fablabbcn/smartcitizen-kit-2x/hardware/README.md

Smart Citizen Kit 2.X Hardware
==============================

This folder contains the Eagle design files for the Smart Citizen Kit 2.X, as well as the silkscreen and manufacturing files:

## SCK 2.1 (discontinued for sensor availability)

- Production files:
    + [SCK 2.1 Data Board production files](SCK2.1/SCK_DATA_BOARD_2.1/SCK_DATA_BOARD_2.1_PRODUCTION.zip)
    + [SCK 2.1 Urban Board production files](SCK2.1/SCK_URBAN_BOARD_2.1/SCK_URBAN_BOARD_2.1_PRODUCTION.zip)
- Design files:
    + [SCK 2.1 Data Board design files](SCK2.1/SCK_DATA_BOARD_2.1)
    + [SCK 2.1 Urban Board design files](SCK2.1/SCK_URBAN_BOARD_2.1)
- [Silkscreen](SCK2.1/SCK_2.1_SILKSCREEN.pdf)
- [Test plan](SCK2.1/test/SCK_2.1_TESTPLAN.pdf), also [at the docs](https://docs.smartcitizen.me/assets/notes/SCK_2.1_TESTPLAN.pdf)
- [Bootloader](SCK2.1/bootloader)

## SCK 2.2 (only for some projects)

- Production files:
    + [SCK 2.2 Data Board production files](SCK2.2/SCK_DATA_BOARD_2.2/SCK_DATA_BOARD_2.2_PRODUCTION.zip)
    + [SCK 2.2 Urban Board production files](SCK2.2/SCK_URBAN_BOARD_2.2/SCK_URBAN_BOARD_2.2_PRODUCTION.zip)
- Design files:
    + [SCK 2.2 Data Board design files](SCK2.2/SCK_DATA_BOARD_2.2)
    + [SCK 2.2 Urban Board design files](SCK2.2/SCK_URBAN_BOARD_2.2)
- [Silkscreen](SCK2.2/SCK2.2_SILKSCREEN.pdf)
- [Test plan](SCK2.2/test/SCK2.2_TESTPLAN.pdf)
- [Bootloader](SCK2.2/bootloader)

## SCK 2.3 (current)

- Production files:
    + [SCK 2.3 Data Board production files](SCK2.3/SCK_DATA_BOARD_2.3/SCK_DATA_BOARD_2.3_PRODUCTION.zip)
    + [SCK 2.3 Urban Board production files](SCK2.3/SCK_URBAN_BOARD_2.3/SCK_URBAN_BOARD_2.3_PRODUCTION.zip)
- Design files:
    + [SCK 2.3 Data Board design files](SCK2.3/SCK_DATA_BOARD_2.3)
    + [SCK 2.3 Urban Board design files](SCK2.3/SCK_URBAN_BOARD_2.3)
- [Test plan](SCK2.3/test/SCK2.3_TESTPLAN.pdf)
- [Bootloader](SCK2.3/bootloader)

Note: for Data Board schematics, see [SCK_DATA_2.1 folder](SCK2.1/SCK_DATA_BOARD_2.1)

## License

All the software is released under [GNU GPL v3.0](../LICENSE) and the hardware design files under [CERN OHL v1.2](LICENSE)
