fablabbcn/smartcitizen-kit-2x/hardware/SCK2.3/SCK_DATA_BOARD_2.3/SCK_DATA_BOARD_2.3_for_Manufacture/03-SCK_DATA_BOARD_2.3_PCB_specification.xlsx

Sheet: Template
PCB Name 名称
Board Size 尺寸 | Length*width (Unit:mm) | 58.19 | * | 56.41
Material 板材 |  | Special Requirement:
Layers 层数 |  | Special Requirement:
Thickness 厚度 |  | Special Requirement:
Copper Weight 铜厚 |  | Special Requirement:
Soldermask Color 阻焊颜色 |  | Special Requirement:
Silkscreen Color 丝印颜色 |  | Blue
Surface Finishing 焊盘喷镀 |  | Special Requirement:
Via soldermask 阻焊覆盖 |  | Special Requirement:
Mini trace/spacing 最小线宽 |  | Special Requirement:
Mini hole size 最小孔径 |  | Special Requirement:
Special requirements 特殊工艺
 | Other Special requirements：

Sheet: Parameter
PCB Material | Layers | Thickness | Copper Weight | Soldermask Color | Silkscreen Color | Surface Finishing | Via soldermask | Mini trace/spacing | Mini hole size
FR-4 | 1 Layer | 0.6mm | 0.5 oz | Green | White | HASL Lead Free(RoHS) | Soldermask Cover | 4 mil or 0.10 mm | 6 mil or 0.15 mm
Flexible Printed Circuit | 2 Layer | 0.8mm | 1 oz | Red | Black | ENIG | Soldermask Opening | 5 mil or0.13 mm | 8 mil or 0.2 mm
Rogers 4003 | 4 Layer | 1.0mm | 2 oz | Blue | Yellow | OSP |  | 6 mil or 0.15 mm | 10 mil or 0.25 mm
Rogers 4350 | 6 Layer | 1.2mm | 3 oz | Black | Red | Immersion Tin |  | 8 mil or 0.20 mm | 12 mil or 0.30 mm
Taconic Series | 8 Layer | 1.3mm | Other | White | Other | Immersion Sliver
Aluminum-based material | 10 Layer | 1.6mm |  | Green Matte |  | Hard Gold
RF-35 | 12 Layer | 2.0mm |  | Blue Matte |  | Other
Arlon | 14 Layer | 2.5mm |  | Black Matte
Other | 16 Layer | 3.0mm |  | Other
 | Other | Other
