fablabbcn/smartcitizen-kit-2x/hardware/SCK2.3/SCK_URBAN_BOARD_2.3/SCK_URBAN_BOARD_2.3_for_Manufacture/01-SCK_URBAN_BOARD_2.3_BOM.xlsx

Quantity | Designator | Value/Tolerance | Footprint | Manufacturer | Manufacturer Part Number | Description | Seeed OPL
1 | R1 | 100K | R0402 | Yageo | RC0402FR-07100KL | SMD-RES-100K-1%-1/16W(0402)
1 | R2 | 3M3 | R0402 | Yageo | RC0402FR-073M3L | Thick Film Resistors - SMD 3.3 MOhms 62.5mW 0402 1%
9 | C1, C2, C3, C4, C5, C6, C7, C8,C11 | 100n | C0402 | Yageo | CC0402KRX7R8BB104 | CERAMIC-100NF-25V-10%-X7R(0402)
1 | C9, C10 | 10u | C0603 | Yageo | CC0603KRX5R6BB106 | CERAMIC-10UF-10V-10%-X5R(0603)
6 | L1, L2, L3, L4, L5, L6 | MPZ1005S121C | L0402 | TDK Corporation | MPZ1005S121CT000 | FERRITE BEAD 120 OHM 0402 1LN
1 | S1 | MPL3115A2S | LGA8 | NXP Semiconductors | MPL3115A2ST1 | Board Mount Pressure Sensors Horizon I2C ST |  | https://eu.mouser.com/ProductDetail/NXP-Semiconductors/MPL3115A2ST1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
1 | S2 | Spectral UVA/B/C Sensor | OLGA16 | AMS | AS7331-AQFM | Spectral UVA/B/C Sensor |  | https://www.mouser.com/catalog/specsheets/amsOsram_AS7331_DS001047_1-00.pdf
1 | S3 | MIC MEMS DIGITAL I2S OMNI -26DB | ICS-43432 | TDK InvenSense | ICS-43432 | MIC MEMS DIGITAL I2S OMNI -26DB
1 | S4 | SENSOR HUMID/TEMP 5V I2C 2% SMD | DFN8_STH3X-DIS | Sensirion AG | SHT31-DIS-F | SENSOR HUMID/TEMP 5V I2C 2% SMD
1 | S5 | IC AMBIENT LIGHT SENSOR 6-WSOF | WSOF6 | Rohm Semiconductor | BH1730FVC-TR | IC AMBIENT LIGHT SENSOR 6-WSOF
1 | PM_SENSOR | SM06B-GHS-TB | SM06B-GHS-TB | JST Sales America Inc. | SM06B-GHS-TB | CONN HEADER SMD R/A 6POS 1.25MM |  | https://www.digikey.es/es/products/detail/jst-sales-america-inc/SM06B-GHS-TB-LF-SN/807836?productid=
1 | CONN_DATA | CONN HEADER SMD 16POS 2.54MM | PINHD_2X8_SMD_MALE_UNHOLED | Molex, LLC | 15910160 | CONN HEADER SMD 16POS 2.54MM
