fablabbcn/smartcitizen-kit-2x/hardware/SCK2.3/SCK_DATA_BOARD_2.3/SCK_DATA_BOARD_2.3_for_Manufacture/01-SCK_DATA_BOARD_2.3_BOM.xlsx

Quantity | Designator | Value/Tolerance | Footprint | Manufacturer | Manufacturer Part Number | Description | Seeed OPL
17 | R2, R3, R5, R12, R13, R14, R16, R17, R22, R23, R24, R25, R26, R27, R28, R29, R30 | 10K 1/16W | R0402 | Yageo | RC0402FR-0710KL | SMD-RES-10K-1%-1/16W(0402) | 301010047
5 | R4, R18, R19, R20, R21 | 1K | R0402 | Yageo | RC0402JR-071KL | SMD-RES-1K-5%-1/16W(0402) | 301010006
4 | R6, R7, R8, R9 | 100K 1/16W | R0402 | Yageo | RC0402JR-07100KL | SMD-RES-100K-5%-1/16W(0402) | 301010033
1 | R10 | 47K | R0402 | Yageo | RC0402JR-0747KL | SMD-RES-47K-5%-1/16W(0402) | 301010005
1 | R11 | 68K | R0402 | Yageo | RC0402JR-0768KL | SMD-RES-68K-50V-5%(0402) | 301010496
1 | R15 | 330R | R0402 | Yageo | RC0402FR-07330RL | SMD-RES-330R-1%-1/16W(0402) | 301010466
9 | C1, C2, C4, C10, C22, C23, C24, C25, C29 | 100nf | C0402 | Yageo | CC0402KRX7R8BB104 | CERAMIC-100NF-25V-10%-X7R(0402) | 302010024
1 | C3 | 10nf | C0402 | Yageo | CC0402KRX7R9BB103 | CERAMIC-10NF-50V-10%-X7R(0402) | 302010006
2 | C5, C8 | 10uf | C1206 | Yageo | CC1206KKX5R8BB106 | CERAMIC-10UF-25V-10%-X5R(1206) | 302010181
1 | C7 | 47uf | C0805 | Yageo | CC0805MKX5R5BB476 | CERAMIC-47UF-6.3V-20%-X5R(0805) | 302010166
1 | C9 | 47uf | C1210 | Murata Electronics North America | GRM32ER71A476ME15L | CERAMIC-47UF-10V-20%-X7R(1210) | 302010252
4 | C6, C11, C26, C28 | 1uf | C0805 | Yageo | CC0805KKX7R8BB105 | CERAMIC-1UF-25V-10%-X7R(0805) | 302010179
4 | C12, C13, C17, C18 | 4.7uf | C0603 | Yageo | CC0603KRX5R6BB475 | CERAMIC-4.7UF-10V-10%-X5R(0603) | 302010111
1 | C14 | 47nf | C0402 | Yageo | CC0402KRX7R8BB473 | CERAMIC-47NF-25V-10%-X7R(0402) | 302010002
3 | C15, C16, C27 | 10uf | C0603 | Yageo | CC0603KRX5R6BB106 | CERAMIC-10UF-10V-10%-X5R(0603) | 302010103
2 | C19, C20 | 22pf | C0402 | Yageo | CC0402JRNPO9BN220 | CERAMIC-22PF-50V-5%-NPO(0402) | 302010018
1 | C21 | 2.2nf | C0402 | Yageo | CC0402KRX7R9BB222 | CERAMIC-2.2NF-50V-10%-X7R(0402) | 302010022
1 | L1 | SMD Ferrite Bead 470R-2A | L0805 | WELL | WLB2012-471T20 | SMD Ferrite Bead 470R-2A | 303030008
4 | L3, L4, L5, L6 | MPZ1005S121C | L0402 | TDK Corporation | MPZ1005S121CT000 | FERRITE BEAD 120 OHM 0402 1LN
1 | L2 | 1uH 2.5A | L1210 | Murata Electronics North America | LQH32PN1R0NNCL | FIXED IND 1UH 2.5A 43.2 MOHM SMD
1 | L7 | 6.8uH 1A | L1212 | Bourns Inc. | SRN3015TA-6R8M | FIXED IND 6.8UH 1A 160 MOHM SMD
1 | D1 | 30V-0.5A | SOD-323-2 | Leshan Radio | LRB551V-30T1G | SMD-DIODE-SCHOTTKY-30V-0.5A(SOD-323) | 304020004
1 | Y1 | Crystal 32,768Khz | FC_135 | Abracon LLC | ABS07-32.768KHZ-T | CRYSTAL 32.7680KHZ 12.5PF SMD | 306010055
1 | IC1 | PMIC | SOT-23-5 | ETA Solutions | ETA1036-50S2F-T | PMIC-ETA1036-50S2F-T(SOT23-5) | 310030153
1 | IC2 | IC CHARGER | 24-PIN_VQFN_THPAD | Texas Instruments | BQ24259RGER | IC CHARGER NVDC-1 USB I2C 24VQFN
1 | IC3 | IC REG 3.3V 2A | DFN6_3X3MM | STMicroelectronics | LD39200PU33R | IC REG LINEAR 3.3V 2A 6DFN
1 | IC4 | WIFI MODULE | ESP-12F |  | ESP-12F | ESP8266 WiFi/802.11 Module
1 | IC5 | IC MCU | QFN48-7X7 | Microchip Technology | ATSAMD21G18A-MUT | IC MCU 32BIT 256KB FLASH 48QFN | 310010095
1 | IC6 | IC FLASH | SOIC8 | Cypress Semiconductor Corp | S25FL064LABMFI010 | IC FLASH 64M SPI 108MHZ 8SOIC
1 | LED1 | RGB LED PLCC4 | PLCC-4 | Broadcom Limited | ASMB-MTB1-0B3A2 | Standard LEDs - SMD PLCC4,T/Mt,BS/WF Silicone RGB
1 | LED2 | LED YELLOW 0402 SMD | DIODE_0402_R | Vishay Semiconductor Opto Division | VLMY1500-GS08 | LED YELLOW 0402 SMD | 304090016
1 | LED3 | LED BLUE 0402 SMD | DIODE_0402_R | Vishay Semiconductor Opto Division | VLMB1500-GS08 | LED BLUE 0402 SMD | 304090075
1 | F1 | PTC RESET FUSE 13.2V 750MA 1812 | L1812 | Bourns Inc. | MF-MSMF075-2 | PTC RESET FUSE 13.2V 750MA 1812
1 | F2 | PTC RESET FUSE 12V 1.5A 1812 | L1812 | Bourns Inc. | MF-MSMF150/12-2 | PTC RESET FUSE 12V 1.5A 1812
2 | Q1, Q3 | MOSFET 2P-CH 20V 4.5A SC70-6L | SC70-6L | Vishay Siliconix | SIA923AEDJ-T1-GE3 | MOSFET 2P-CH 20V 4.5A SC70-6L
1 | Q2 | MOSFET Nch 30V Vdss SOT-323 SC-70; 300mA Id | SOT323-3 | ROHM Semiconductor | RJU003N03FRAT106 | MOSFET Nch 30V Vdss SOT-323 SC-70; 300mA Id
1 | P1 | SMD Button Side Plast;SPST;180gf | TS-1188E | ShenZhen Best Electronics | TS-1188E | SMD Button Side Plast;SPST;180gf | 311020023
1 | P2 | Tactile Switches 5.2x5.2x1.5mm 260gf | SW4-SMD-5.2X5.2X1.5MM | ALPS | SKQGADE010 | Tactile Switches 5.2x5.2x1.5mm 260gf | 311020017
1 | SD1 | SD_CARD_SOCKETTF-01 | TF-01 | ShenZhen Best Electronics | TF-01 | SD_CARD_SOCKETTF-01 | 320090008
1 | TVS1 | SMD Diode TVS;4-Ch USB ESD Solution with-SON-6（1.45x1） | DRY6 | Texas Instruments | TPD4S012DRYR | SMD Diode TVS;4-Ch USB ESD Solution with-SON-6（1.45x1） | 304050020
1 | BAT | CONN HEADER SMD R/A 2POS 2MM | S2B-PH | JST | S2B-PH-SM4-TB(LF)(SN) | CONN HEADER SMD R/A 2POS 2MM | 320110026
1 | CONN_DATA | CONN HDR 16POS 0.1 TIN SMD | PINHD_2X8_SMD_FEMALE_UNHOLED | Sullins Connector Solutions | NPTC082KFMS-RC | CONN HDR 16POS 0.1 TIN SMD
1 | USB | CONN RCPT USB2.0 MICRO B SMD R/A | USB_MICRO_B_AT | Amphenol ICC (FCI) | 10118193-0001LF | CONN RCPT USB2.0 MICRO B SMD R/A | 320010005
1 | X1 | SMD Grove Female Header-Beige;4P-2.0 | HW4-SMD-2.0 | TAIFENG | 1125S-SMT-4P | SMD Grove Female Header-Beige;4P-2.0 | 320110030
1 | SWD | CONN HEADER SMD 10POS 1.27MM | 2X05_SMD_1.27MM | Amphenol ICC (FCI) | 20021121-00010C4LF | CONN HEADER SMD 10POS 1.27MM | 320020119
