fablabbcn/smartcitizen-kit-2x/esp/build_data/build_index.html

# Loading... please wait!

Smart Citizen Kit Setup

Start Next

## WELCOME TO SMART CITIZEN KIT CONFIGURATION

#### FIRMWARE UPDATE IS NEEDED!

#### Upload your ESP firmware here:

Size: {{file.size}}

If you need more information please visit docs.smartcitizen.me

#### Is this your first time here?

Before you start, make sure you visit start.smartcitizen.me.

In Online mode, you need to obtain a Device Key (token) to send data to the platform.

Online
(Wi-Fi) Offline
(SD-Card)

#### Device key

Token: {{usertoken}}

{{ this.usertokenError }}

Next

#### WiFi connection

SSID (Network name)

Password

Connect

#### Trying to connect..

Your kit is now trying to connect to the online platform, and this website has no connection to the kit anymore.

Check the light on your Kit:

- Your Kit light should be blue. If it's blinking fast, there is a problem with the WiFi credentials. Press the button until the light turns red and repeat the process.

#### Your kit status

Mode | {{ kitstatus.net }}
Wifi | {{ kitstatus.wifi }}
Battery | {{ kitstatus.battPercent }}
Published | {{ kitstatus.last_publish }}

If you want to run a full setup again, press the button on your Kit for 15 seconds and reconnect, and refresh this page.

Edit Wifi

#### SD Card

Your Kit can store the data on a microSD card. Later on, you can read it the CSV files with your computer.

This is useful when no Wi-Fi is available at your location.

You will need to insert a valid microSD card and click the button below.

Once you do it, you will be disconnected and the Kit will start recording data.

START LOGGING

Force allow firmware update

#### Kit info:

- {{index}}: {{value}}

Copy info to clipboard

Log:

- {{x}}

Enable Debug buttons

Vue.js version: {{vueVersion}}

#### Empty page

SAM: {{ kitstatus.SAMversion }} - ESP: {{ kitstatus.ESPversion }}

{{ currentPage }} - {{ page[currentPage].footer }}

Development mode

Intervals

##### Global - Intervals

How often should the kit go online to publish the data?

Publish interval hours: {{publishinterval}}

How often should the kit poll the sensors?

Reading interval seconds: {{readinginterval}}

Estimated battery duration: {{ Number(publishinterval * (readinginterval / 100)).toFixed(1) }} Hours

SD Card

##### SD CARD

The kit should never post my data with Wifi

Log *only* to SD Card

When your kit runs out of battery, it loses the time. This will allow the kit to go online and fetch the time.

If you don't, all your measurements will be dated from the year 1971

Use Wifi to sync time

Don't forget to give the kit your wifi password!

Browser time: | {{ browsertime }}
Device time: | {{ devicetime }}
Diff: | {{ browsertime - devicetime }}

When you click this button the device will go offline and start working.

(You will loose connection to the device)

Start logging on SD Card

Show sensors

##### Sensors

The new SCK allows you to configure each sensor independently.

Light

Microphone

CO2

Thermometer
