fablabbcn/smartcitizen-kit-2x/hardware/SCK2.2/SCK_URBAN_BOARD_2.2/SCK_URBAN_BOARD_2.2_for_Manufacture/05-SCK_URBAN_BOARD_2.2_Assembly Drawing TOP.png

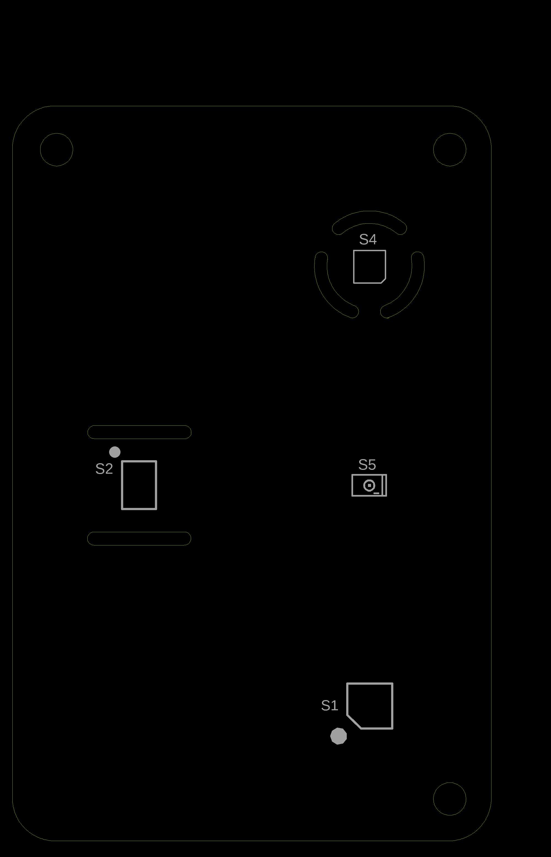
hardware/SCK2.2/SCK_URBAN_BOARD_2.2/SCK_URBAN_BOARD_2.2_for_Manufacture/05-SCK_URBAN_BOARD_2.2_Assembly Drawing TOP.png
