fablabbcn/smartcitizen-kit-2x/hardware/SCK2.3/SCK_DATA_BOARD_2.3/SCK_DATA_BOARD_2.3_for_Manufacture/05-SCK_DATA_BOARD_2.3_Assembly Drawing.png

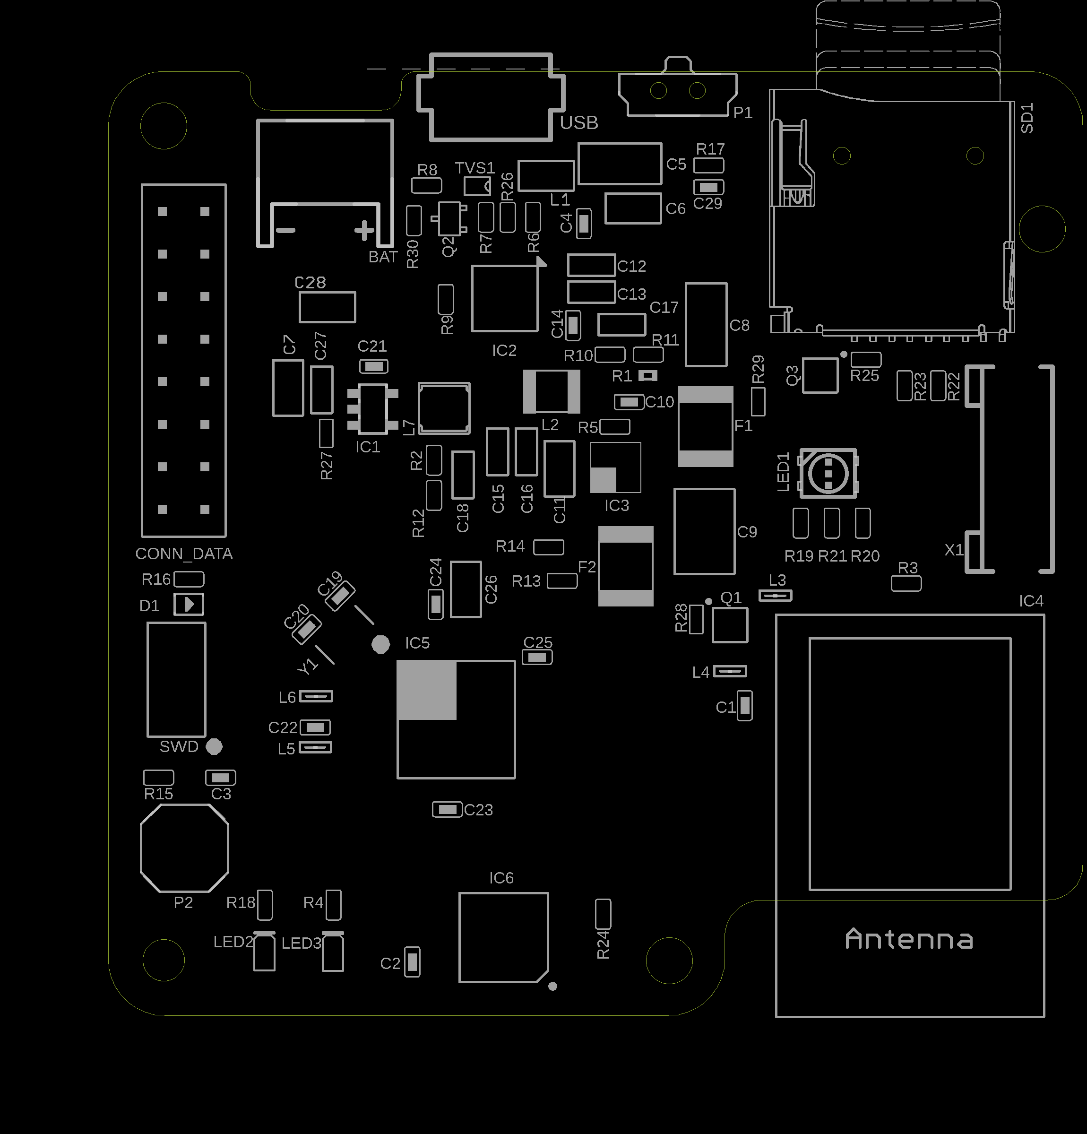
hardware/SCK2.3/SCK_DATA_BOARD_2.3/SCK_DATA_BOARD_2.3_for_Manufacture/05-SCK_DATA_BOARD_2.3_Assembly Drawing.png
