fablabbcn/smartcitizen-kit-2x/hardware/SCK2.3/SCK_URBAN_BOARD_2.3/SCK_URBAN_BOARD_2.3_for_Manufacture/05-SCK_URBAN_BOARD_2.3_Assembly Drawing TOP.png

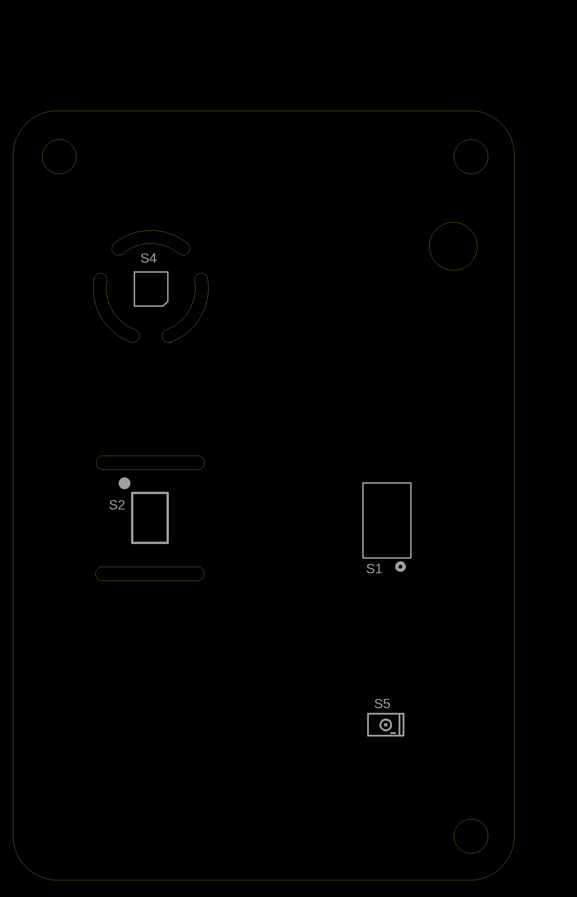
hardware/SCK2.3/SCK_URBAN_BOARD_2.3/SCK_URBAN_BOARD_2.3_for_Manufacture/05-SCK_URBAN_BOARD_2.3_Assembly Drawing TOP.png
