fablabbcn/smartcitizen-kit-2x/(threads)

Thread 7 (2019-12-12):

CCS811 Reference Baseline Management

nicpom, 2019-12-12:
At present, SCK read the latest CCS811 baseline when device is powered OFF, and rewrite it after power ON. The same action is performed during hardware reset.

A better management could be implemented, where a "reference" baseline is maintained in non volatile memory, and, if available, written in case of power cycle or reset. This would allow the user to calibrate the sensor placing it in a clean environment, and saving that baseline, thus protecting it by accidental deletion due to uncontrolled power down. It would be also useful to restore the sensor to a known condition in case of doubt on current baseline.

The procedure of saving the reference baseline should be implemented with a combination of hardware buttons. The use of PC and shell could be too long and invasive and affect the baseline.

bryn51, 2021-09-30:
I suggest that it is better to implement the procedure to saving of a baseline by way of the CLI, rather than button combination.  The reason I say this is that when the kit is deployed inside a smart citizen station, the data board is mounted deep within the enclosure; requiring a disassembly to get at all of the buttons.  Only one button is available externally.  It is of course possible to attach a set of buttons, but that brings about other challenges (namely finding a grove socket to attach them to).
Whereas implementing a new CLI command is relatively simpler (edit of command.cpp etc)

Thread 8 (2019-12-13):

SCK 2.1 Power Management

nicpom, 2019-12-13:
In bq24259 datasheet, it is recommended to put a 10 microF capacitor close to BAT pin (pin13). This capacitor is not present in schematic, version of 17/09/2019. Even if not optimal, the C28 capacitor could be increased to that value.

Capacitor C5 at USB close to USB connector could be increased to 1000 microF to obtain a more stable operation in presence of long external power cables.

Thread 11 (2020-02-13):

Discussion for using LWM2M

bitvijays, 2020-02-13:
Dear SCK Team,

Hope you are doing well. Thank you for your awesome work on the SCK Kit. We love it and trying to utilize it for a research experiment. We have already ordered multiple (~150) kits.

I just wanted to have a discussion on implementation of LWM2M protocol for the management of SCK kit. Currently, SCK sends information directly to the SCK platform using MQTT.

Currently, I am playing with [WakaamaNode](https://openhab-nodes.github.io/wakaamaNode/) trying to connect with a LWM2M server.

This is just issue to track if this would be of any interest to anyone who can help or guide a bit.

Yours Sincerely,
Vijay

bitvijays, 2021-06-24:
Hey @oscgonfer Hope you are doing well. Thank you for your support.

We were wondering if there are any thoughts on combining SCK with LwM2M?

oscgonfer, 2021-06-28:
Hi

As for now, it's not in our roadmap. We are not really experts on LwM2M and seems a bit far for us. If you have more ideas or are interested in collaborations, maybe we can discuss through info@smartcitizen.me

oscgonfer, 2024-11-25:
Closing as stale.

Closed 2024-11-25.

Thread 14 (2020-06-23):

SCK 2.1 Battery Charging

bryn51, 2020-06-23:
sorry, I placed this in the wrong place.  Unable to delete

Closed 2020-06-23.

Thread 24 (2021-06-24):

Reading SCK data via USB?

bitvijays, 2021-06-24:
Dear SCK Team,

Hope you are doing well. Thank for your support.

We were wondering if it is possible to read the SCK Data using USB? Mainly for those scenarios where Wi-Fi is not available ? and the SCK kit is attached to a Raspberry Pi using a USB. Maybe a script could be executed to read the data using USB?

Kind Regards,
Vijay

oscgonfer, 2021-06-28:
Hi @bitvijays

Thanks for writing. Yes, it is, you can [Use the Shell](https://docs.smartcitizen.me/Guides/getting%20started/Using%20the%20Shell/) and use `monitor` commands (more info [here](https://docs.smartcitizen.me/Guides/getting%20started/Using%20the%20Shell/#readmonitor-some-sensors)). You can also have a look at [this repository](https://github.com/fablabbcn/smartcitizen-tools) for some tools on how to interact with the kit. In particular, you can use the [serialdevice class](https://github.com/fablabbcn/smartcitizen-tools/tree/master/serialtools) to talk to the kit via USB.

Let us know if it works!

bitvijays, 2021-07-01:
Thank you @oscgonfer 👍 I will experiment with these.

fluxion-t, 2022-12-30:
I am also interested in this. I am able to connect to the kit via serial and extract data through it. However:

1) if I use the 'monitor' command, the rate of sensor reading is really high. Is there a way to reduce it? Or at least, is this high reading rate adding stress to the sensors? Also, in this mode we cannot write to the SD card.

2) if using config -mode sdcard (etc) the kit refuses to make readings unless the clock is synced, and for that it seems to need a WiFi connection that we may not have.

I would like to be able to opt out of clock syncing (since we can read time from the computer) and still being able to take measurements, so that I can set up a slow rate of readings and still write to a SD card (in addition to obtain the data from serial)

Closed 2021-07-01.

Thread 25 (2021-07-18):

Shell readint and pubint commands do not work

4-3is4-me, 2021-07-18:
(2021-07-13T08:58:47Z) Published OK, erasing from memory
shell -on
Shell mode: on
SCK > version
Hardware Version: 2.1
SAM Hardware ID: A91B59E50573738352E3120FF15180F
SAM version: 0.9.7-1b30422
SAM build date: 2020-06-23T16:08:01Z
ESP MAC address:
ESP version: 0.9.2-a91f850
ESP build date: 2019-08-20T13:17:16Z
SCK >
SCK > config -readint 300
Saved configuration on eeprom!!
– New config –
Mode: network
Publish interval: 180
Reading interval: 60
Wifi credentials: xxxxxxxxxxxxxxxxxxxx
Token: xxxxxxxxxxxxxxx
Mac address: xxxxxxxxxxxxxxx
SCK > Synced config with ESP!!
config -pubint 1800
For now we can only store safely 3 set of readings on RAM memory, sorry.
Saved configuration on eeprom!!
– New config –
Mode: network
Publish interval: 180
Reading interval: 60
Wifi credentials: xxxxxxxxxxxx
Token: xxxxxxxxxxxxxx
Mac address: xxxxxxxxxxxxxxxx
SCK > Synced config with ESP!!

oscgonfer, 2021-07-28:
Hi,

I recommend you make a firmware update for this. This has been solved in recent commits.

4-3is4-me, 2021-07-29:
Thanks, but I have hit issues with the build, any tips greatly appreciated! Full details https://pastebin.com/0fWwggVw

:

pi@sticky:~/gitrepos/smartcitizen-kit-21 $ python3 make.py build sam -v
Traceback (most recent call last):
  File "make.py", line 53, in <module>
    kit = sck.sck()
  File "./tools/sck.py", line 57, in __init__
  File "/usr/lib/python3.7/subprocess.py", line 395, in check_output
    **kwargs).stdout
  File "/usr/lib/python3.7/subprocess.py", line 472, in run
    with Popen(*popenargs, **kwargs) as process:
  File "/usr/lib/python3.7/subprocess.py", line 775, in __init__
    restore_signals, start_new_session)
  File "/usr/lib/python3.7/subprocess.py", line 1522, in _execute_child
    raise child_exception_type(errno_num, err_msg, err_filename)
FileNotFoundError: [Errno 2] No such file or directory: 'pio': 'pio'

And:

pi@sticky:~/gitrepos/smartcitizen-kit-21/sam $ pio run
Processing sck2 (platform: atmelsam@5.0.1; board: sck2; framework: arduino)
-------------------------------------------------------------------------------
Verbose mode can be enabled via `-v, --verbose` option
CONFIGURATION: https://docs.platformio.org/page/boards/atmelsam/sck2.html
PLATFORM: Atmel SAM (5.0.1) > Smartcitizen Kit v2.0
HARDWARE: SAMD21G18A 48MHz, 32KB RAM, 256KB Flash
DEBUG: Current (atmel-ice) External (atmel-ice, blackmagic, jlink)
PACKAGES:
 - framework-arduino-samd 1.8.9
 - framework-cmsis 1.40500.0 (4.5.0)
 - framework-cmsis-atmel 1.2.2
 - toolchain-gccarmnoneeabi 1.70201.0 (7.2.1)
Converting SmartCitizenKit.ino
sh: 1: arm-none-eabi-g++: not found
*** Error 127
AssertionError: :
  File "/home/pi/.platformio/penv/lib/python3.7/site-pac...............

vicobarberan, 2021-09-28:
You can download the latest [release](https://github.com/fablabbcn/smartcitizen-kit-21/releases/tag/0.9.8) binaries and update (guide [here](https://docs.smartcitizen.me/Guides/firmware/Update%20the%20firmware/)) without building the firmware by yourself.

Closed 2021-09-28.

Thread 27 (2021-07-31):

MQTTData Extra data

bitvijays, 2021-07-31:
Dear SCK Team,

Hope you are doing well. After upgrading to the latest firmware, it seems that the MQTT data contains extra data.

#### Version
```
SCK > version
Hardware Version: 2.1
SAM Hardware ID: 6D8DAA9850515157382E3120FF0E3111
SAM version: 0.9.7-d42ed80
SAM build date: 2021-07-31T13:40:50Z
ESP MAC address: CE:50:E3:18:FD:A1
ESP version: 0.9.2-8b3c4e0
ESP build date: 2021-07-31T15:08:26Z
```

#### MQTT Data

Sample 1:
```
{"data":[{"recorded_at":"2021-07-31T16:41:48Z","sensors":[{"id":10,"value":-1},{"id":14,"value":177},{"id":55,"value":24.00},{"id":56,"value":57.36},{"id":53,"value":48.02},{"id":58,"value":100.75},{"id":113,"value":1.00},{"id":112,"value":408.00}p","value":8140},{"id":"ns","value":"ntp.smar]}]}
```

Sample 2:
```
{"data":[{"recorded_at":"2021-07-31T18:21:35Z","sensors":[{"id":10,"value":-1},{"id":14,"value":13},{"id":55,"value":24.56},{"id":56,"value":57.28},{"id":53,"value":48.32},{"id":58,"value":100.80},{"id":113,"value":3.00},{"id":112,"value":425.00}","value":"0.9.7-d42ed80"},{"id":"sam_]}]}
```

Extra data in above MQTT

```
p","value":8140},{"id":"ns","value":"ntp.smar
```

This might be because of the memory issues?

Let me know your thoughts.

oscgonfer, 2021-10-01:
@vicobarberan ?

bitvijays, 2021-10-01:
@oscgonfer This might have been fixed with latest ESP and SAM firmware upgrade. I will test it out. Closing this as of now.

Closed 2021-10-01.

Thread 29 (2021-09-24):

make.py : error when executing tools\sck.py

bryn51, 2021-09-24:
Following an installation of 'requests' module in python;
when executing the file 'make.py' in a windows 10 environment using 'powershell' I observed an error when running the command: '> python make.py build sam -v'

The error pointed to tools\sck.py which delivered an error "file not found" (at the end, after 4 intermediate errors); and the script failed to run.
Here is a screenshot of the error.:
![Uploading pwrshellsnapshot-2.png…]()

bryn51, 2021-09-24:
![Uploading pwrshellsnapshot-2.png…]()

Closed 2021-10-01.

Thread 30 (2021-11-07):

Insufficient documentation on battery connector

motinis, 2021-11-07:
The only thing I can see in the documentation is JST-2. This isn't informative enough to know which connector will work. For example, will JST-PHR-02 work?

oscgonfer, 2021-11-18:
Hi,

Having checked the datasheet in: https://docs.smartcitizen.me/_FAQ/#what-batteries-are-shipped-with-the-kits, the JST-PHR-02 is the right connector.

Beware of polarity. When looking at the connector from the top side of the Data Board (white side) you should have positive to the left. Will update this on the same link as above in the documentation.

oscgonfer, 2021-11-18:
Updated in docs in: https://github.com/fablabbcn/smartcitizen-docs/commit/fbc6911107fc8692e8bd81acc9885ff9b106b458

Closed 2021-11-18.

Thread 44 (2023-07-27):

ams AS7331 sensor integration

oscgonfer, 2023-07-27:
This issue is to keep track the implementation of the ams AS7331 sensor. This is a UVA/B/C sensor, recently commercially available that will be included in the SCK Urban Board 2.2.

* Site: https://ams.com/as7331

**Current Status**

Work has been done in the `dev` branch to integrate it but it has not been concluded. The sensor itself is not easy to implement, so a careful review of the datasheet is needed.

oscgonfer, 2023-08-01:
Notes

This sensor needs to be implemented from scracth. We can _talk_ to the sensor, and we detect it. But there is no implementation done yet.

Closed 2023-12-20.

Thread 46 (2023-07-27):

SEN5X Sensor Integration

oscgonfer, 2023-07-27:
This issue is to map the integration of the Sensirion SEN5X PM sensor.

- Site: https://sensirion.com/products/catalog/SEN50/, https://sensirion.com/products/catalog/SEN54 and https://sensirion.com/products/catalog/SEN55

**Current Status**

- Sensor integration has been working on preliminar tests, but current implementation of the `dev` branch is returning `null` for all metrics.
- We also need to understand how to handle the cleaning sequence of the sensor (it basically spins up the fan at max. speed). This needs to be carefully aligned during the boot process to avoid coinciding with the ESP boot or other power consumers. I believe this is already done, but would be good to check again.

oscgonfer, 2023-08-01:
**Autocleaning**
Needs to be checked if it happens when it should (every 7 days) no matter the status. The first time the kit sees the SEN5X, after 7 days it will clean it, but then if we reflash, it should do it always at the desired interval
- [ ] Check that autocleaning works at desired interval

**VOCs/NOx Index**
This is an important final step for the implementation. It is not resolved at the moment. Currently there is a _hack_, in the fact that when we leave the measurement mode, and go to idle, we are breaking the "flow" of the index algorithm and we need to review the state machine and check the implementation for it to work.
- [ ] Test the functionality of saving and restoring of state check

**null**
Debug mode and check.

oscgonfer, 2024-11-25:
Missing work on NOx/VOC Index. Currently is returning highly incorrect data (mostly constant) and with significant device overheat.

Thread 48 (2023-07-27):

SD Card implementation

oscgonfer, 2023-07-27:
So the SD card library was upgraded in `dev` branch with [refurbishment and new features](https://github.com/fablabbcn/smartcitizen-kit-21/commit/efa397447adaeed935185969f0ade79537cf6d5d). These issue is to map the overall status of this improvement, the sd-card library implementation and overall sd-card handling status.

Specially in sd-card (offline) mode it can lead to a warning or a more critical data loss if/when flash memory runs out.

This is also linked to the new CSV handling also included in that commit, which now has a "hash" check for the CSV header. This is done so that (dis)appearing sensors don't mess up with the current files. Also, there are some TODOs to consider in https://github.com/fablabbcn/smartcitizen-kit-21/blob/dev/sam/src/SckBase.cpp#L1252-L1253

In general, an overall review of the implementation with possible cases is necessary taking into account:
1. the new library
2. csv header, naming...
3. flash system and the particularity of old data posted after sd-card insertion
4. filesystem utils (for instance to pipe the files to terminal output)

oscgonfer, 2023-08-01:
In principle this is more testing than anything else.

Thread 49 (2023-07-27):

Health reports and stability of connection in saturated Wi-Fi environments

oscgonfer, 2023-07-27:
This issue is to map the potential solutions to **prevention** and **diagnosis** of issues in saturated WiFi environments. These environments are still under assessment, but WiFi networks with many devices connected at the same time, where connections are slow even for a laptop, have been presenting issues for the kit connection stability.
## Diagnosis
This is mostly done by publishing more information to the platform. Directly linked to https://github.com/fablabbcn/smartcitizen-api/issues/238 in terms of health metrics.

### Status

- [x] Implemented WiFi strength signal and SD card presence as sensors
- [X] Send health report on reboot in `hardware_info` mqtt. See above issue for more details on back-end side

Current implementation in `hardware_info` is done, but we need to check if we want to send something else:
https://github.com/fablabbcn/smartcitizen-kit-21/blob/dev/sam/src/SckBase.cpp#L805-L858

## Prevention

This would be the main topic of discussion of this issue, although there is no preliminary good solution from firmware side. On the hardware side there will be better options with other chipsets. Currently, thanks to the integration of the [Flash](https://docs.smartcitizen.me/Components/Flash%20Storage/), there is maybe no need to do anything, but ideas welcome.

oscgonfer, 2024-11-25:
Closed for lack of activity. Reopen if needed.

Closed 2024-11-25.

Thread 51 (2023-07-27):

Watchdog implementation

oscgonfer, 2023-07-27:
A watchdog implementation was started in https://github.com/fablabbcn/smartcitizen-kit-21/tree/wdt. This presented an issue regarding time consistency, apparently affecting the RTC. Since then it has been stale due to the large workload, but it would be good to retake it as it can help in maintaining stability at a lower SAMD core level.

oscgonfer, 2024-04-14:
https://arduino-esp8266.readthedocs.io/en/latest/libraries.html#ticker

oscgonfer, 2024-04-14:
https://github.com/gpb01/wdt_samd21

Thread 52 (2023-07-27):

New Sensor Structure

oscgonfer, 2023-07-27:
A different way of handling the sensor implementations was started to make things easier and try to homogenize the whole structure. Ideally benefits of this new approach (in branch... ?) are:

1. Sensor objects are created in runtime, not consuming flash memory in principle
2. Indifferent if the sensor is on the Urban Board I2C bus or on the Aux Port I2C bus
3. Cleaner and more homogeneous implementation

As a first step, this new implementation would keep the same sensor ids as usual, and test the new data model, https://github.com/fablabbcn/smartcitizen-api/issues/241 with the current implementation or this new structure.

Further down the line, the idea is to send sensor ids with a "hash" composed of different variables to be documented, such as the current sensor id, and the bus in which the sensor is located. This would allow a `mux` to have duplicated sensors and each of them be uniquely identifiable.

Thread 53 (2023-07-27):

Hardware Index

oscgonfer, 2023-07-27:
# Power

- [ ] https://github.com/fablabbcn/smartcitizen-kit-21/issues/8

Closed 2024-11-25.

Thread 54 (2023-07-27):

ADS1115 Library doesn't support 4A address

oscgonfer, 2023-07-27:
The [Texas ADS1115 16 bit ADC](https://www.ti.com/product/ADS1115) is currently used in the [SC ASB](https://github.com/fablabbcn/smartcitizen-analog-sensor-board/tree/master/8-channel). The ADC has 4 different addresses, depending on how we connect the `ADDR` pin:

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

After testing with different boards (see below) setting the 4A address by connecting ADDR to SDA, the data transmission is not effective and we only get nulls. This could be linked to the SDA/SCL timing listed above, but we are currently not sure about it. The hardware tested included our ASB, a [Seeed](https://www.seeedstudio.com/Grove-ADS1115-16-bit-ADC-p-4599.html) version and the [Adafruit](https://www.adafruit.com/product/1085) version) and we did so with [our forked implementation](https://github.com/fablabbcn/smartcitizen-kit-21/blob/master/sam/platformio.ini#L82), which comes from [Adafruits](https://github.com/fablabbcn/Adafruit_ADS1X15) but is quite a few commits behind.

Currently, it is uncertain that the issue comes from the SDA/SCL or not, and we should assess if we want to merge adafruit's main into our fork.

Thread 57 (2024-02-12):

Control commands are wrong

oscgonfer, 2024-02-12:
In `dev` branch, `control <sensor> com r` returns `Battery`:

```
SCK > control cond com k,10
Atlas Conductivity: com k,10

SCK > control cond com k,?
Atlas Conductivity: com k,?
?K,10
SCK > control cond com r
Battery: com r
SCK > control conductivity com r
Battery: com r
SCK > control cond com r
Battery: com r
SCK > control cond com k,10
Atlas Conductivity: com k,10

SCK > control cond com r
Battery: com r
SCK > control ph com r
Battery: com r
```

oscgonfer, 2024-11-20:
Duplicate of https://github.com/fablabbcn/smartcitizen-kit-2x/issues/60

Closed 2024-11-20.

Thread 59 (2024-05-07):

JSON parsing error on info messages

oscgonfer, 2024-05-07:
Seems that there is some JSON parsing errors on some info messages.  For instance, it shows at the API level as:

```
Invalid Unicode [04 22 2c 22 68] at 31
```

The message seems _OK_ at the firmware level, also when subscribing directly to the mqtt topic (but it could be the terminal emulator interpretation of those characters). In any case,
```
message: {"time":"2024-05-07T14:54:20Z � ","hw_ver":"2.1","id":"3E661D225055344E312E3120FF0F2B08","sam_ver":"0.9.8-7b45baa","sam_bd":"2023-04-17T13:54:59Z","mac":"EE:FA:BC:DC:61:F7","esp_ver":"0.9.8-7b45baa","esp_bd":"2023-04-17T13:55:15Z"},
topic: device/sck/ltybyn/info
}
```

This seems to be an issue with _older_ firmware version (before the SCKSerial refurbish). But just keeping a note here for future reference: `7b45baa`

Thread 60 (2024-05-16):

Calibraton of water sensors

adaisuri, 2024-05-16:
Atlas water sensors may have some issues when calibrating.

In the [docs](https://docs.smartcitizen.me/Guides/calibration/Water%20sensors/) the example command for reading atlas sensors i not working

**Example commands**

```
control [atlas sensor] com r
control [atlas sensor] com cal
control [atlas sensor] com cal,[value]
control [atlas sensor] com cal,clear
control [atlas sensor] com cal,?
```

The proper way to communicate with the sensors is having a comma and no spaces.

**Example commands**

```
control [atlas sensor] com,r
control [atlas sensor] com,cal
control [atlas sensor] com,cal,[value]
control [atlas sensor] com,cal,clear
control [atlas sensor] com,cal,?
```

Thread 63 (2024-06-04):

Autocalibration is `off` by default for SCD30 CO2 sensors

oscgonfer, 2024-06-04:
For a newly flashed device:

```
SCK > read co2
SCD30 CO2: 696 ppm
SCK > control co2
SCD30 CO2:
Wrong command!!
Options:
interval [2-1000 (seconds)]
autocal [on/off]
calfactor [400-2000 (ppm)]
caltemp [newTemp/off]
pressure
SCK > control co2 autocal
SCD30 CO2: autocal
Auto Self Calibration: off
```

By default, it should be:

```
SCD30 CO2: autocal
Auto Self Calibration: on
```

Thread 76 (2024-11-20):

Implement check of firmware version and flash format procedure

oscgonfer, 2024-11-20:
Newer versions of the firmware are weirdly interpreting previous flash storage data with the wrong IDs. This is creating new components in the platform. Currently, the rootcause is not understood and not logic, but upon testing on various devices it's a consistent issue.

As a precaution, we should implement a firmware check based on a flag on EEPROM for the current flash information firmware. This would mean that the kit would check its new configuration against it and it would potentially flash the memory in case of inconsistency.

oscgonfer, 2024-11-20:
UPDATE: the rootcause is now clear.

The way the flash memory management stores the sensor IDs is via a `static cast` of the SensorType enum here:

https://github.com/fablabbcn/smartcitizen-kit-2x/blob/cf73c8ea1831e253b2822cbd5466a4cd98ab7c85/lib/Sensors/Sensors.h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

This was never considered to change, but it did in two commits for SCK2.1:

https://github.com/fablabbcn/smartcitizen-kit-2x/commit/01b42f20c4409d5ce4f8f07bf7456ba0e637fa2c
https://github.com/fablabbcn/smartcitizen-kit-2x/commit/4f4713a422030d18f32d08336473c032a01c0fe5

With these changes, the ENUM casting also changes, and previous mappings done in the flash memory no longer match to those originally stored. Reverting this commit would provoke all devices currently deployed with newer firmware versions to suffer from the same problem once there is a firmware upgrade. Therefore, the only "clean" option is to perform a flash format in case there is no agreement in terms of firmware versions.

oscgonfer, 2024-11-20:
Check https://github.com/fablabbcn/smartcitizen-kit-2x/issues/50 if working on flash issues.

Thread 77 (2024-11-20):

Battery is being drained whe SCK is OFF on SCK2.2

oscgonfer, 2024-11-20:
Title is self-explanatory.

Potential rootcauses to analyze:
- PM sensor is not off
- Step-up is not off

oscgonfer, 2024-11-21:
I confirm that after 16h of testing, battery went down <1%

Closed 2024-11-25.

Thread 83 (2025-01-16):

When changing publication interval, PM sensor is not read the first time

oscgonfer, 2025-01-16:
```
SCK > config -pubint 3000
ESP finished booting
-- New config --

Mode: network
Publish interval (s): 3000
Reading interval (s): 60
Wifi credentials: XXX - YYY
Token: AAAAAA
Sanity reset (every 24 hours) is: on
SCK > Connecting to Wifi...

SCK >
SCK > Connected to wifi!!- RSSI: -62
Hello sent!
Hello OK!!
Info sent!
Info publish OK!!

-----------
2025-01-16T14:04:34Z
-----------

SCK >
SCK > reset
Bye!!
```

After the reset:

```
Asked new time sync to ESP...
RTC updated: 2025-01-16T14:04:48Z
Info sent!
Info publish OK!!

-----------
2025-01-16T14:04:49Z
Temperature: 21.80 C
Humidity: 37.21 %
Ext SHT35 Temperature: 22.56 C
Ext SHT35 Humidity: 36.80 %
Battery: 100 %
SD card: 1 Present
ESP finished booting
RSSI interval must be the same as publish interval!!
correcting it to 3000
WiFi RSSI: -61 dBm
Light: 265 lux
Noise dBA: 43.09 dBA
MPL Barometric pressure: 102.60 kPa
AS7331 UVA: 1.60 uW/cm2
AS7331 UVB: 0.10 uW/cm2
AS7331 UVC: 0.14 uW/cm2
Connecting to Wifi...
Connected to wifi!!- RSSI: -64
Hello sent!
Hello OK!!
Info sent!
Info publish OK!!

-----------
2025-01-16T14:04:55Z
Light: 253 lux
Noise dBA: 47.91 dBA
MPL Barometric pressure: 102.61 kPa
AS7331 UVA: 1.52 uW/cm2
AS7331 UVB: 0.10 uW/cm2
AS7331 UVC: 0.14 uW/cm2
-----------
```

Further down the line:

```
-----------
2025-01-16T14:07:55Z
Temperature: 22.58 C
Humidity: 35.99 %
Ext SHT35 Temperature: 22.56 C
Ext SHT35 Humidity: 36.87 %
Battery: 99 %
SD card: 1 Present
Light: 214 lux
Noise dBA: 47.66 dBA
MPL Barometric pressure: 102.64 kPa
AS7331 UVA: 1.75 uW/cm2
AS7331 UVB: 0.10 uW/cm2
AS7331 UVC: 0.14 uW/cm2
-----------
(2025-01-16T14:07:55Z) Readings saved to flash memory.
(2025-01-16T14:07:55Z) 12 readings saved to sdcard.
Connecting to Wifi...
ESP finished booting
Connecting to Wifi...
Connected to wifi!!- RSSI: -61
(2025-01-16T14:07:55Z) Sent readings to platform.
Network publish OK!! (12 readings)

-----------
2025-01-16T14:08:55Z
Temperature: 22.73 C
Humidity: 35.68 %
Ext SHT35 Temperature: 22.59 C
Ext SHT35 Humidity: 36.70 %
Battery: 99 %
SD card: 1 Present
Light: 186 lux
Noise dBA: 46.22 dBA
MPL Barometric pressure: 102.62 kPa
SEN5X PM 1.0: 5.80 ug/m3
SEN5X PM 2.5: 6.10 ug/m3
SEN5X PM 4.0: 6.10 ug/m3
SEN5X PM 10.0: 6.10 ug/m3
SEN5X PN 0.5: 3890.00 #/0.1l
SEN5X PN 1.0: 4520.00 #/0.1l
SEN5X PN 2.5: 4540.00 #/0.1l
SEN5X PN 4.0: 4540.00 #/0.1l
SEN5X PN 10.0: 4540.00 #/0.1l
SEN5X Typical Particle Size: 46.00 um
AS7331 UVA: 1.60 uW/cm2
AS7331 UVB: 0.10 uW/cm2
AS7331 UVC: 0.10 uW/cm2
-----------
(2025-01-16T14:08:55Z) Readings saved to flash memory.
(2025-01-16T14:08:55Z) 22 readings saved to sdcard.
Connecting to Wifi...
ESP finished booting
Connecting to Wifi...
Connected to wifi!!- RSSI: -60
(2025-01-16T14:08:55Z) Sent readings to platform.
Network publish OK!! (22 readings)
```

Thread 84 (2025-01-28):

Could the ESP8266 be left with an open AP even after a reboot?

oscgonfer, 2025-01-28:
It seems that even if the ESP is reset after establishing a connection to a local network, the ESP8266 leaves the AP open. This has been verified with a network scan, showing open AI_THINKER modules.

Related https://arduino.stackexchange.com/questions/54372/how-to-turn-off-or-stop-access-point-network-in-esp8266

pylonsoft, 2025-10-03:
How do you know that these networks are related to the SmartCitizen devices? I'm surprised by the name of these APs as AI Thinker is a hardware manufacturer but none used in current SmartCitizen hardware.  Are the strings after the _AI-THINKER_ part substrings of your SmartCitizen devices MAC addresses? Is it possible that other hardware (from AI Thinker) is opening those APs? Which SmartCitizen device generation(s) do you use?

oscgonfer, 2025-10-06:
Hi @pylonsoft,

The ESP8266 is manufactured by AI Thinker: https://en.ai-thinker.com/pro_view-59.html

The MAC address last 4 digits are shown after the `AI-THINKER`. @tonyrosset 's SCKs are 2.2s, which have the same Data Board (and ESP WiFi antennas) as the 2.3.

I think the issue is somewhere outside of our control. These SSIDs don't seem to appear anywhere though, I assume it'd be somewhere on the arduino core for the esp8266, but after some time looking I couldn't find anything...

Thread 86 (2025-07-21):

ADS1115

oscgonfer, 2025-07-21:
Values close to GND overflow. See: https://github.com/adafruit/Adafruit_ADS1X15/issues/97

oscgonfer, 2025-09-22:
This will not be solved at the adafruit library level:

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

https://github.com/adafruit/Adafruit_ADS1X15/issues/97#issuecomment-3286316504

Still to investigate if we can do something ourselves.

Thread 87 (2025-08-07):

SEN55 Buffer and working mode

oscgonfer, 2025-08-07:
There is a problem in how the VOCState buffer is allocated, as it accounts for the CRC size, but it doesn't consider the right indexes for retrieving. This is being worked on https://github.com/fablabbcn/smartcitizen-kit-2x/pull/88

In addition, there needs to be a way for the sensor to still work on idle - measurement -idle mode and still retrieve VOC index data. As per the [datasheet](https://sensirion.com/media/documents/6791EFA0/62A1F68F/Sensirion_Datasheet_Environmental_Node_SEN5x.pdf):

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

Currently, we overheat the device if enabling these metrics

oscgonfer, 2025-08-07:
Being tested at:

https://api.smartcitizen.me/ui/experiments/29

oscgonfer, 2025-08-08:
https://github.com/Sensirion/arduino-i2c-sen5x/issues/16

Closed 2025-09-22.
