fablabbcn/smartcitizen-kit-2x/hardware/SCK2.2/SCK2.2_SILKSCREEN.pdf

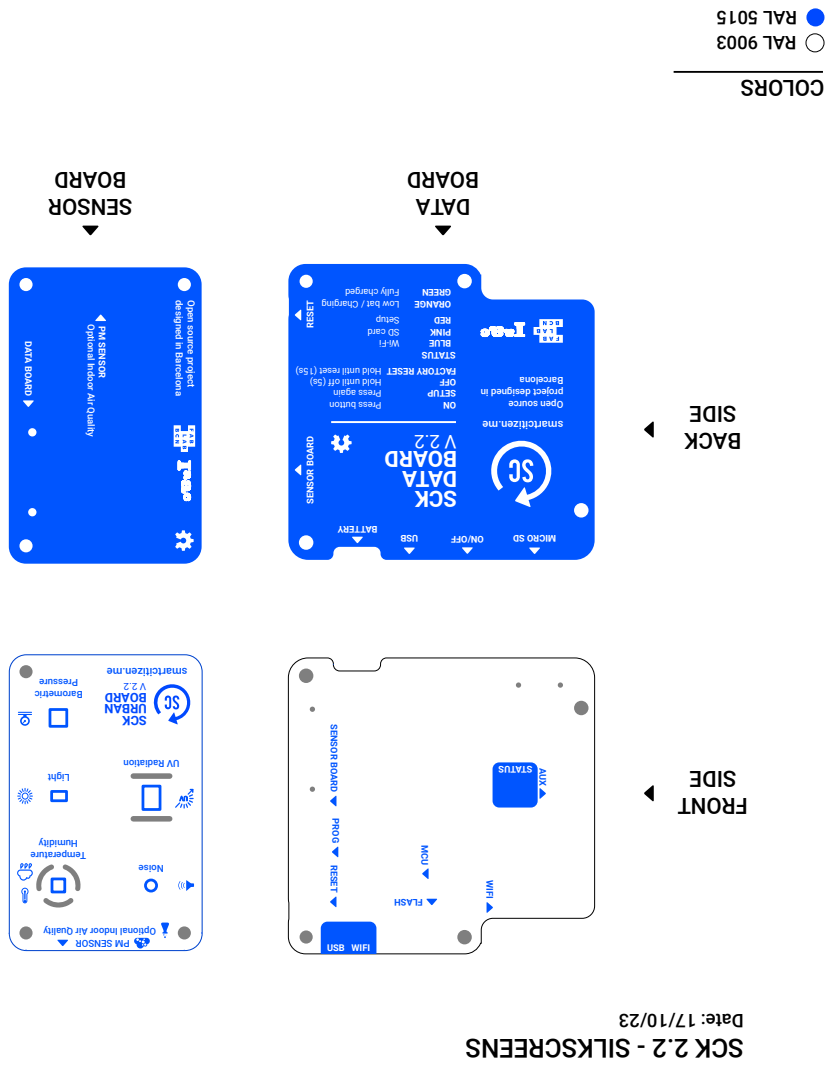
[picture p20: page 1]
FLASH; SCK 2.2 - SILKSCREENS; Date: 17/10/23; DATA; BOARD; FRONT; SIDE; BACK; SENSOR; COLORS; RAL 9003; RAL 5015; BATTERY; smartcitizen.me; Open source; Barcelona; USB WIFI; AUX; WIFI; MCU; DATA BOARD; SETUP; OFF; FACTORY RESET; STATUS; RESET; PM SENSOR; Press button; Press again; BLUE; PINK; RED; ORANGE; GREEN; SD card; Setup; Fully charged; Temperature; Humidity; Light; Barometric; Pressure; Noise; UV Radiation; SCK; URBAN

designed in Barcelona

Open source project

SENSOR BOARD RESET

Low bat / Charging

Optional Indoor Air Quality

Hold until reset (15s)

Hold until off (5s)

project designed in

USB ON/OFF MICRO SD

PROG SENSOR BOARD
