fablabbcn/smartcitizen-kit-2x/hardware/SCK2.1/SCK_2.1_SILKSCREEN.pdf

# SCK 2.1 - SILKSCREENS

# Date: 17/01/19

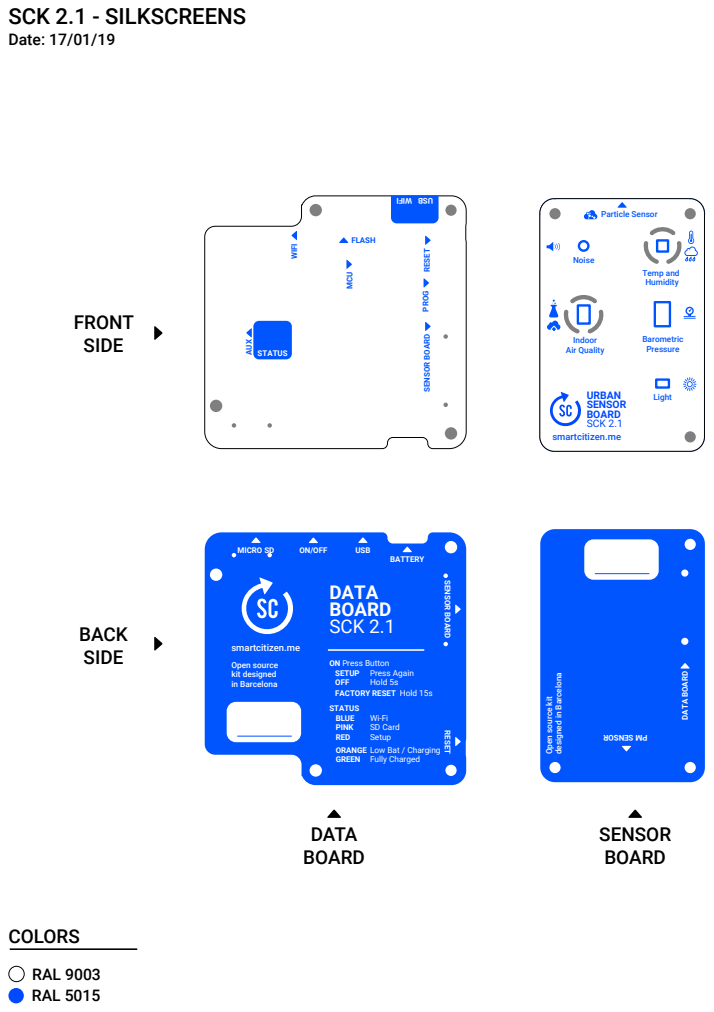
[picture p21: page 1]
FLASH; DATA BOARD; FRONT SIDE; BACK SIDE; SENSOR BOARD; COLORS; RAL 9003 RAL 5015; MICRO SD; ON/OFF; USB; BATTERY; smartcitizen.me; Open source kit designed in Barcelona; DATA BOARD SCK 2.1; AUX; WIFI; MCU; OFF; Hold 5s; BLUE; PINK; SD Card; RED; Setup; STATUS; RESET; Particle Sensor; Temp and Humidity; Light; Indoor Air Quality; Noise; Barometric Pressure; URBAN SENSOR BOARD SCK 2.1

PROG SENSOR BOARD

SENSOR BOARD RESET

ON Press Button
SETUP Press Again
FACTORY RESET Hold 15s
STATUS
ORANGE Low Bat / Charging
GREEN Fully Charged

designed in Barcelona

Open source kit
