fablabbcn/smartcitizen-kit-2x/hardware/SCK2.1/SCK_DATA_BOARD_2.1/SCK_DATA_BOARD_2.1.pdf

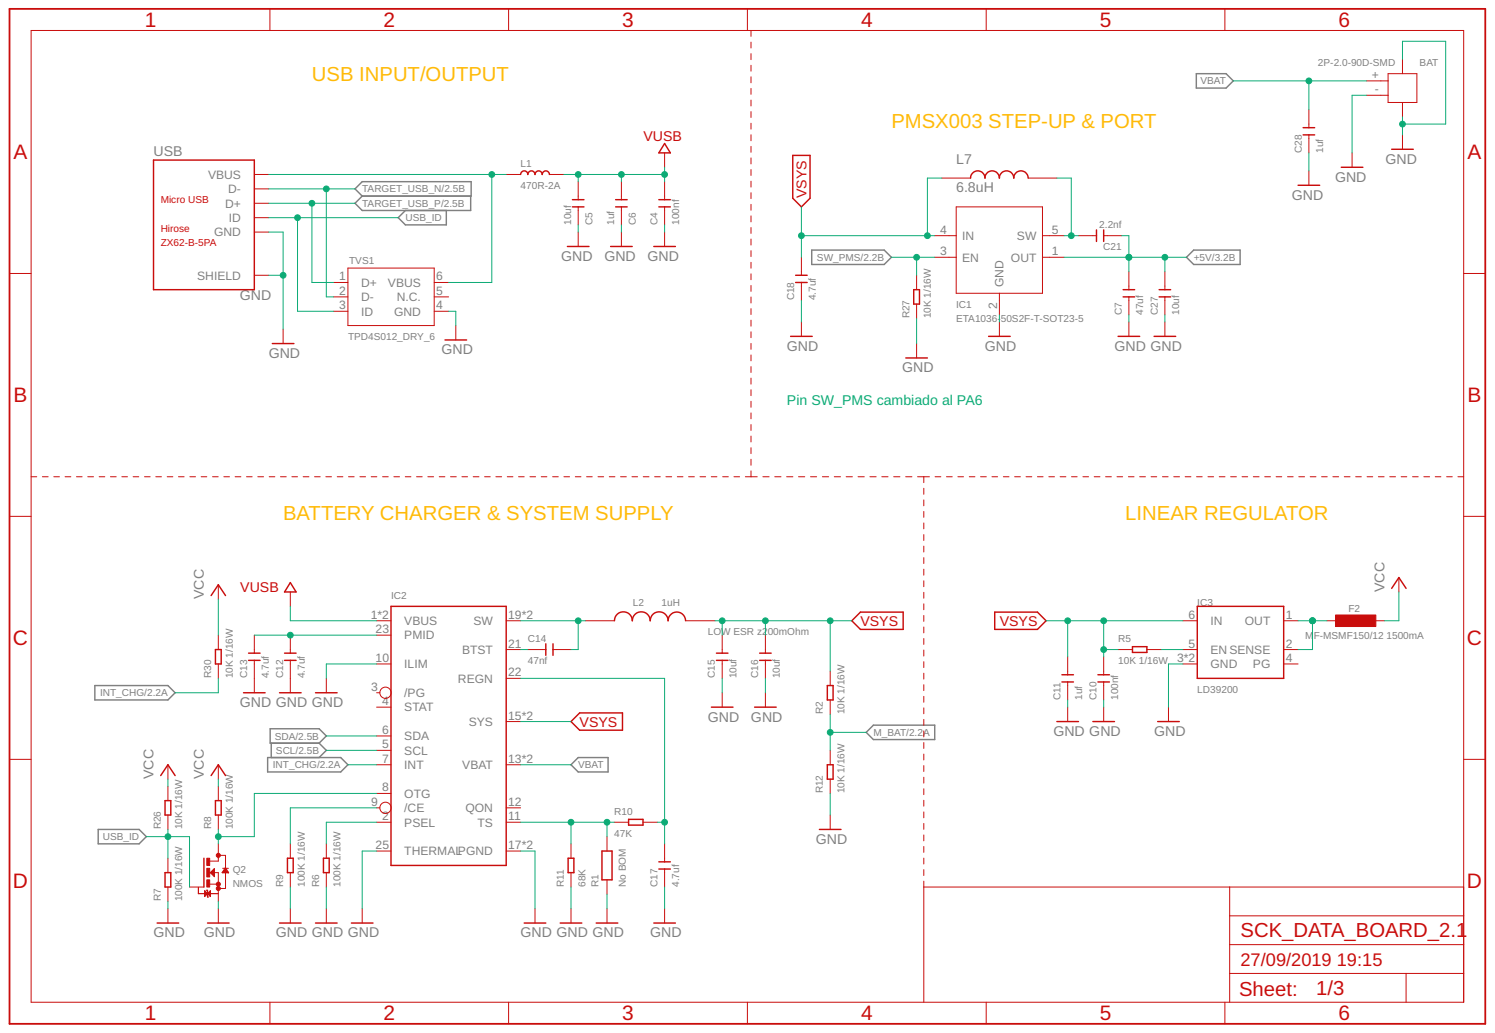
[picture p22: page 1]

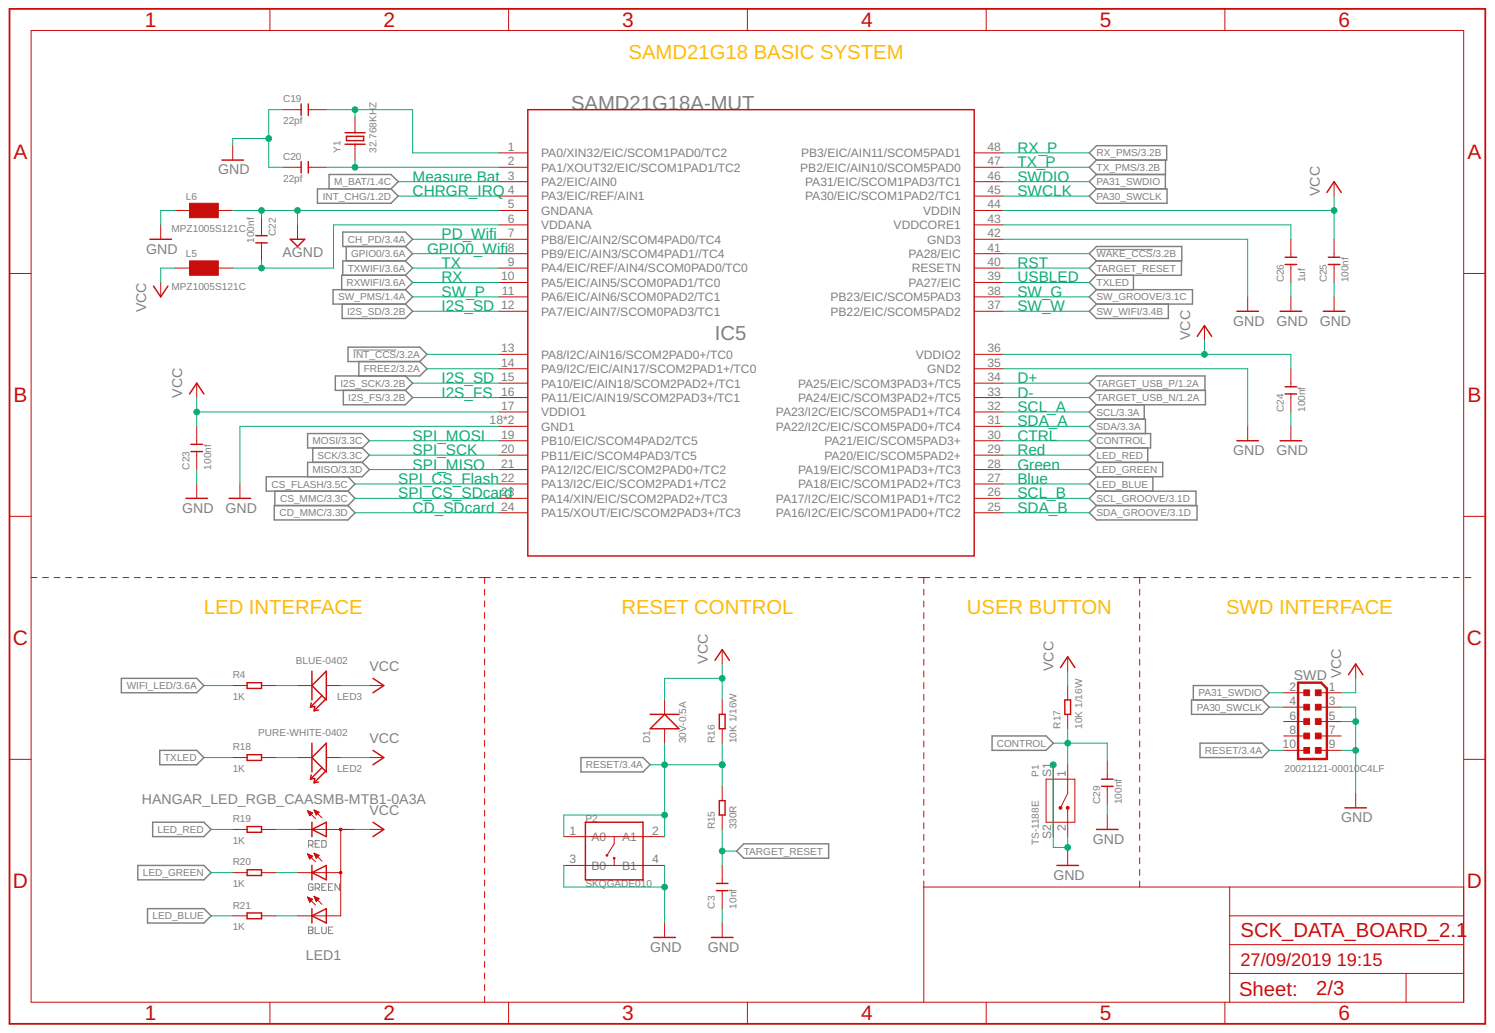
[picture p23: page 2]

39 PA28/EIC 38 RESETN 37 PB23/EIC/SCOM5PAD3

GND GND GND

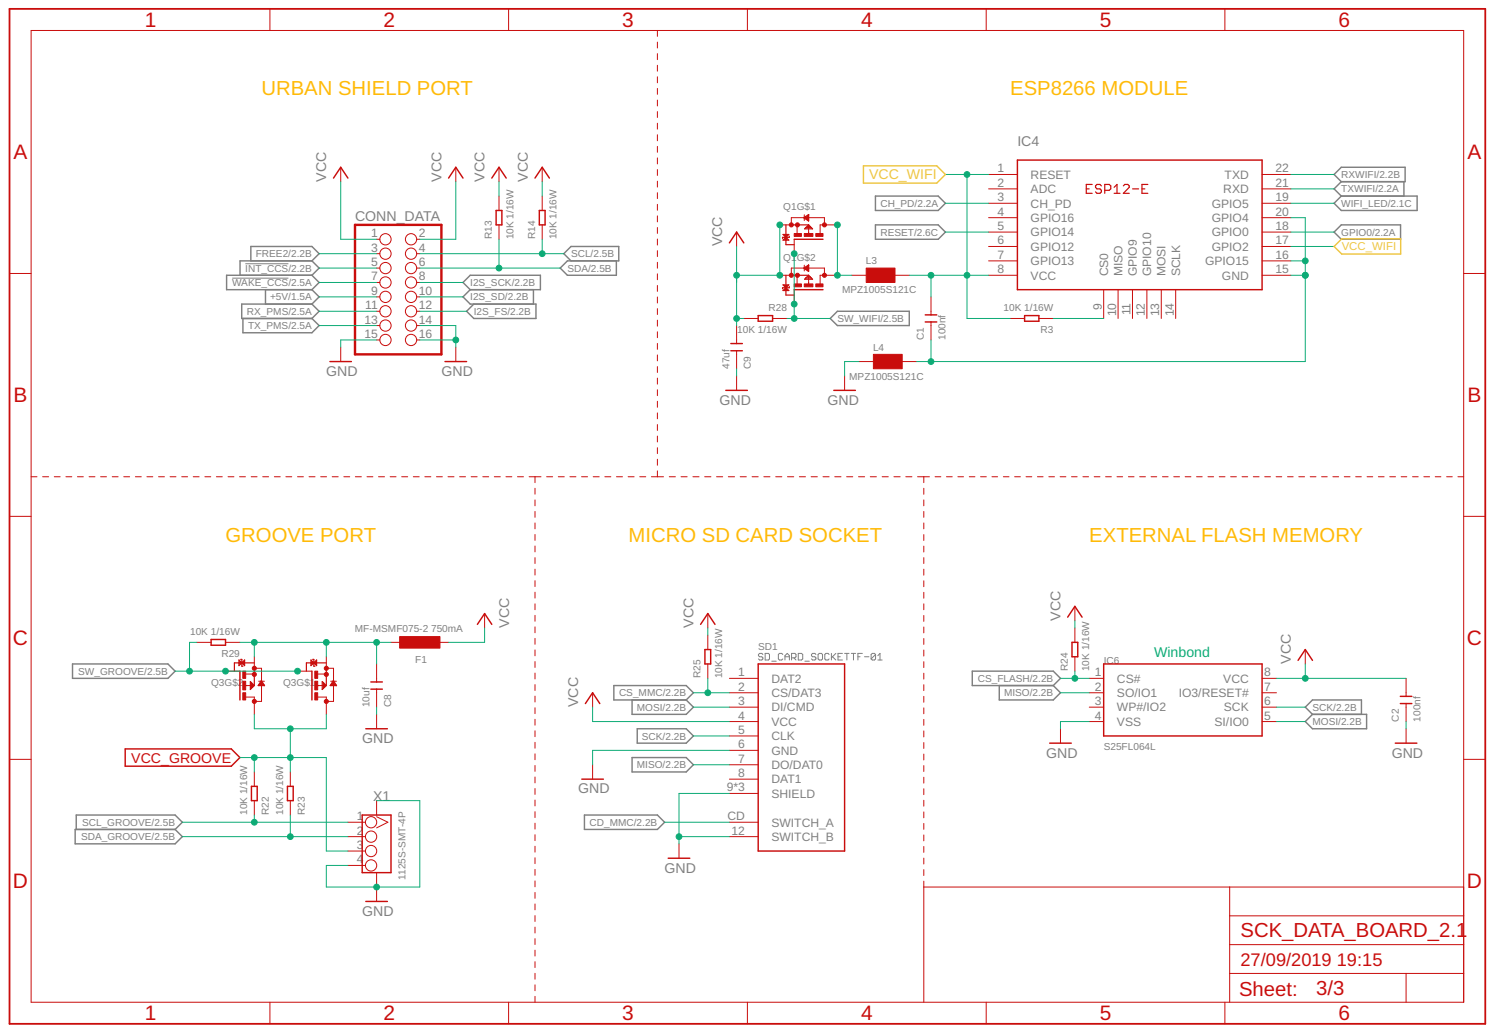
[picture p24: page 3]
