fablabbcn/smartcitizen-kit-2x/hardware/SCK2.2/SCK_DATA_BOARD_2.2/SCK_DATA_BOARD_2.2.pdf

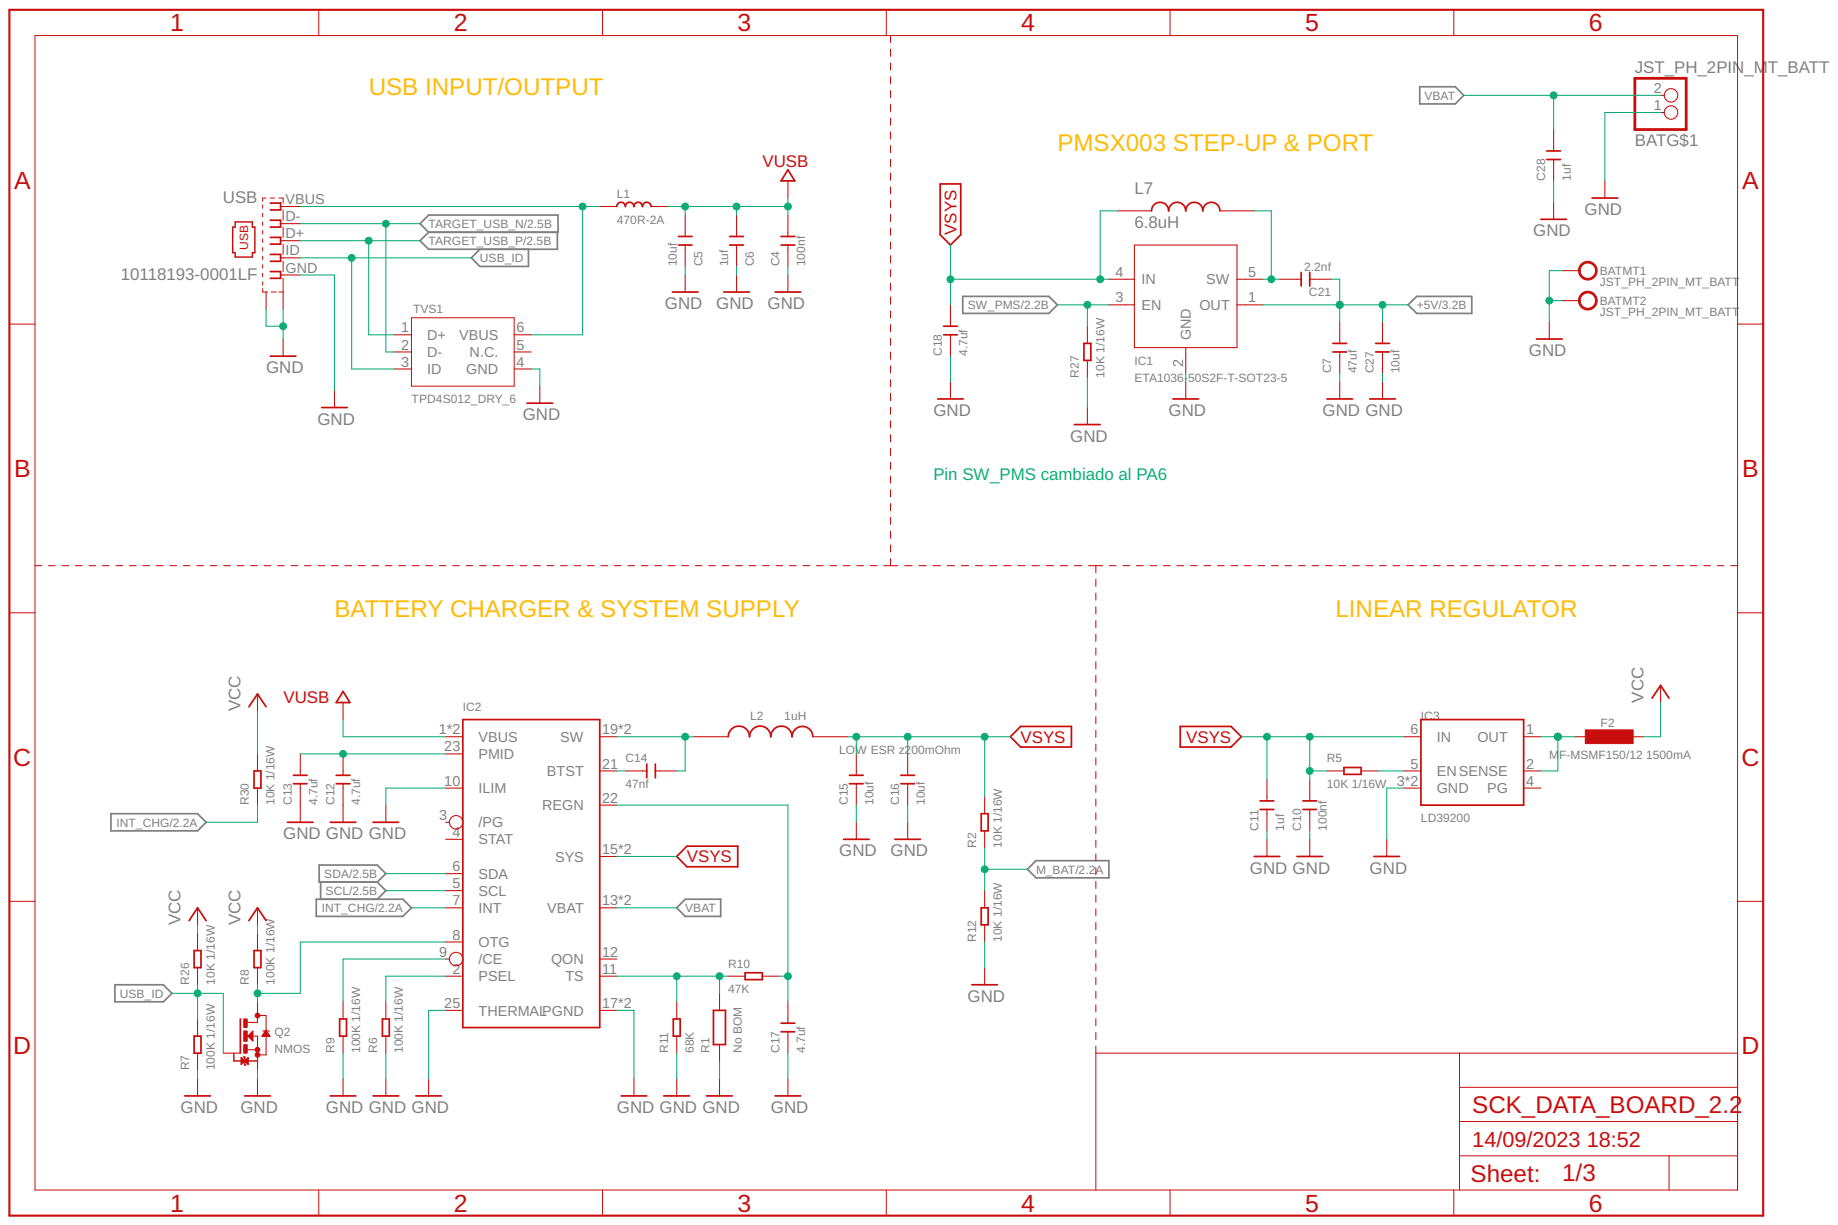
[picture p25: page 1]

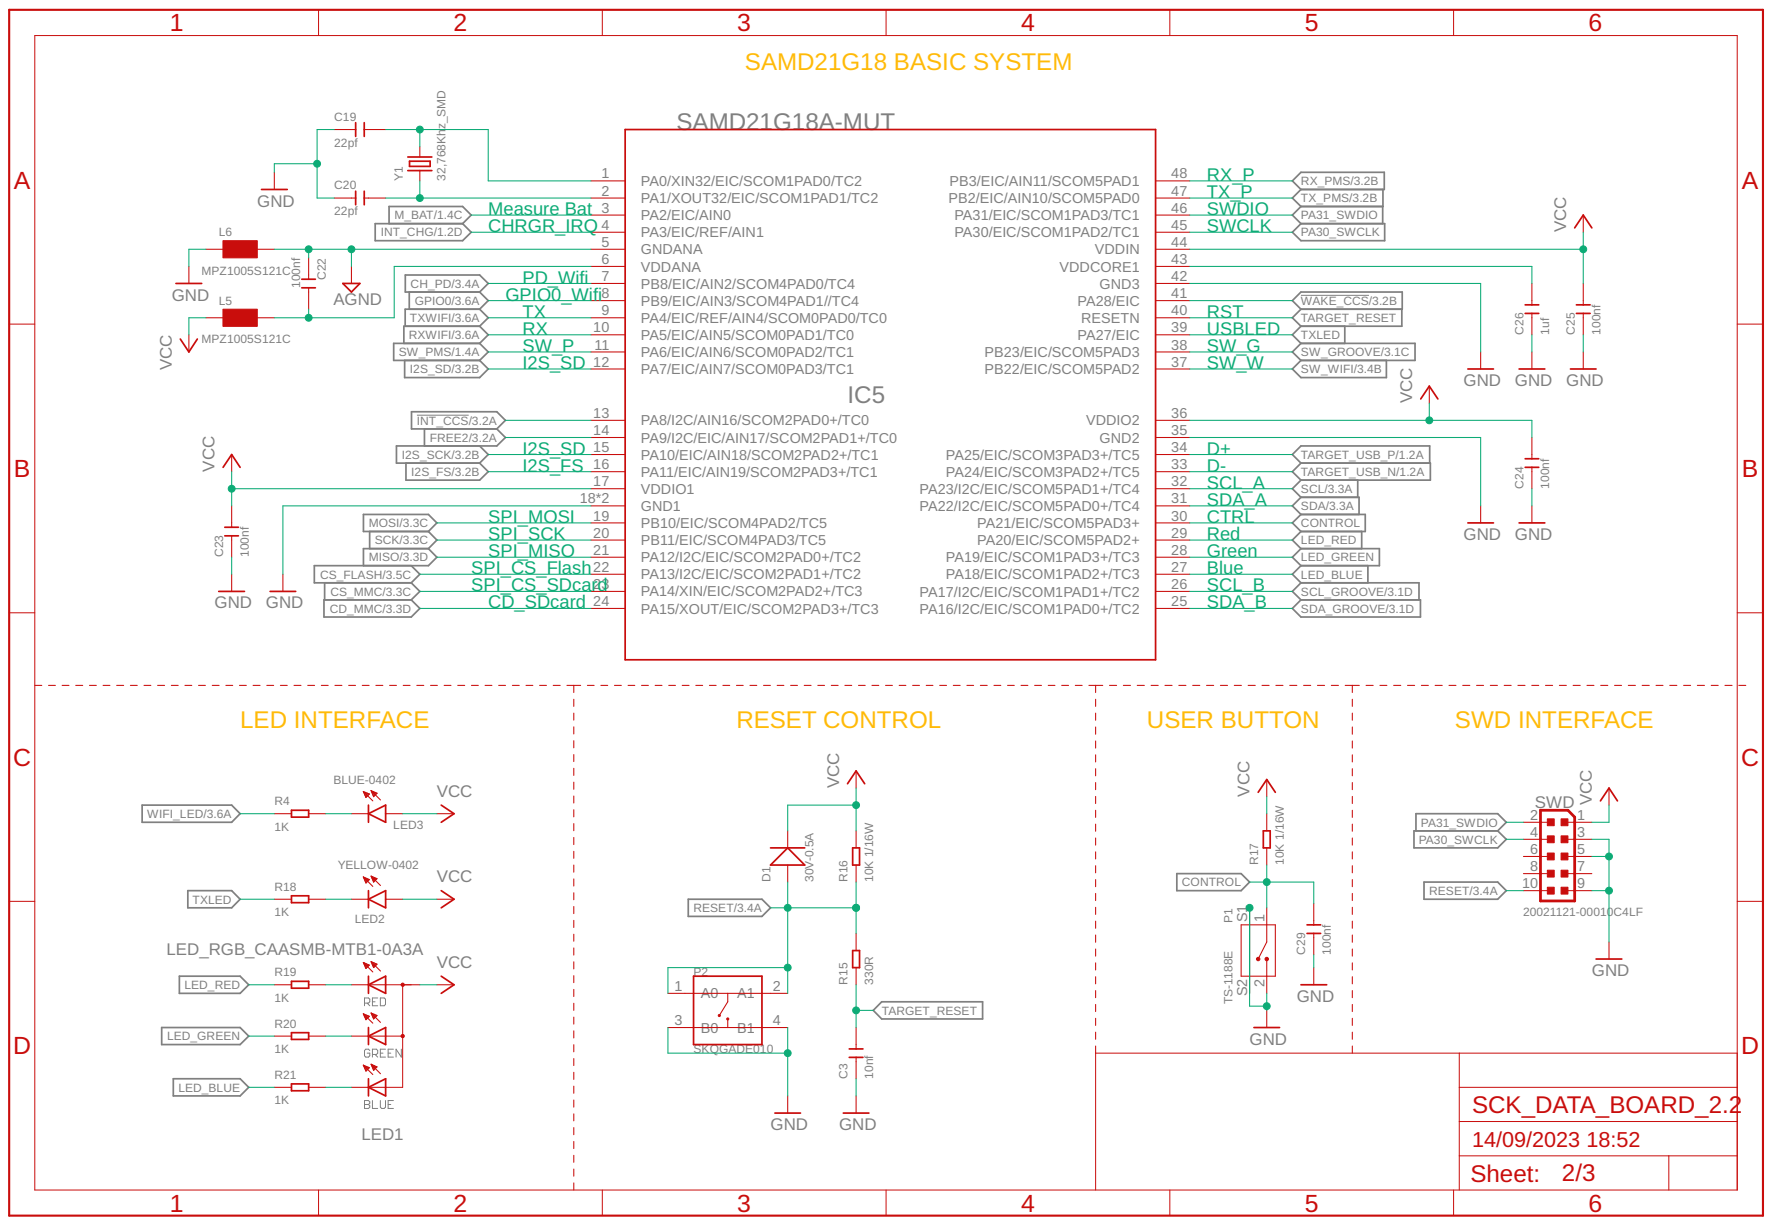
[picture p26: page 2]

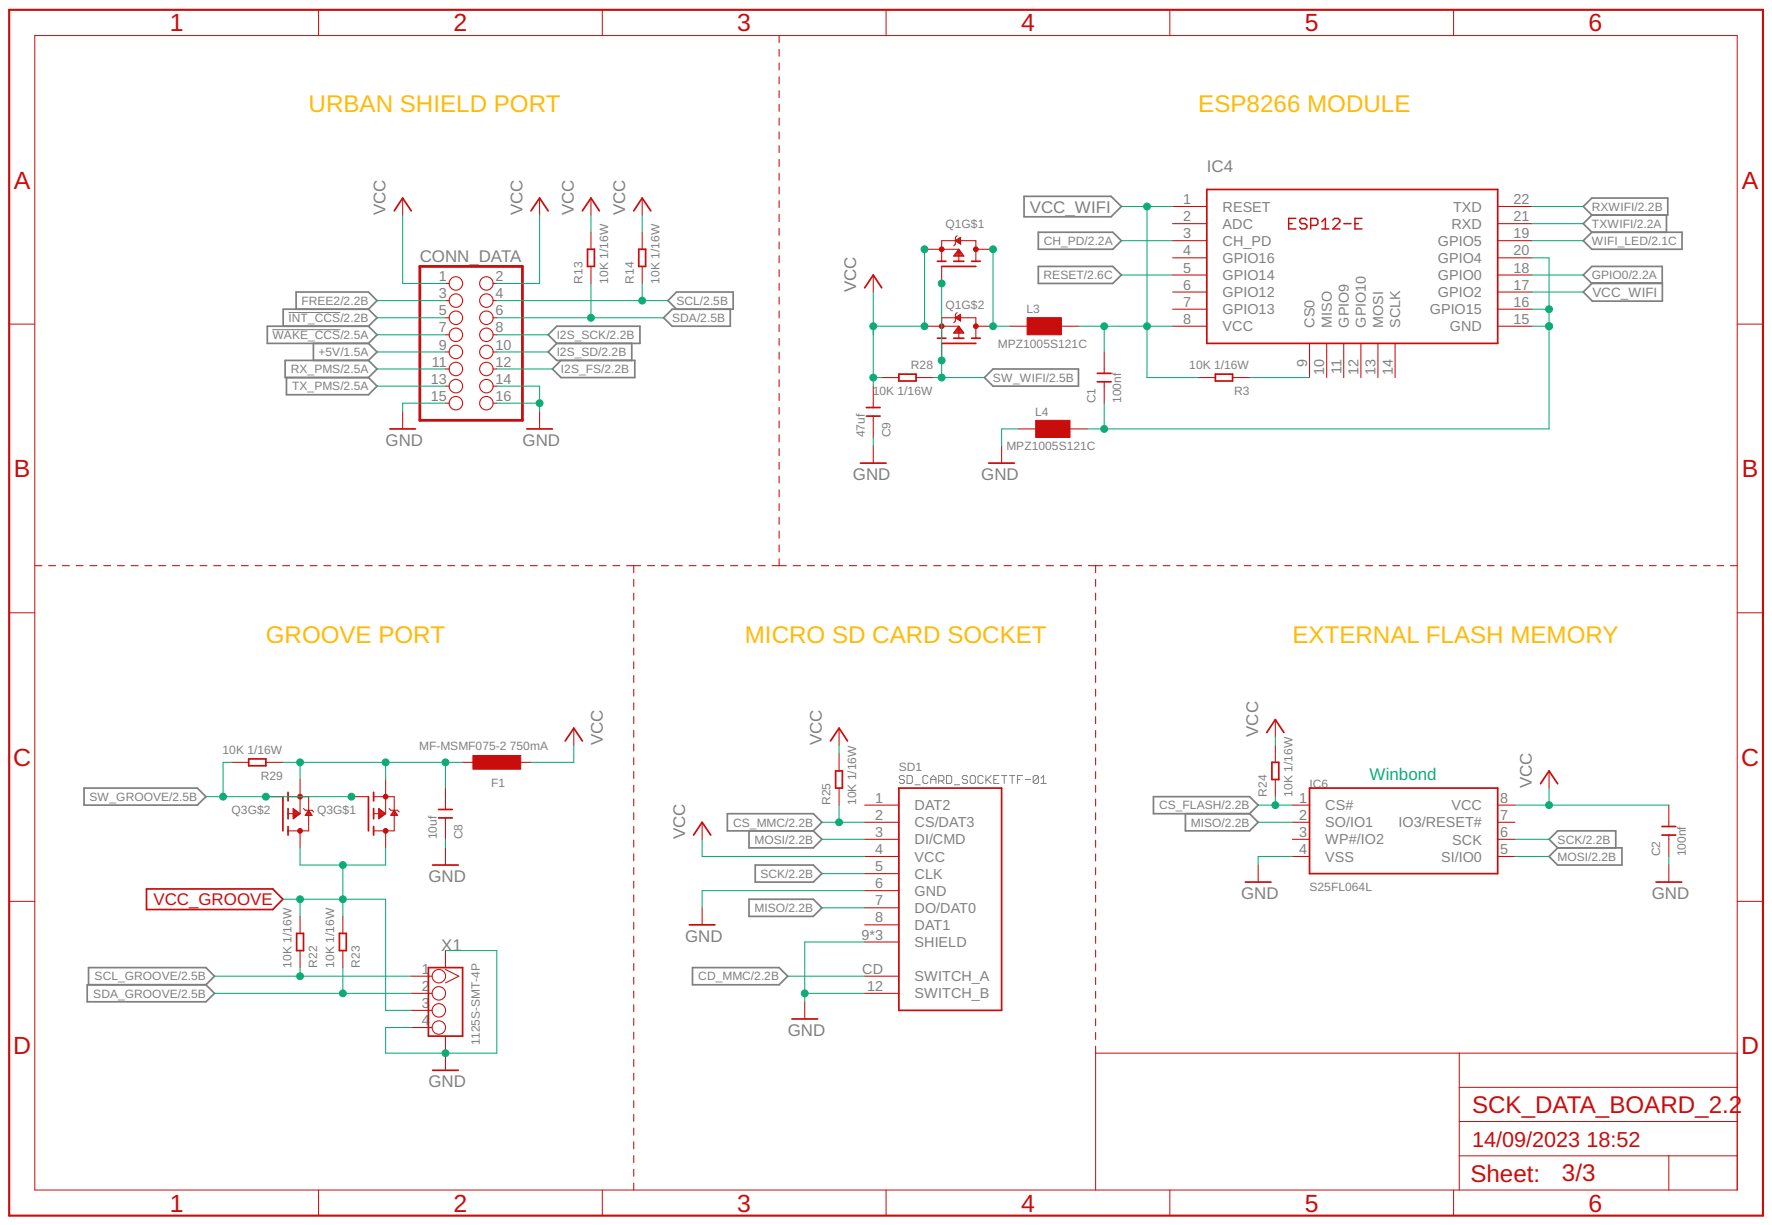
[picture p27: page 3]
