fablabbcn/smartcitizen-kit-2x/hardware/SCK2.2/SCK_URBAN_BOARD_2.2/SCK_URBAN_BOARD_2.2.pdf

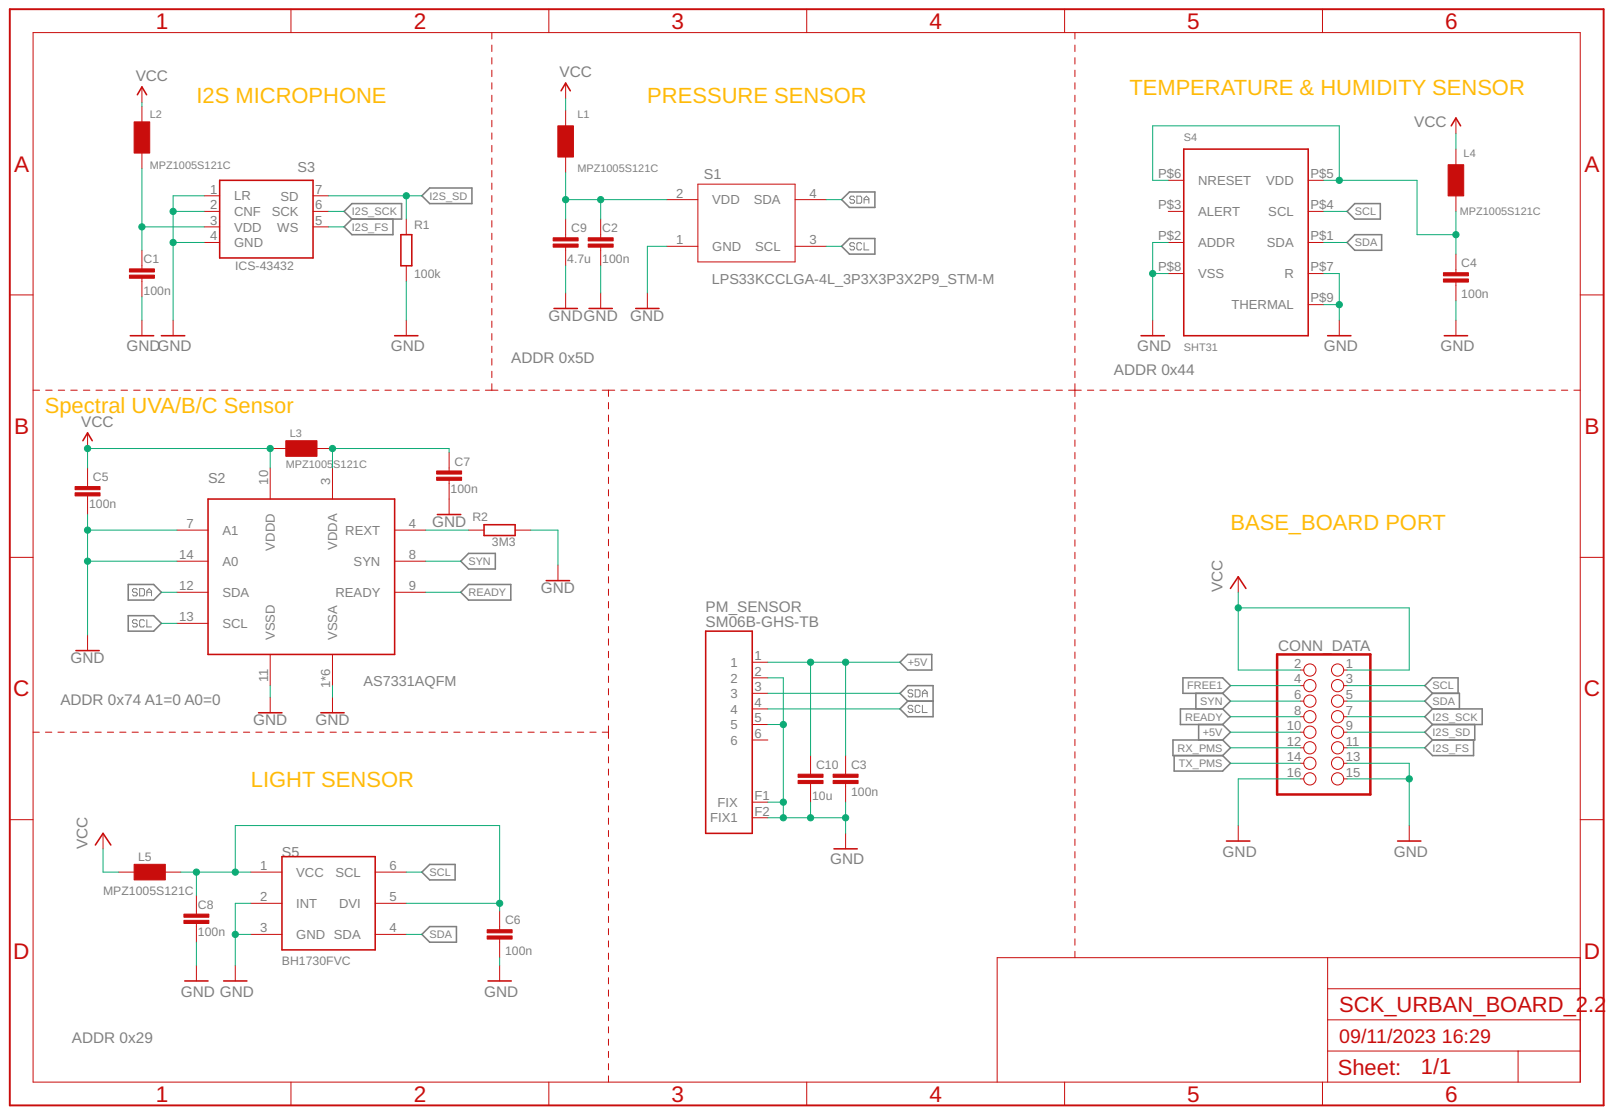
[picture p28: page 1]

VCC | VCC
