fablabbcn/smartcitizen-kit-2x/hardware/SCK2.1/SCK_URBAN_BOARD_2.1/SCK_URBAN_SHIELD_2.1.pdf

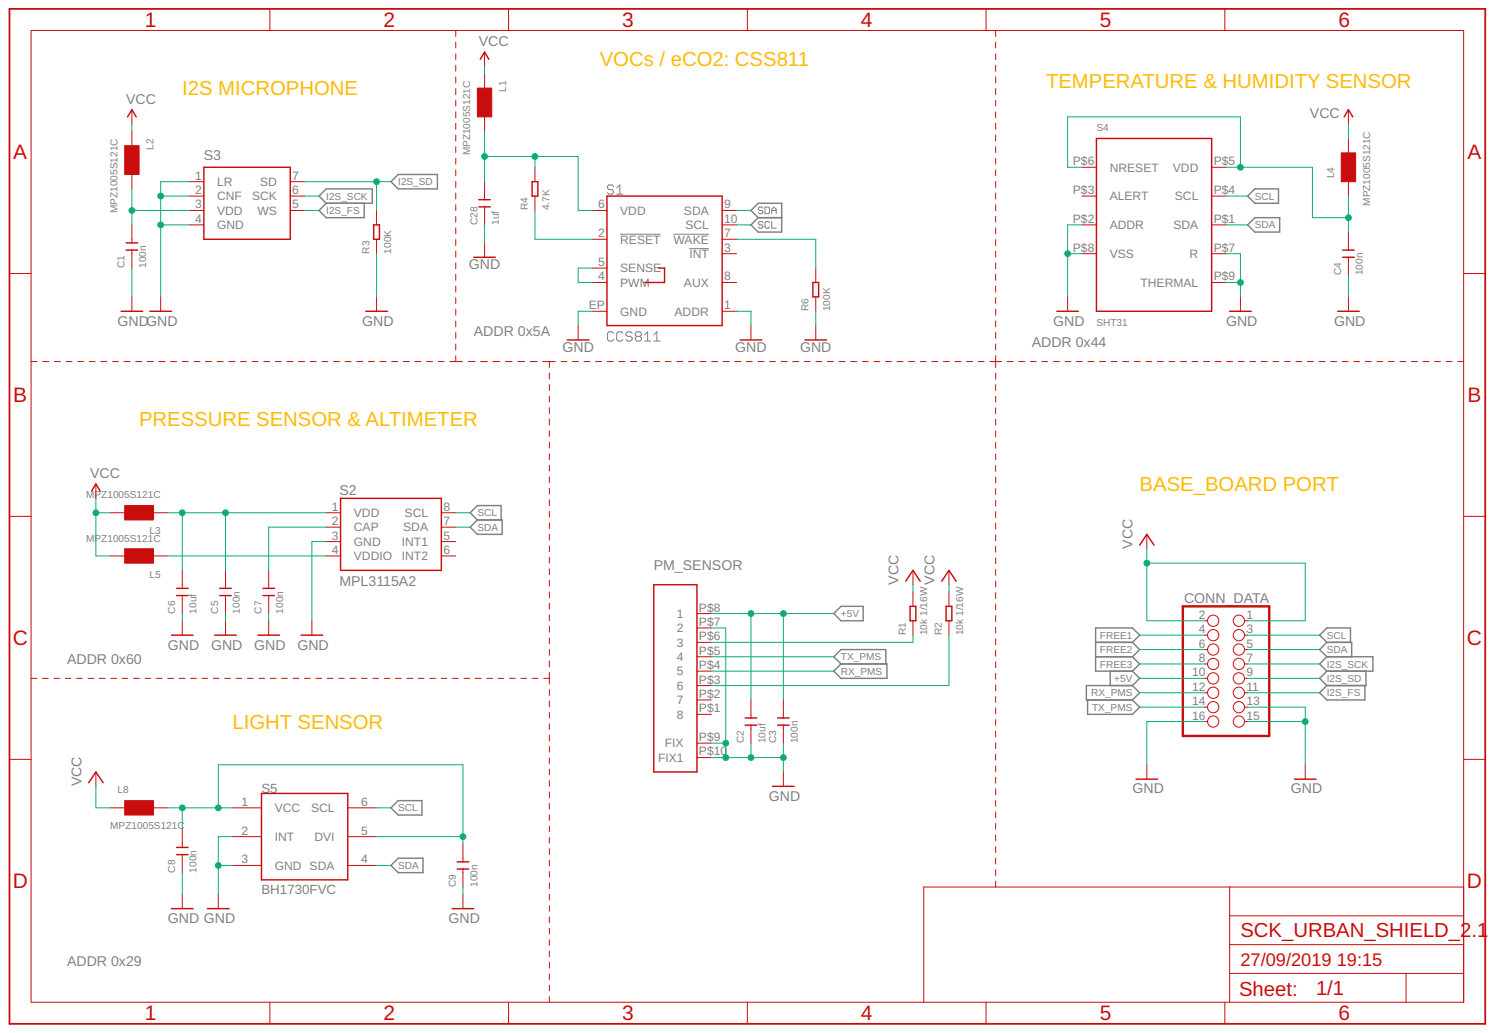
[picture p29: page 1]
