fablabbcn/smartcitizen-kit-2x/hardware/SCK2.3/SCK_DATA_BOARD_2.3/SCK_DATA_BOARD_2.3.brd

## EAGLE design hardware/SCK2.3/SCK_DATA_BOARD_2.3/SCK_DATA_BOARD_2.3.brd (2024-09-10)

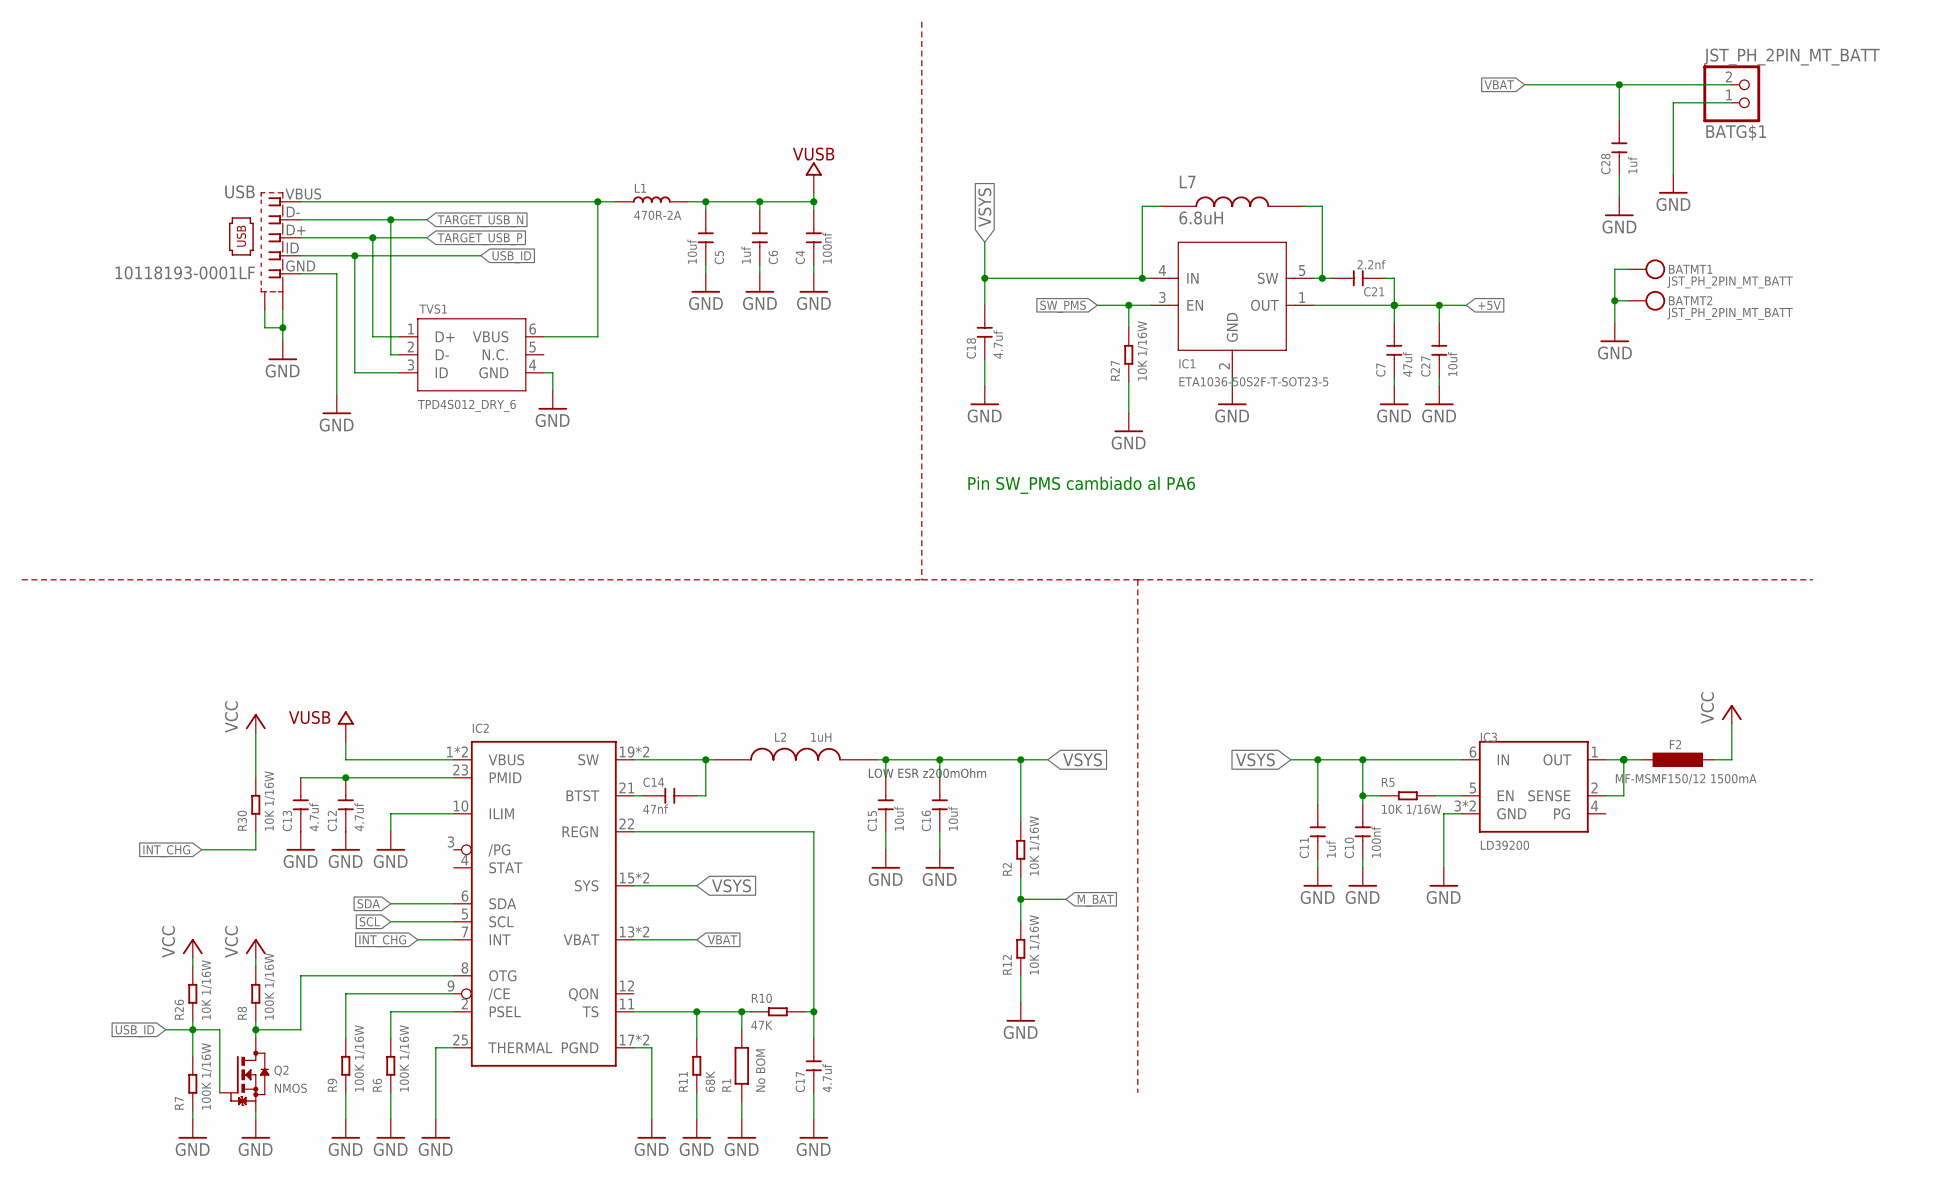
[picture p30: schematic SCK_DATA_BOARD_2.3.sch, sheet 1]

Parts:
BAT: JST_PH_2PIN_MT_BATT; JSTPH2_BATT
C4, C10: 100nf; C0402
C5: 10uf; C1206
C6, C11, C28: 1uf; C0805
C7: 47uf; C0805
C12, C13, C17, C18: 4.7uf; C0603
C14: 47nf; C0402
C15, C16, C27: 10uf; C0603
C21: 2.2nf; C0402
F2: MF-MSMF150/12 1500mA; L1812
IC1: ETA1036-50S2F-T-SOT23-5; SOT-23-5
IC2: BQ24259_VQFN(24); 24-PIN_VQFN_THPAD
IC3: LD39200; DFN6_3X3MM
L1: 470R-2A; L0805
L2: 1uH; HANGAR_C1210
L7: 6.8uH; IND_BOURNS_SRN3015TA_3X3_SMD
Q2: NMOS; NMOS_UMT3
R1: No BOM; HANGAR_R0402
R2, R5, R12, R26, R27, R30: 10K 1/16W; R0402
R6, R7, R8, R9: 100K 1/16W; R0402
R10: 47K; R0402
R11: 68K; R0402
TVS1: TPD4S012_DRY_6; DRY6
USB: 10118193-0001LF; CON2_USB_MICRO_B_AT

Connections:
+5V: C7.2, C21.1, C27.2, IC1.1 (OUT); also elsewhere on the board
BTST: C14.1, IC2.21 (BTST)
GND: BAT.1, BAT.NC1, BAT.NC2, C4.1, C5.1, C6.1, C7.1, C10.1, C11.1, C12.1, C13.1, C15.1, C16.1, C17.1, C18.1, C27.1, C28.1, IC1.2 (GND), IC2.10 (ILIM), IC2.17 (PGND), IC2.18 (PGND), IC2.25 (THERMAL), IC3.3 (GND), IC3.7 (GND), Q2.1 (S), R1.1, R6.1, R7.1, R9.1, R11.1, R12.1, R27.1, TVS1.4 (GND), USB.GND (5), USB.P$1 (S1), USB.P$2 (S1), USB.P$3 (S1), USB.P$4 (S1), USB.P$5 (S1), USB.P$6 (S1), USB.P$7 (S1), USB.P$8 (S1), USB.S1 (S2), USB.S2, USB.S3 (S2), USB.S4 (S2), USB.S5 (S2), USB.S6 (S2); also elsewhere on the board
INT_CHG: IC2.7 (INT), R30.1; also elsewhere on the board
M_BAT: R2.1, R12.2; also elsewhere on the board
unnamed: IC3.5 (EN), R5.2
unnamed: L1.1, TVS1.6 (VBUS), USB.VBUS (1)
unnamed: C21.2, IC1.5 (SW), L7.P$2
unnamed: C17.2, IC2.22 (REGN), R10.2
unnamed: C12.2, C13.2, IC2.23 (PMID)
unnamed: IC2.11 (TS), R1.2, R10.1, R11.2
unnamed: IC2.9 (/CE), R9.2
OTG: IC2.8 (OTG), Q2.3 (D), R8.1
PSEL: IC2.2 (PSEL), R6.2
SCL: IC2.5 (SCL); also elsewhere on the board
SDA: IC2.6 (SDA); also elsewhere on the board
SW: C14.2, IC2.19 (SW), IC2.20 (SW), L2.1
SW_PMS: IC1.3 (EN), R27.2; also elsewhere on the board
TARGET_USB_N: TVS1.2 (D-), USB.D- (2); also elsewhere on the board
TARGET_USB_P: TVS1.1 (D+), USB.D+ (3); also elsewhere on the board
USB_ID: Q2.2 (G), R7.2, R26.1, TVS1.3 (ID), USB.ID (4)
VBAT: BAT.2, C28.2, IC2.13 (VBAT), IC2.14 (VBAT)
VCC: F2.1, R8.2, R26.2, R30.2; also elsewhere on the board
VCC_SOURCE: F2.2, IC3.1 (OUT), IC3.2 (SENSE)
VSYS: C10.2, C11.2, C15.2, C16.2, C18.2, IC1.4 (IN), IC2.15 (SYS), IC2.16 (SYS), IC3.6 (IN), L2.2, L7.P$1, R2.2, R5.1
VUSB: C4.2, C5.2, C6.2, IC2.1 (VBUS), IC2.24 (VBUS), L1.2

Notes on the sheet:
LOW ESR z200mOhm
Pin SW_PMS cambiado al PA6

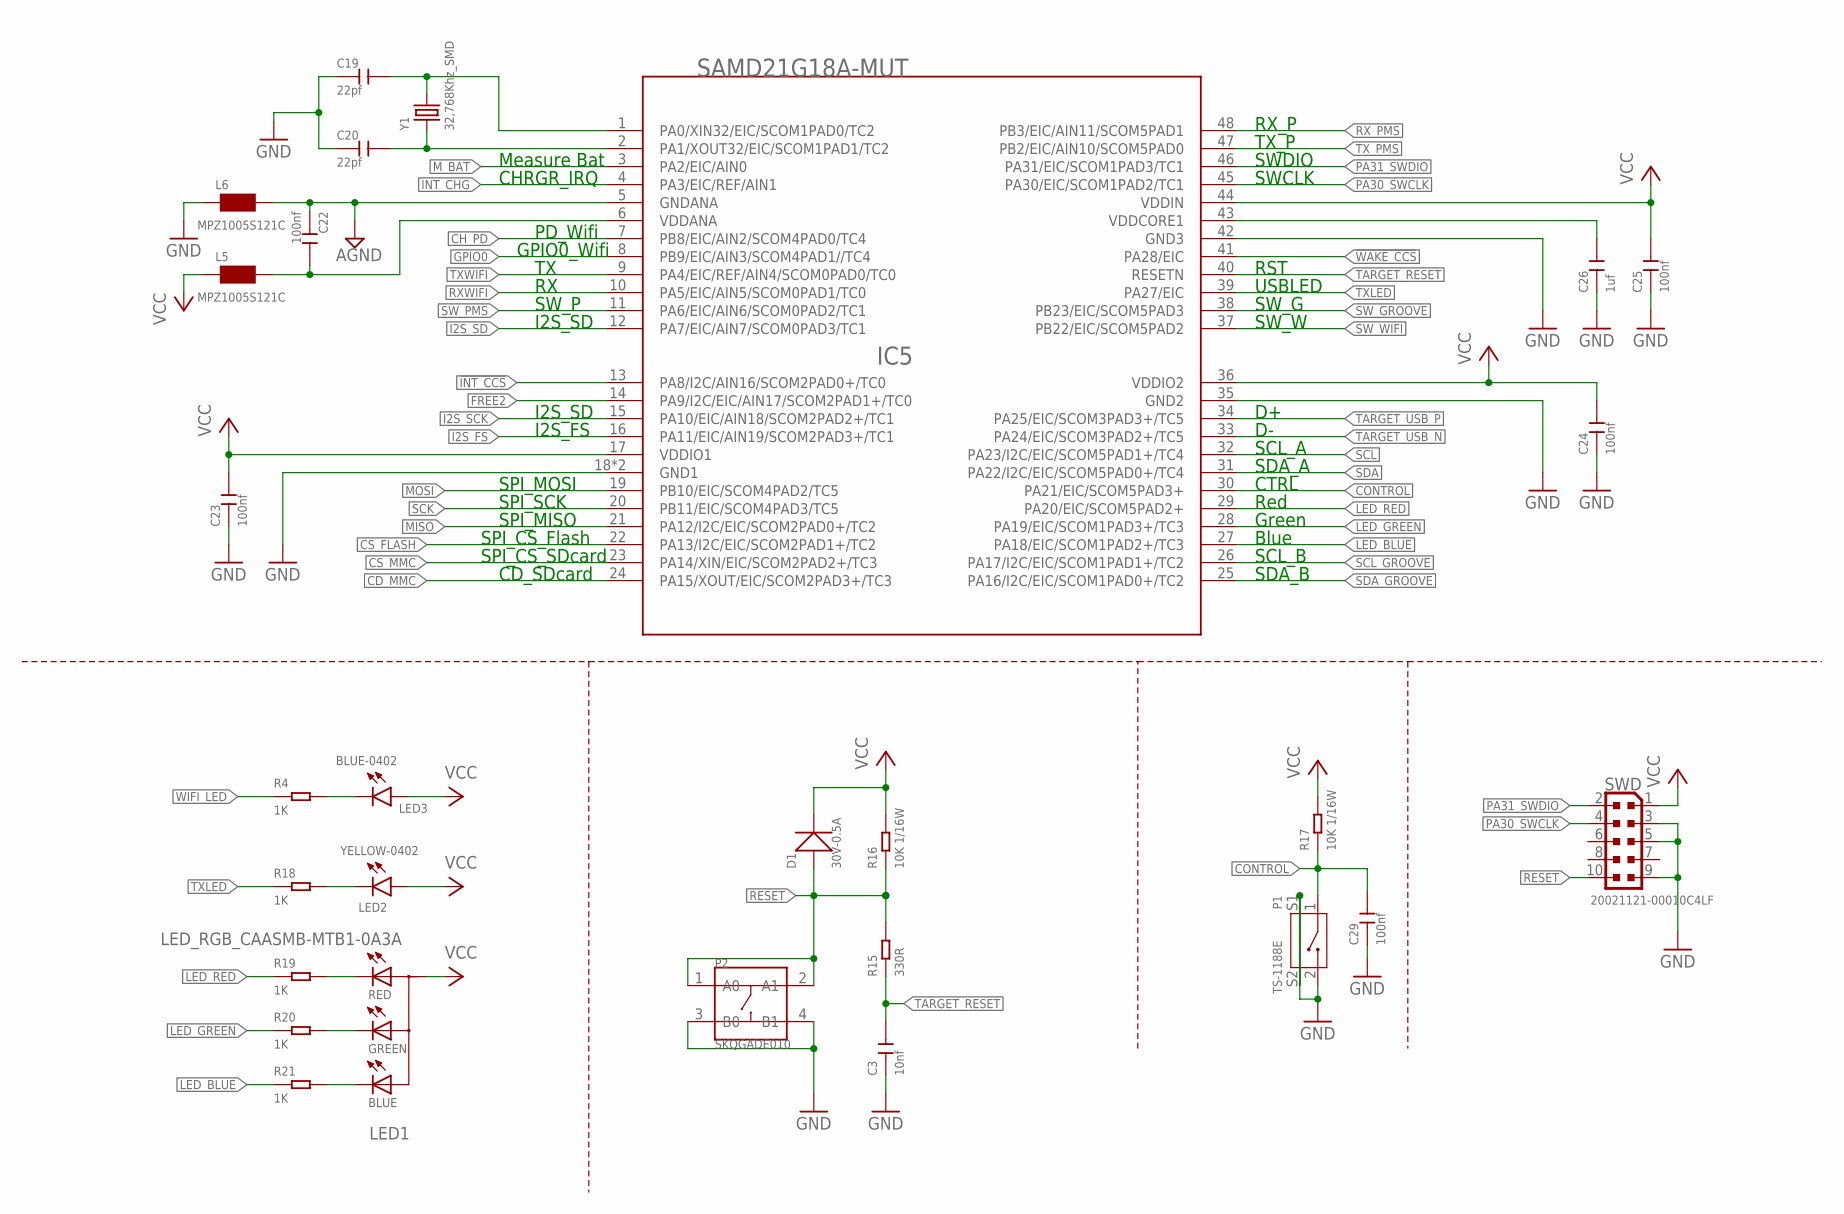
[picture p31: schematic SCK_DATA_BOARD_2.3.sch, sheet 2]

Parts:
C3: 10nf; C0402
C19, C20: 22pf; C0402
C22, C23, C24, C25, C29: 100nf; C0402
C26: 1uf; C0805
D1: 30V-0.5A; SOD-323
IC5: SAMD21G18A-MUT; QFN48-7X7
L5, L6: MPZ1005S121C; 0402
LED1: LED_RGB_CAASMB-MTB1-0A3A; HANGAR_P-LCC-4
LED2: YELLOW-0402; CHIPLED_0402_YELLOW
LED3: BLUE-0402; CHIPLED_0402_BLUE
P1: TS-1188E; SW4-SMD-7.0X3.5X3.5MM-90D
P2: SKQGADE010; SW4-SMD-5.2X5.2X1.5MM
R4, R18, R19, R20, R21: 1K; R0402
R15: 330R; R0402
R16, R17: 10K 1/16W; R0402
SWD: 20021121-00010C4LF; 2X05_SMD_1.27MM
Y1: 32,768Khz_SMD; CRISTALLI_RESONATOR_EPSON_FC_145

Connections:
!INT_CCS: IC5.13 (PA8/I2C/AIN16/SCOM2PAD0+/TC0); also elsewhere on the board
!WAKE_CCS: IC5.41 (PA28/EIC); also elsewhere on the board
AGND: C22.1, IC5.5 (GNDANA), L6.2
AVCC: C22.2, IC5.6 (VDDANA), L5.2
CD_MMC: IC5.24 (PA15/XOUT/EIC/SCOM2PAD3+/TC3); also elsewhere on the board
CH_PD: IC5.7 (PB8/EIC/AIN2/SCOM4PAD0/TC4); also elsewhere on the board
CONTROL: C29.2, IC5.30 (PA21/EIC/SCOM5PAD3+), P1.1, R17.1
CS_FLASH: IC5.22 (PA13/I2C/EIC/SCOM2PAD1+/TC2); also elsewhere on the board
CS_MMC: IC5.23 (PA14/XIN/EIC/SCOM2PAD2+/TC3); also elsewhere on the board
FREE2: IC5.14 (PA9/I2C/EIC/AIN17/SCOM2PAD1+/TC0); also elsewhere on the board
GND: C3.1, C19.1, C20.1, C23.1, C24.1, C25.1, C26.1, C29.1, IC5.18 (GND1), IC5.35 (GND2), IC5.42 (GND3), IC5.TP (GND1), L6.1, P1.2, P1.S1, P1.S2, P2.3 (B0), P2.4 (B1), SWD.3, SWD.5, SWD.9; also elsewhere on the board
GPIO0: IC5.8 (PB9/EIC/AIN3/SCOM4PAD1//TC4); also elsewhere on the board
I2S_FS: IC5.16 (PA11/EIC/AIN19/SCOM2PAD3+/TC1); also elsewhere on the board
I2S_SCK: IC5.15 (PA10/EIC/AIN18/SCOM2PAD2+/TC1); also elsewhere on the board
I2S_SD: IC5.12 (PA7/EIC/AIN7/SCOM0PAD3/TC1); also elsewhere on the board
INT_CHG: IC5.4 (PA3/EIC/REF/AIN1); also elsewhere on the board
LED_BLUE: IC5.27 (PA18/EIC/SCOM1PAD2+/TC3), R21.1
LED_GREEN: IC5.28 (PA19/EIC/SCOM1PAD3+/TC3), R20.1
LED_RED: IC5.29 (PA20/EIC/SCOM5PAD2+), R19.1
MISO: IC5.21 (PA12/I2C/EIC/SCOM2PAD0+/TC2); also elsewhere on the board
MOSI: IC5.19 (PB10/EIC/SCOM4PAD2/TC5); also elsewhere on the board
M_BAT: IC5.3 (PA2/EIC/AIN0); also elsewhere on the board
unnamed: LED2.K (C), R18.2
unnamed: LED1.2 (GREEN), R20.2
unnamed: LED3.K (C), R4.2
unnamed: LED1.1 (RED), R19.2
unnamed: LED1.3 (BLUE), R21.2
PA00_XIN32: C19.2, IC5.1 (PA0/XIN32/EIC/SCOM1PAD0/TC2), Y1.P$2 (2)
PA01_XOUT32: C20.2, IC5.2 (PA1/XOUT32/EIC/SCOM1PAD1/TC2), Y1.P$1 (1)
PA30_SWCLK: IC5.45 (PA30/EIC/SCOM1PAD2/TC1), SWD.4
PA31_SWDIO: IC5.46 (PA31/EIC/SCOM1PAD3/TC1), SWD.2
RESET: D1.+, P2.1 (A0), P2.2 (A1), R15.2, R16.1, SWD.10; also elsewhere on the board
RXWIFI: IC5.10 (PA5/EIC/AIN5/SCOM0PAD1/TC0); also elsewhere on the board
RX_PMS: IC5.48 (PB3/EIC/AIN11/SCOM5PAD1); also elsewhere on the board
SCK: IC5.20 (PB11/EIC/SCOM4PAD3/TC5); also elsewhere on the board
SCL: IC5.32 (PA23/I2C/EIC/SCOM5PAD1+/TC4); also elsewhere on the board
SCL_GROOVE: IC5.26 (PA17/I2C/EIC/SCOM1PAD1+/TC2); also elsewhere on the board
SDA: IC5.31 (PA22/I2C/EIC/SCOM5PAD0+/TC4); also elsewhere on the board
SDA_GROOVE: IC5.25 (PA16/I2C/EIC/SCOM1PAD0+/TC2); also elsewhere on the board
SW_GROOVE: IC5.38 (PB23/EIC/SCOM5PAD3); also elsewhere on the board
SW_PMS: IC5.11 (PA6/EIC/AIN6/SCOM0PAD2/TC1); also elsewhere on the board
SW_WIFI: IC5.37 (PB22/EIC/SCOM5PAD2); also elsewhere on the board
TARGET_RESET: C3.2, IC5.40 (RESETN), R15.1
TARGET_USB_N: IC5.33 (PA24/EIC/SCOM3PAD2+/TC5); also elsewhere on the board
TARGET_USB_P: IC5.34 (PA25/EIC/SCOM3PAD3+/TC5); also elsewhere on the board
TXLED: IC5.39 (PA27/EIC), R18.1
TXWIFI: IC5.9 (PA4/EIC/REF/AIN4/SCOM0PAD0/TC0); also elsewhere on the board
TX_PMS: IC5.47 (PB2/EIC/AIN10/SCOM5PAD0); also elsewhere on the board
VCC: C23.2, C24.2, C25.2, D1.-, IC5.17 (VDDIO1), IC5.36 (VDDIO2), IC5.44 (VDDIN), L5.1, LED1.4 (A), LED2.A, LED3.A, R16.2, R17.2, SWD.1; also elsewhere on the board
VDDCORE: C26.2, IC5.43 (VDDCORE1)
WIFI_LED: R4.1; also elsewhere on the board

Notes on the sheet:
Blue
Green
SCL_B
SDA_B
Red
CTRL
SW_G
SW_W
SDA_A
SCL_A
USBLED
RST
SWDIO
SWCLK
PD_Wifi
GPIO0_Wifi
I2S_SD
Measure Bat
CHRGR_IRQ
I2S_FS
SPI_MOSI
SPI_SCK
SPI_MISO
SPI_CS_Flash
SPI_CS_SDcard
CD_SDcard
SW_P
RX_P
TX_P

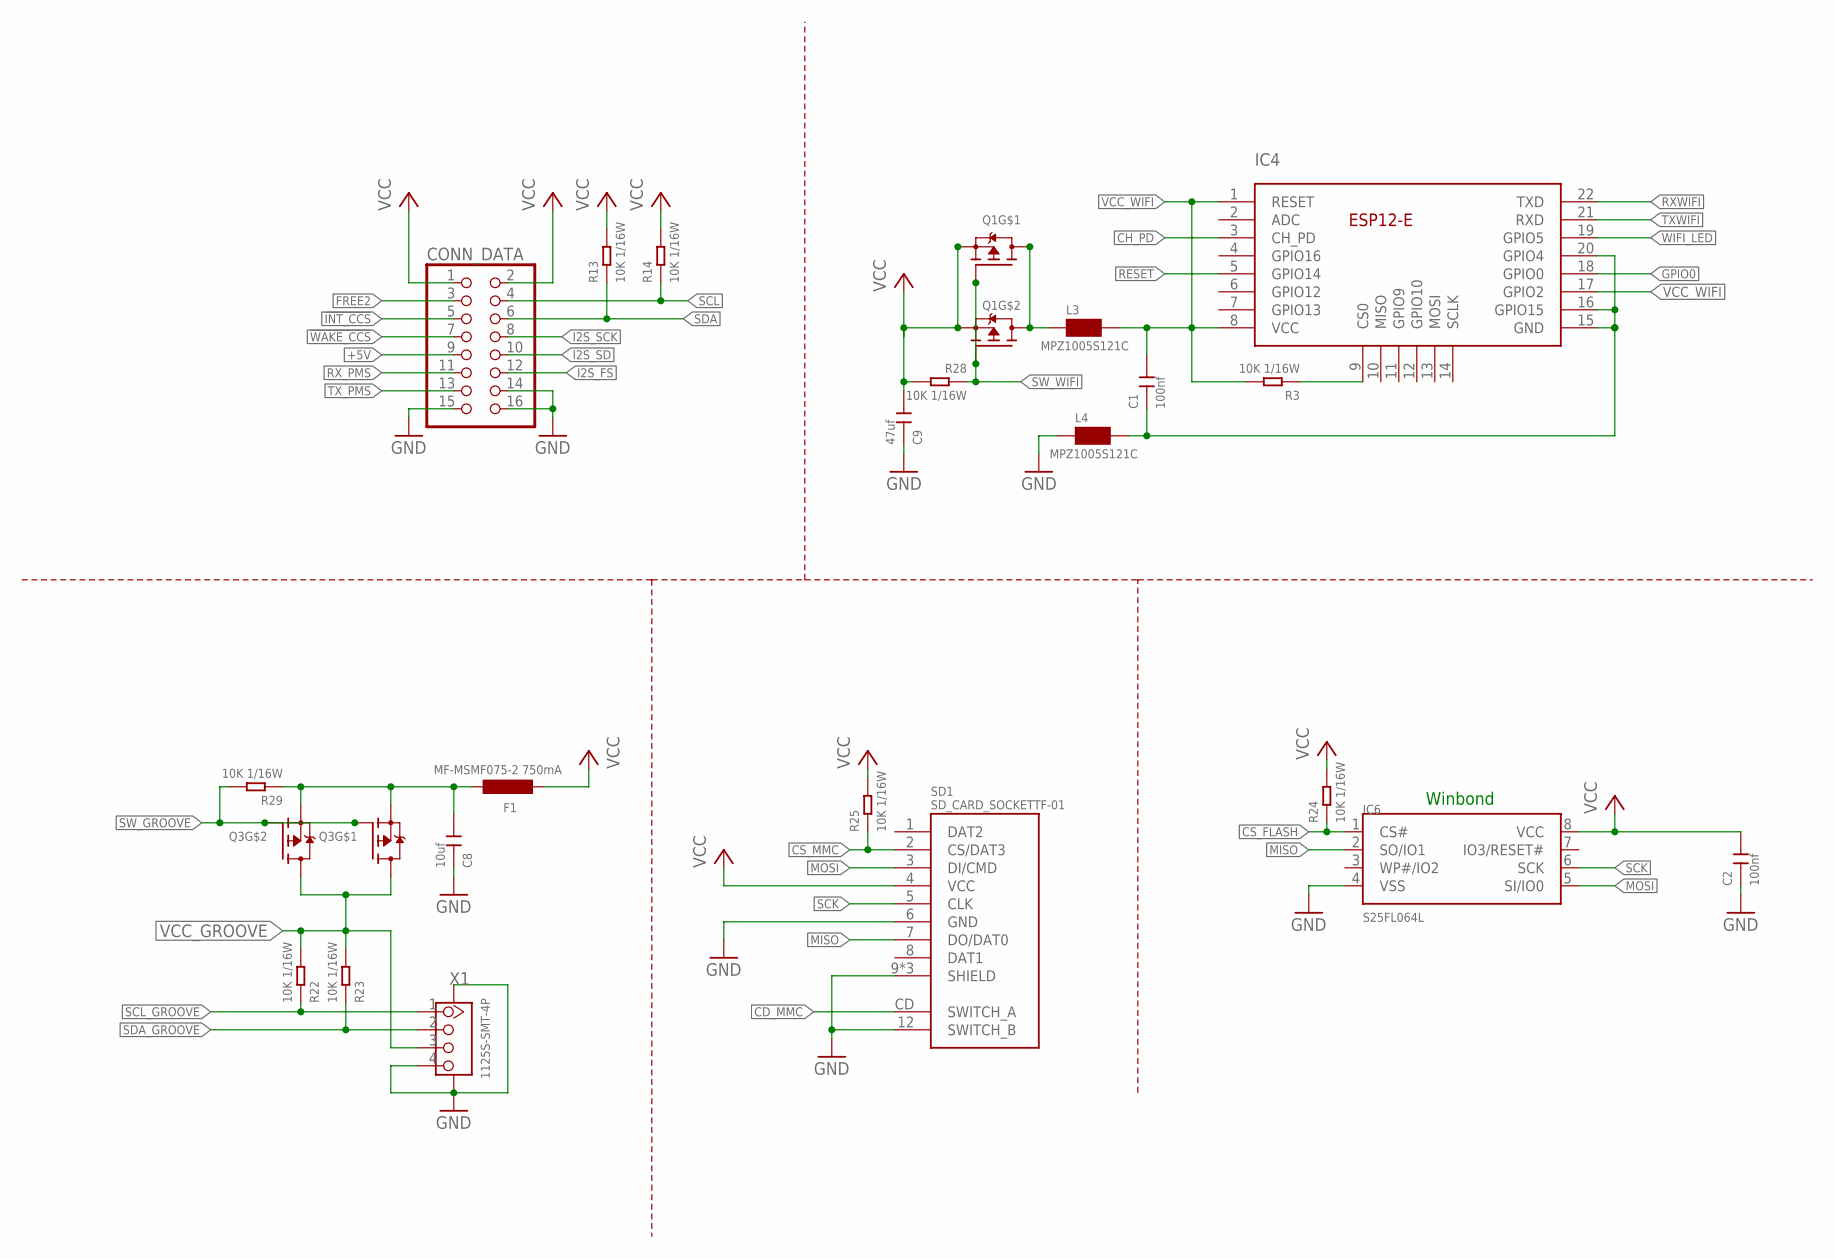
[picture p32: schematic SCK_DATA_BOARD_2.3.sch, sheet 3]

Parts:
C1, C2: 100nf; C0402
C8: 10uf; C1206
C9: 47uf; C1210
CONN_DATA: PINHD_2X8FEM_SMD; PINHD_2X8_SMD_FEMALE_UNHOLED
F1: MF-MSMF075-2 750mA; L1812
IC4: HANGAR_ESP-12-E; HANGAR_ESP12-E
IC6: S25FL064L; SOIC_8-208MILS
L3, L4: MPZ1005S121C; 0402
Q1: PMOS; POWERPAK-SC70-6L; MPN SIA923AEDJ-T1-GE3
Q3: PMOS; POWERPAK-SC70-6L
R3, R13, R14, R22, R23, R24, R25, R28, R29: 10K 1/16W; R0402
SD1: SD_CARD_SOCKETTF-01; TF-01; MPN 320090008
X1: 1125S-SMT-4P; CONNECTOR-NEW_HW4-SMD-2.0; MPN 320110030

Connections:
!INT_CCS: CONN_DATA.5; also elsewhere on the board
!WAKE_CCS: CONN_DATA.7; also elsewhere on the board
+5V: CONN_DATA.9; also elsewhere on the board
CD_MMC: SD1.CD (SWITCH_A); also elsewhere on the board
CH_PD: IC4.3 (CH_PD); also elsewhere on the board
CS_FLASH: IC6.1 (CS#), R24.1; also elsewhere on the board
CS_MMC: R25.1, SD1.2 (CS/DAT3); also elsewhere on the board
FREE2: CONN_DATA.3; also elsewhere on the board
GND: C2.1, C8.1, C9.1, CONN_DATA.14, CONN_DATA.15, CONN_DATA.16, IC6.4 (VSS), L4.2, SD1.6 (GND), SD1.9 (SHIELD), SD1.10 (SHIELD), SD1.11 (SHIELD), SD1.12 (SWITCH_B), X1.4, X1.SS1, X1.SS2; also elsewhere on the board
GND_WIFI: C1.1, IC4.15 (GND), IC4.16 (GPIO15), IC4.20 (GPIO4), L4.1
GPIO0: IC4.18 (GPIO0); also elsewhere on the board
I2S_FS: CONN_DATA.12; also elsewhere on the board
I2S_SCK: CONN_DATA.8; also elsewhere on the board
I2S_SD: CONN_DATA.10; also elsewhere on the board
MISO: IC6.2 (SO/IO1), SD1.7 (DO/DAT0); also elsewhere on the board
MOSI: IC6.5 (SI/IO0), SD1.3 (DI/CMD); also elsewhere on the board
unnamed: L3.2, Q1.3 (D), Q1.6 (D), Q1.TP1 (D), Q1.TP2 (D)
unnamed: IC4.9 (CS0), R3.1
RESET: IC4.5 (GPIO14); also elsewhere on the board
RXWIFI: IC4.22 (TXD); also elsewhere on the board
RX_PMS: CONN_DATA.11; also elsewhere on the board
SCK: IC6.6 (SCK), SD1.5 (CLK); also elsewhere on the board
SCL: CONN_DATA.4, R14.1; also elsewhere on the board
SCL_GROOVE: R22.1, X1.1; also elsewhere on the board
SDA: CONN_DATA.6, R13.1; also elsewhere on the board
SDA_GROOVE: R23.1, X1.2; also elsewhere on the board
SW_GROOVE: Q3.2 (G), Q3.5 (G), R29.2; also elsewhere on the board
SW_WIFI: Q1.2 (G), Q1.5 (G), R28.1; also elsewhere on the board
TXWIFI: IC4.21 (RXD); also elsewhere on the board
TX_PMS: CONN_DATA.13; also elsewhere on the board
VCC: C2.2, C9.2, CONN_DATA.1, CONN_DATA.2, F1.2, IC6.8 (VCC), Q1.1 (S), Q1.4 (S), R13.2, R14.2, R24.2, R25.2, R28.2, SD1.4 (VCC); also elsewhere on the board
VCC_GROOVE: Q3.3 (D), Q3.6 (D), Q3.TP1 (D), Q3.TP2 (D), R22.2, R23.2, X1.3
VCC_GROOVE_0: C8.2, F1.1, Q3.1 (S), Q3.4 (S), R29.1
VCC_WIFI: C1.2, IC4.1 (RESET), IC4.8 (VCC), IC4.17 (GPIO2), L3.1, R3.2
WIFI_LED: IC4.19 (GPIO5); also elsewhere on the board

Notes on the sheet:
Winbond

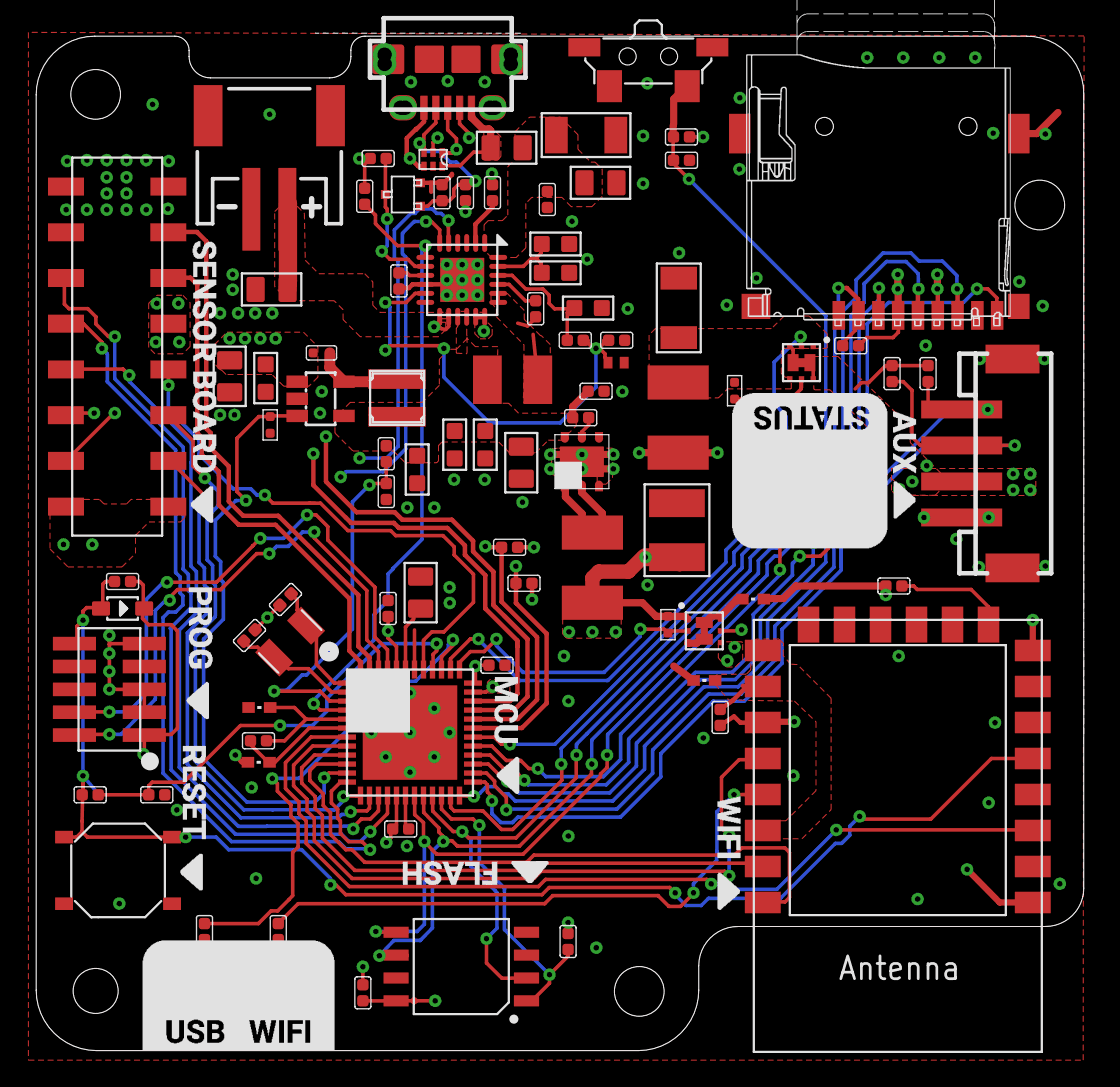
[picture p33: board SCK_DATA_BOARD_2.3.brd from above]

Board: 4 copper layers, 58.2 x 56.4 mm, 91 parts (0 on the bottom side), 74 nets.
