fablabbcn/smartcitizen-kit-2x/hardware/SCK2.3/SCK_URBAN_BOARD_2.3/SCK_URBAN_BOARD_2.3.brd

## EAGLE design hardware/SCK2.3/SCK_URBAN_BOARD_2.3/SCK_URBAN_BOARD_2.3.brd (2024-09-10)

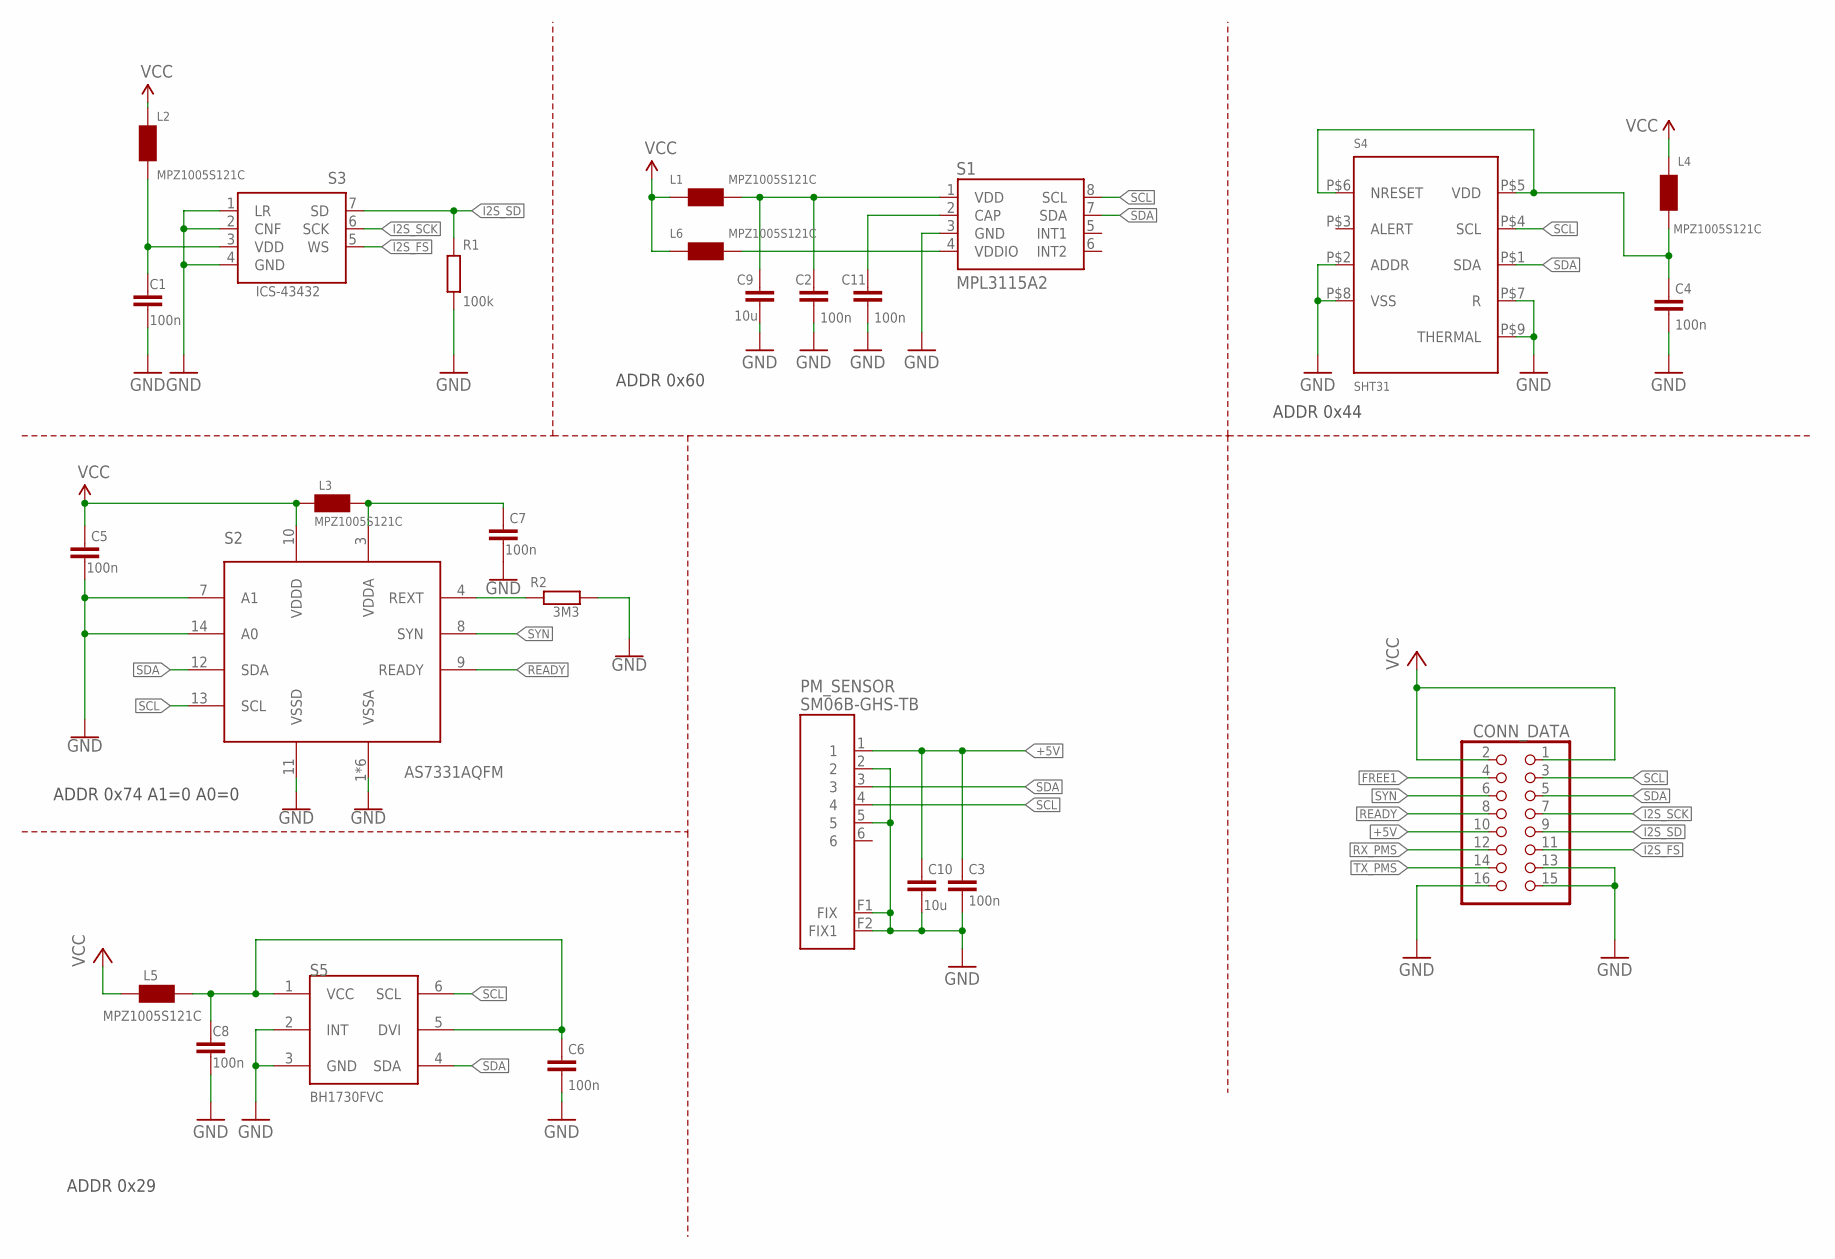
[picture p34: schematic SCK_URBAN_BOARD_2.3.sch]

Parts:
C1, C2, C3, C4, C5, C6, C7, C8, C11: 100n; C0402
C9, C10: 10u; C0603
CONN_DATA: PINHD_2X8MAL_SMD; PINHD_2X8_SMD_MALE_UNHOLED
L1, L2, L3, L4, L5, L6: MPZ1005S121C; L0402
PM_SENSOR: SM06B-GHS-TB
R1: 100k; R0402
R2: 3M3; R0402
S1: MPL3115A2
S2: AS7331AQFM; OLGA16
S3: ICS-43432
S4: SHT31; DFN8_STH3X-DIS
S5: BH1730FVC; WSOF6

Connections:
+5V: C3.2, C10.2, CONN_DATA.10, PM_SENSOR.1
FREE1: CONN_DATA.4
GND: C1.1, C2.1, C3.1, C4.1, C5.1, C6.1, C7.1, C8.1, C9.1, C10.1, C11.1, CONN_DATA.13, CONN_DATA.15, CONN_DATA.16, PM_SENSOR.2, PM_SENSOR.5, PM_SENSOR.F1 (FIX), PM_SENSOR.F2 (FIX1), R1.1, R2.2, S1.3 (GND), S2.1 (VSSA), S2.2 (VSSA), S2.5 (VSSA), S2.6 (VSSA), S2.7 (A1), S2.11 (VSSD), S2.14 (A0), S2.15 (VSSA), S2.16 (VSSA), S3.1 (LR), S3.2 (CNF), S3.4 (GND), S4.P$2 (ADDR), S4.P$7 (R), S4.P$8 (VSS), S4.P$9 (THERMAL), S5.2 (INT), S5.3 (GND)
I2S_FS: CONN_DATA.11, S3.5 (WS)
I2S_SCK: CONN_DATA.7, S3.6 (SCK)
I2S_SD: CONN_DATA.9, R1.2, S3.7 (SD)
unnamed: C7.2, L3.1, S2.3 (VDDA)
unnamed: R2.1, S2.4 (REXT)
unnamed: C6.2, C8.2, L5.2, S5.1 (VCC), S5.5 (DVI)
unnamed: C11.2, S1.2 (CAP)
unnamed: C4.2, L4.2, S4.P$5 (VDD), S4.P$6 (NRESET)
unnamed: L6.2, S1.4 (VDDIO)
unnamed: C2.2, C9.2, L1.2, S1.1 (VDD)
unnamed: C1.2, L2.2, S3.3 (VDD)
READY: CONN_DATA.8, S2.9 (READY)
RX_PMS: CONN_DATA.12
SCL: CONN_DATA.3, PM_SENSOR.4, S1.8 (SCL), S2.13 (SCL), S4.P$4 (SCL), S5.6 (SCL)
SDA: CONN_DATA.5, PM_SENSOR.3, S1.7 (SDA), S2.12 (SDA), S4.P$1 (SDA), S5.4 (SDA)
SYN: CONN_DATA.6, S2.8 (SYN)
TX_PMS: CONN_DATA.14
VCC: C5.2, CONN_DATA.1, CONN_DATA.2, L1.1, L2.1, L3.2, L4.1, L5.1, L6.1, S2.10 (VDDD)

Notes on the sheet:
ADDR 0x44
ADDR 0x29
ADDR 0x74 A1=0 A0=0
ADDR 0x60

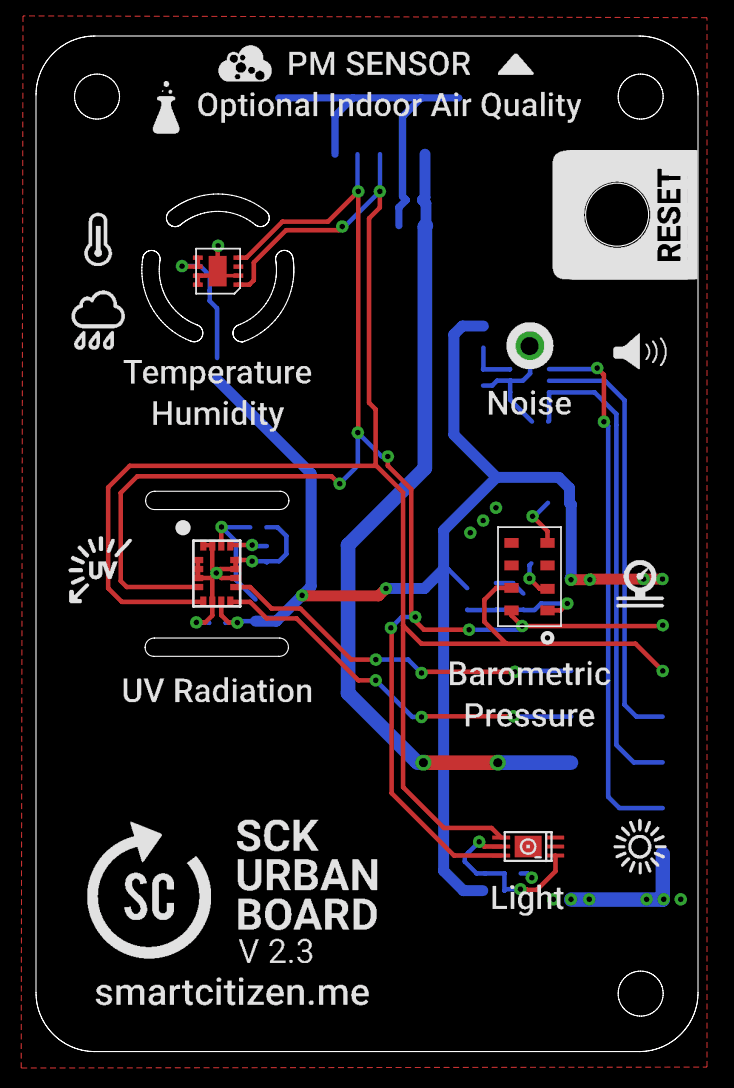
[picture p35: board SCK_URBAN_BOARD_2.3.brd from above]

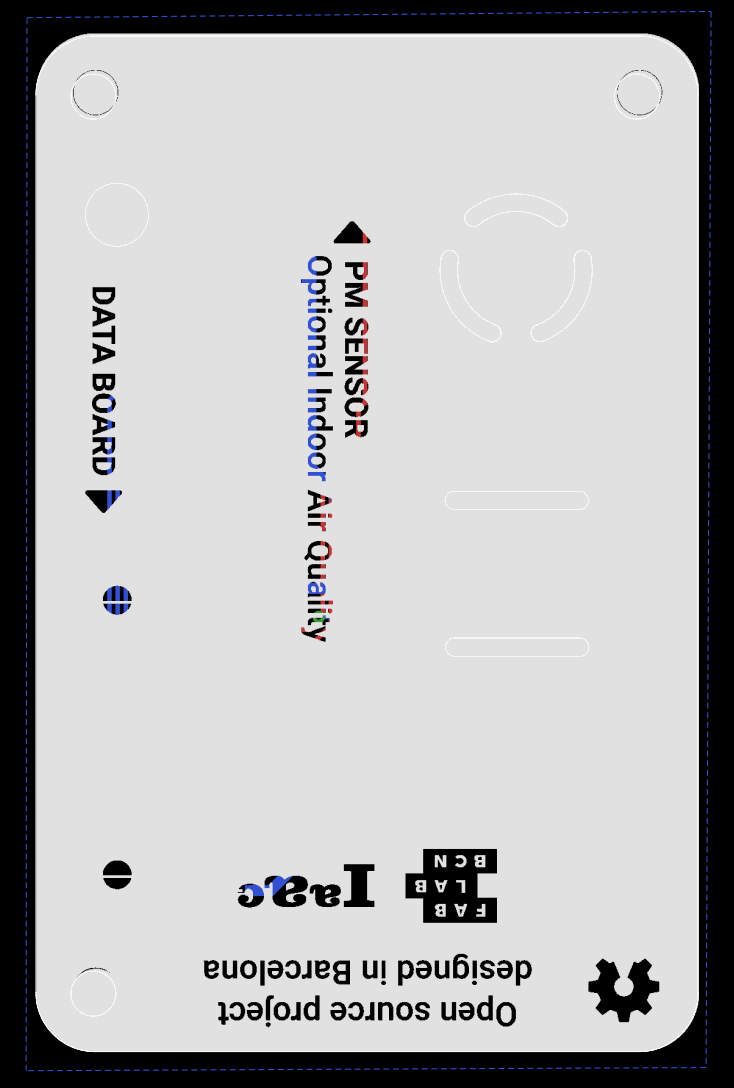
[picture p36: board SCK_URBAN_BOARD_2.3.brd from below]

Board: 2 copper layers, 36.8 x 56.4 mm, 26 parts (22 on the bottom side), 18 nets.
