fablabbcn/smartcitizen-kit-2x/sam/src/SmartCitizenKit.ino

#include "SckBase.h"

#ifdef SC_TESTING
#include "SckTest.h"
#endif

SckBase base;

#ifdef SC_TESTING
SckTest sckTest(&base);
#endif

bool reset_pending = false;

// Led update interrupt
void TC5_Handler (void)
{
    base.led.tick();
    TC5->COUNT16.INTFLAG.bit.MC0 = 1;
}

// Button events interrupt
void ISR_button()
{
    base.butState = digitalRead(pinBUTTON);
#ifdef SC_TESTING
    sckTest.test_button();
#else
    base.butFeedback();
#endif
}

// Card detect interrupt
void ISR_sdDetect()
{
    base.sdDetect();
}

// void ISR_alarm() {
//  base.wakeUp();
// };

void setup()
{

    base.setup();

#ifdef SC_TESTING
    sckTest.test_full();
#endif
}

void loop()
{
    base.update();
    base.inputUpdate();
}
