fablabbcn/smartcitizen-kit-2x/sam/src/SckAux.h

#pragma once

#include <SckBase.h>
#include <Sensors.h>

// Include the necessary libraries for the auxiliary sensor to be used
#include <Wire.h>
#include <FlashStorage.h>

#ifdef SCK_WITH_INA219
// INA219 libs
#include <Adafruit_INA219.h>
#endif

#ifdef SCK_WITH_GASES_BOARD
// Gases Board libs
#include <GasesBoard.h>
#endif

// Urban board library
#include <SckUrban.h>

#ifdef SCK_WITH_SENSOR_GROVE_OLED
// Groove_OLED libs
#include <U8g2lib.h>
// Icons for screen
#include <Icons.h>
#endif

// DS2482 library (I2C-1Wire bridge)
#include <DS2482.h>

#ifdef SCK_WITH_CHIRP
// I2C Moisture Sensor (chirp)
#include <I2CSoilMoistureSensor.h>
#endif

#ifdef SCK_WITH_DALLAS_TEMP
// Libraries for DallasTemp
#include <OneWire.h>
#include <DallasTemperature.h>
#endif

#ifdef SCK_WITH_RANGE
// Sparkfun VL6180x time of flight range finder
#include <SparkFun_VL6180X.h>
#endif

#ifdef SCK_WITH_GPS
// Library for GPS data parsing
#include "TinyGPS++.h"

// Librtary for XA1110 Sparkfun i2c GPS
#include <SparkFun_I2C_GPS_Arduino_Library.h>

// Library for SparkFun u-Blox NEO-M8U GPS
#ifdef ID
#undef ID   // Fix conflict with define on SPIMemory.h
#endif
#include <SparkFun_u-blox_GNSS_Arduino_Library.h>
#endif

#ifdef SCK_WITH_ADS1X15
// Adafruit library for ADS1x15 12/16 bits ADC
#include <Adafruit_ADS1X15.h>
#endif

// ADS Tester (Only supported in version 2.0 and greater)
// This function is only for internal purposes
// #define adsTest  // Uncomment for enabling tester board support (remember selecting board lookup table in GasesBoardTester.h)

#ifdef adsTest
#include "GasesBoardTester.h"
#endif

#ifdef SCK_WITH_SCD30
// Sparkfun library for SCD30 CO2 sensor
#include <SparkFun_SCD30_Arduino_Library.h>
#endif

#ifdef SCK_WITH_SCD4X
// Sensirion I2C SCD4X library
#include <SensirionI2cScd4x.h>
#endif

#ifdef  SCK_WITH_SFA30
// Sensirion I2C SFA3X library
#include <SensirionI2CSfa3x.h>
#endif

#ifdef SCK_WITH_AS7341
// Adafruit I2C AS7341 library
#include <Adafruit_AS7341.h>
#endif


extern TwoWire auxWire;

// Define speeds for AUX_WIRE and OLED_CLOCK to restore i2c
#define SCK_AUX_WIRE_STD_CLOCK 100000
#ifdef SCK_WITH_SENSOR_GROVE_OLED
#define SCK_AUX_WIRE_OLED_CLOCK 1000000
#endif

class SckBase;


struct MoistureCalibration {
    bool  moistureCalDataValid = false;
    int32_t dryPoint;
    int32_t wetPoint;
};

struct TempCalibration {
    float  extTemperatureOffset = 0;
    float  extHumidityOffset = 0;
};

struct AtlasConfig {
    bool  pHEnableTComp = true;
    bool  DOEnableTComp = true;
    bool  ECEnableTComp = true;
};

struct EepromAuxData {
    bool valid = false;
    MoistureCalibration moistCalibration;
    TempCalibration rhtCalibration;
    AtlasConfig atlasConfig;
};

bool I2Cdetect(byte address);

class AuxBoards
    {

    public:

        // List for storing Auxiliary sensors I2C address
        // TODO review and update this list, it may better be on other place.
        // 0x55,           // SENSOR_GASESBOARD_SLOT_1A,
        // 0x55,           // SENSOR_GASESBOARD_SLOT_1W,
        // 0x56,           // SENSOR_GASESBOARD_SLOT_2A,
        // 0x56,           // SENSOR_GASESBOARD_SLOT_2W,
        // 0x54,           // SENSOR_GASESBOARD_SLOT_3A,
        // 0x54,           // SENSOR_GASESBOARD_SLOT_3W,
        // 0x44,           // SENSOR_GASESBOARD_TEMPERATURE,
        // 0x44,           // SENSOR_GASESBOARD_HUMIDITY,
        //
        // 0x50,           // SENSOR_GROOVE_I2C_ADC,
        //
        // 0x41,           // SENSOR_INA219_BUSVOLT,
        // 0x41,           // SENSOR_INA219_SHUNT,
        // 0x41,           // SENSOR_INA219_CURRENT,
        // 0x41,           // SENSOR_INA219_LOADVOLT,
        //
        // 0x18,           // SENSOR_WATER_TEMP_DS18B20,
        // 0x66,           // SENSOR_ATLAS_TEMPERATURE,
        // 0x63,           // SENSOR_ATLAS_PH,
        // 0x64,           // SENSOR_ATLAS_EC,
        // 0x64,           // SENSOR_ATLAS_EC_SG,
        // 0x64,           // SENSOR_ATLAS_EC_SAL,
        // 0x64,           // SENSOR_ATLAS_EC_TDS,
        // 0x61,           // SENSOR_ATLAS_DO,
        // 0x61,           // SENSOR_ATLAS_DO_SAT,
        // 0x62,           // SENSOR_ATLAS_ORP,
        //
        // 0x61,           // SENSOR_SCD30_CO2,    --> Conflict with SENSOR_ATLAS_DO
        // 0x61,           // SENSOR_SCD30_TEMP,   --> Conflict with SENSOR_ATLAS_DO
        // 0x61,           // SENSOR_SCD30_HUM,    --> Conflict with SENSOR_ATLAS_DO

        // 0x62,           // SENSOR_SCD4X_CO2,    --> Conflict with SENSOR_ATLAS_ORP
        // 0x62,           // SENSOR_SCD4X_TEMP,   --> Conflict with SENSOR_ATLAS_ORP
        // 0x62,           // SENSOR_SCD4X_HUM,    --> Conflict with SENSOR_ATLAS_ORP

        // 0x20,           // SENSOR_CHIRP_MOISTURE_RAW,
        // 0x20,           // SENSOR_CHIRP_MOISTURE,
        // 0x20,           // SENSOR_CHIRP_TEMPERATURE,
        // 0x20,           // SENSOR_CHIRP_LIGHT,

        // 0x02,           // SENSOR_EXT_PM_1,
        // 0x02,           // SENSOR_EXT_PM_25,
        // 0x02,           // SENSOR_EXT_PM_10,
        // 0x02,           // SENSOR_EXT_PN_03,
        // 0x02,           // SENSOR_EXT_PN_05,
        // 0x02,           // SENSOR_EXT_PN_1,
        // 0x02,           // SENSOR_EXT_PN_25,
        // 0x02,           // SENSOR_EXT_PN_5,
        // 0x02,           // SENSOR_EXT_PN_10,
        // 0x02,           // SENSOR_EXT_A_PM_1,
        // 0x02,           // SENSOR_EXT_A_PM_25,
        // 0x02,           // SENSOR_EXT_A_PM_10,
        // 0x02,           // SENSOR_EXT_A_PN_03,
        // 0x02,           // SENSOR_EXT_A_PN_05,
        // 0x02,           // SENSOR_EXT_A_PN_1,
        // 0x02,           // SENSOR_EXT_A_PN_25,
        // 0x02,           // SENSOR_EXT_A_PN_5,
        // 0x02,           // SENSOR_EXT_A_PN_10,
        // 0x02,           // SENSOR_EXT_B_PM_1,
        // 0x02,           // SENSOR_EXT_B_PM_25,
        // 0x02,           // SENSOR_EXT_B_PM_10,
        // 0x02,           // SENSOR_EXT_B_PN_03,
        // 0x02,           // SENSOR_EXT_B_PN_05,
        // 0x02,           // SENSOR_EXT_B_PN_1,
        // 0x02,           // SENSOR_EXT_B_PN_25,
        // 0x02,           // SENSOR_EXT_B_PN_5,
        // 0x02,           // SENSOR_EXT_B_PN_10,

        // 0x02,           // SENSOR_PM_DALLAS_TEMP,
        // 0x00,           // SENSOR_DALLAS_TEMP,      -- 2 wire (no I2C address)

        // 0x44,           // SENSOR_SHT31_TEMP,
        // 0x44,           // SENSOR_SHT31_HUM,
        // 0x45,           // SENSOR_SHT35_TEMP,
        // 0x45,           // SENSOR_SHT35_HUM,

        // 0x29,           // SENSOR_RANGE_LIGHT,
        // 0x29,           // SENSOR_RANGE_DISTANCE,

        // 0x02,           // SENSOR_GPS_* Grove Gps (on PM board)
        // 0x10,           // SENSOR_GPS_* XA111 Gps
        // 0x42,           // SENSOR_GPS_* NEO-M8U Gps

        // 0x3c,           // SENSOR_GROOVE_OLED,
        // 0x48,           // SENSOR_ADS1X15_XX_X
        // 0x49,           // SENSOR_ADS1X15_XX_X
        // 0x4a,           // SENSOR_ADS1X15_XX_X
        // 0x4b,           // SENSOR_ADS1X15_XX_X

        // 0x5d,           // SENSOR_SFA30_TEMPERATURE,
        // 0x5d,           // SENSOR_SFA30_HUMIDITY,
        // 0x5d,           // SENSOR_SFA30_FORMALDEHYDE,

        // 0x39            // SENSOR_AS7341_415NM_F1
        // 0x39            // SENSOR_AS7341_445NM_F2
        // 0x39            // SENSOR_AS7341_480NM_F3
        // 0x39            // SENSOR_AS7341_515NM_F4
        // 0x39            // SENSOR_AS7341_555NM_F5
        // 0x39            // SENSOR_AS7341_590NM_F6
        // 0x39            // SENSOR_AS7341_630NM_F7
        // 0x39            // SENSOR_AS7341_680NM_F8
        // 0x39            // SENSOR_AS7341_CLEAR
        // 0x39            // SENSOR_AS7341_NIR
        // 0x39            // SENSOR_AS7341_FLICKER_FREQ

        bool start(SckBase *base, SensorType whichSensor);
        bool stop(SensorType whichSensor);
        void getReading(SckBase *base, OneSensor *whichSensor);
        bool getBusyState(SensorType whichSensor);
        String control(SensorType whichSensor, String command);
#ifdef SCK_WITH_SENSOR_GROVE_OLED
        void print(char *payload);
        void updateDisplay(SckBase* base, bool force=false);
        void plot(String value, const char *title=NULL, const char *unit=NULL);
#endif
#ifdef SCK_WITH_GPS
        bool updateGPS();
#endif

        EepromAuxData data;
        bool dataLoaded = false;
    private:
    };

#ifdef SCK_WITH_GROVE_I2C_ADC
class GrooveI2C_ADC
    {
    public:

        bool start();
        bool stop();
        float getReading();

        const byte deviceAddress    = 0x59;
        const float V_REF       = 3.30;
        const byte REG_ADDR_RESULT  = 0x00;
        const byte REG_ADDR_ALERT   = 0x01;
        const byte REG_ADDR_CONFIG  = 0x02;
        const byte REG_ADDR_LIMITL  = 0x03;
        const byte REG_ADDR_LIMITH  = 0x04;
        const byte REG_ADDR_HYST    = 0x05;
        const byte REG_ADDR_CONVL   = 0x06;
        const byte REG_ADDR_CONVH   = 0x07;

    private:
    };
#endif

#ifdef SCK_WITH_INA219
class INA219
    {
    public:

        const byte deviceAddress = 0x41;

        enum typeOfReading {BUS_VOLT, SHUNT_VOLT, CURRENT, LOAD_VOLT};

        Adafruit_INA219 ada_ina219 = Adafruit_INA219(deviceAddress);
        bool start();
        bool stop();
        float getReading(typeOfReading whichReading=CURRENT);

    private:
    };
#endif

#ifdef SCK_WITH_SENSOR_GROVE_OLED
// This implementation works with a 128x128 pixel Oled screen with SH1107 controler
class Groove_OLED
    {
    public:
        const byte deviceAddress = 0x3c;
        const uint32_t showTime = 3;

        U8G2_SH1107_SEEED_128X128_F_2ND_HW_I2C u8g2_oled = U8G2_SH1107_SEEED_128X128_F_2ND_HW_I2C(U8G2_R0, U8X8_PIN_NONE);

        bool start();
        bool stop();
        void print(char *payload);
        void update(SckBase* base, bool force);
        void displayReading(SckBase* base, bool force=false);
        void plot(String value, const char *title=NULL, const char *unit=NULL);

    private:
        const char *_unit;
        const char *_title;

        uint32_t lastUpdate;
        const uint32_t refreshRate = 50;

        void drawBar(SckBase* base);
        void drawError(errorType whichError);
        errorType lastError = ERROR_NONE;
        void drawSetup(SckBase* base);

        // Plot
        void remap(float newMaxY);
        const float screenMax = 100;
        const float screenMin = 0;
        LinkedList<int8_t> plotData;
        float maxY = 100;
        float minY = 0;

        // For debug log view
        void printLine(char *payload, uint8_t size);
        const uint8_t *font = u8g2_font_6x10_mr;    // if you change font update the next two variables
        const uint8_t font_width = 6;
        const uint8_t font_height = 10;
        const uint8_t columns = 21;
        const uint8_t lines = 12;
        uint8_t currentLine = 1;

        SensorType lastShown;
        uint32_t showStartTime = 0;
    };
#endif

#ifdef SCK_WITH_DS18B20
/*! @class DS2482_100
 *  @brief class for handling the DS18B20 temperature sensor connected to the I2C port
 *   through the DS2482-100 board. This was based on an example made by
 *   <a href="https://github.com/paeaetech/paeae.git">paeae</a>
 */
class WaterTemp_DS18B20
    {

    public:

        const byte deviceAddress = 0x18;

        DS2482 DS_bridge = DS2482(0);

        byte data[9];
        byte addr[8];

        const uint8_t conf =0x05;

        bool detected = false;

        /* Start the transmission of data for the DS18B20 trough the DS2482_100 bridge */
        bool start();
        bool stop();
        /* Read the temperature of the DS18B20 through the DS2482_100 bridge */
        /* @return Temperature */
        float getReading();
    private:
    };
#endif

#ifdef SCK_WITH_ATLAS
class Atlas
    {
    public:

        byte deviceAddress;
        SensorType atlasType;
        bool PH = false;
        bool EC = false;
        bool DO = false;
        bool TEMP = false;
        bool ORP = false;
        bool enableTComp = true;
        float newReading[4];
        String atlasResponse;
        uint32_t lastCommandSent = 0;
        uint32_t lastUpdate = 0;
        enum State {
            REST,
            SLEEP,
            TEMP_COMP_SENT,
            ASKED_READING,
        };
        State state = REST;

        // Constructor varies by sensor type
        Atlas(SensorType whichSensor) {
            atlasType = whichSensor;

            switch(atlasType) {
                case SENSOR_ATLAS_PH: {

                    deviceAddress = 0x63;
                    PH = true;
                    break;

                } case SENSOR_ATLAS_EC:
                case SENSOR_ATLAS_EC_TDS:
                case SENSOR_ATLAS_EC_SAL:
                case SENSOR_ATLAS_EC_SG: {

                    deviceAddress = 0x64;
                    EC = true;
                    break;

                } case SENSOR_ATLAS_DO:
                case SENSOR_ATLAS_DO_SAT: {

                    deviceAddress = 0x61;
                    DO = true;
                    break;

                } case SENSOR_ATLAS_TEMPERATURE: {

                    deviceAddress = 0x66;
                    TEMP = true;
                    break;

                } case SENSOR_ATLAS_ORP: {

                    deviceAddress = 0x62;
                    ORP = true;
                    break;

                } default: break;
            }

        }

        bool start();
        bool beginDone = false;
        bool stop();
        bool getReading();
        bool getBusyState();

        void goToSleep();
        bool sendCommand(char* command);
        bool tempCompensation();
        uint8_t getResponse();

        const uint16_t longWait = 910; //ms
        const uint16_t mediumWait = 610; //ms
        const uint16_t shortWait = 310; //ms

        bool detected = false;

    private:
    };
#endif

#ifdef SCK_WITH_CHIRP
class Moisture
    {
    private:
        const byte deviceAddress = 0x20;
        I2CSoilMoistureSensor chirp = I2CSoilMoistureSensor(deviceAddress);
        bool alreadyStarted = false;

    public:
        bool detected = false;
        bool calibrated = false;
        int32_t dryPoint;
        int32_t wetPoint;

        bool start();
        bool stop();
        bool getReading(SensorType whichSensor);
        uint8_t getVersion();
        bool resetAddress(int currentAddress);

        uint32_t raw;
        float moisture;
        int16_t temperature;
        int32_t light;

        // TODO
        // * Measure sensor consumption
        // * Send sensor to sleep between readings (needs FIX, it hangs)
        void sleep();
    };
#endif

#ifdef SCK_WITH_PMS
enum PMslot {SLOT_A, SLOT_B, SLOT_AVG};
#endif
enum PMcommands
{
#ifdef SCK_WITH_PMS
    START_PMA,      // Start PM in slot A
    START_PMB,          // Start PM in slot B
    GET_PMA,        // Get values for PM in slot A
    GET_PMB,        // Get values for PM in slot B
    STOP_PMA,       // Stop PM in slot A
    STOP_PMB,       // Stop PM in slot B
#endif
#ifdef SCK_WITH_DALLAS_TEMP
    DALLASTEMP_START,
    DALLASTEMP_STOP,
    GET_DALLASTEMP,
#endif
#ifdef SCK_WITH_GPS
    GROVEGPS_START,
    GROVEGPS_STOP,
    GROVEGPS_GET
#endif
};

#ifdef SCK_WITH_PMS
class PMsensor
    {
    public:
        // Constructor varies by sensor type
        PMsensor(PMslot whichSlot) {
            _slot = whichSlot;
        }

        const byte deviceAddress = 0x02;

        uint16_t pm1;
        uint16_t pm25;
        uint16_t pm10;
        uint16_t pn03;
        uint16_t pn05;
        uint16_t pn1;
        uint16_t pn25;
        uint16_t pn5;
        uint16_t pn10;

        bool start();
        bool stop();
        bool update();
    private:
        bool started = false;
        bool failed = false;

        static const uint8_t valuesSize = 18;
        uint8_t values[valuesSize];

        // 24 bytes:
        // 0:1->pm1, 2:3->pm25, 4:5->pm10,
        // Number of particles with diameter beyond X um in 0.1 L of air.
        // 6:7 -> 0.3 um
        // 8:9 -> 0.5 um
        // 10:11 -> 1.0 um
        // 12:13 -> 2.5 um
        // 14:15 -> 5.0 um
        // 16:17 -> 10.0 um
        //
        uint32_t lastReading = 0;
        PMslot _slot;
    };
#endif

#ifdef SCK_WITH_DALLAS_TEMP
class PM_DallasTemp
    {
    public:
        const byte deviceAddress = 0x02;
        bool start();
        bool stop();
        float getReading();
    private:
        union u_reading {
            byte b[4];
            float fval;
        } uRead;

        float reading;
    };
#endif

#ifdef SCK_WITH_GPS
struct GpsReadings
{
    // Data (40 bytes)
    // Fix Quality -> uint8 - 1
    //  0 = Invalid
    //  1 = GPS fix (SPS)
    //  2 = DGPS fix
    //  3 = PPS fix
    //  4 = Real Time Kinematic
    //  5 = Float RTK
    //  6 = estimated (dead reckoning) (2.3 feature)
    //  7 = Manual input mode
    //  8 = Simulation mode
    // locationValid -> bool - 1
    // Latitude DDD.DDDDDD (negative is south) -> double - 8
    // Longitude DDD.DDDDDD (negative is west) -> double - 8
    // altitudeValid -> bool - 1
    // Altitude in meters -> float - 4
    // timeValid -> bool - 1
    // Time (epoch) -> uint32 - 4
    // speedValid -> bool - 1
    // Speed (meters per second) -> float - 4
    // hdopValid -> bool - 1
    // Horizontal dilution of position -> float - 4
    // satellitesValid -> bool - 1
    // Number of Satellites being traked -> uint8 - 1

    uint8_t fixQuality = 0;
    bool locationValid = false;
    double latitude;
    double longitude;
    bool altitudeValid = false;
    float altitude;
    bool speedValid = false;
    float speed;
    bool hdopValid = false;
    float hdop;
    bool satellitesValid = false;
    uint8_t satellites;
    bool timeValid = false;
    uint32_t epochTime = 0;
};
#endif

#ifdef SCK_WITH_GPS
class GPS_Source
    {
    public:
        virtual bool stop();
        virtual bool getReading(SensorType whichSensor, GpsReadings &r);
        virtual bool update();
    };

class Sck_GPS
    {
    private:
        bool started = false;
        uint8_t fixCounter = 0;
        GPS_Source *gps_source;
    public:
        GpsReadings r;

        bool start();
        bool stop();
        bool getReading(SckBase *base, SensorType whichSensor);
        bool update();
    };

class PM_Grove_GPS: public GPS_Source
    {
    public:
        const byte deviceAddress = 0x02;

        bool start();
        virtual bool stop();
        virtual bool getReading(SensorType whichSensor, GpsReadings &r);
        virtual bool update();

    private:
        static const uint8_t DATA_LEN = 40;
        byte data[DATA_LEN];
        uint32_t lastReading = 0;
    };

class XA111GPS: public GPS_Source
    {
    public:
        const byte deviceAddress = 0x10;

        bool start();
        virtual bool stop();
        virtual bool getReading(SensorType whichSensor, GpsReadings &r);
        virtual bool update();

    private:
        I2CGPS i2cGps;
        uint32_t lastReading = 0;

    };

class NEOM8UGPS: public GPS_Source
    {
    public:
        const byte deviceAddress = 0x42;

        bool start();
        virtual bool stop();
        virtual bool getReading(SensorType whichSensor, GpsReadings &r);
        virtual bool update();

    private:
        SFE_UBLOX_GNSS ubloxGps;
        uint32_t lastReading = 0;

    };
#endif

#ifdef SCK_WITH_DALLAS_TEMP
class Sck_DallasTemp
    {
        // This is for a Dallas temperature sensor connected to the plugged in Aux groove connector using pin pinAUX_WIRE_SCL (13 - PA17)
    public:
        bool start();
        bool stop();
        bool getReading();

        float reading;
    private:
        uint8_t _oneWireAddress[8];
    };
#endif

#ifdef SCK_WITH_RANGE
class Sck_Range
    {
    public:
        const byte deviceAddress = 0x29;
        bool start();
        bool stop();
        bool getReading(SensorType whichSensor);

        float readingLight;
        float readingDistance;
    private:

        bool alreadyStarted = false;
        VL6180x vl6180x = VL6180x(deviceAddress);
    };
#endif

#ifdef SCK_WITH_ADS1X15
class Sck_ADS1X15
    {
    public:
        const byte deviceAddress = 0x48;
        bool start(uint8_t address);
        bool stop();
        bool getReading(uint8_t whichChannel);
        float reading;

#ifdef adsTest
        uint8_t adsChannelW = 0; // Default channel for WE
        uint8_t adsChannelA = 1; // Default channel for AE
        void setTesterCurrent(int16_t whichCurrent, uint8_t whichChannel);
        // double preVoltA = -99;
        // double preVoltW = -99;
        // double threshold = 0.05;
        // uint8_t maxErrorsA = 5;
        // uint8_t maxErrorsW = 5;
        void runTester(uint8_t whichChannel);
        testerGasesBoard tester;
#endif

    private:
        const float VOLTAGE = 3.3;
        bool started = false;
        Adafruit_ADS1115 ads = Adafruit_ADS1115();

        // TODO
        // Test ADS1015
    };
#endif

#ifdef SCK_WITH_SCD30
class Sck_SCD30
    {
    public:
        const byte deviceAddress = 0x61;
        bool start(SckBase *base, SensorType whichSensor);
        bool stop(SensorType whichSensor);
        bool getReading(SensorType whichSensor);
        uint16_t interval(uint16_t newInterval=0);
        bool autoSelfCal(int8_t value=-1);
        uint16_t forcedRecalFactor(uint16_t newFactor=0);
        float tempOffset(float userTemp, bool off=false);

        uint16_t co2 = 0;
        float temperature = 0;
        float humidity = 0;

        bool pressureCompensated = false;

    private:
        uint8_t enabled[3][2] = { {SENSOR_SCD30_CO2, 0}, {SENSOR_SCD30_TEMP, 0}, {SENSOR_SCD30_HUM, 0} };
        bool _debug = false;
        bool started = false;
        uint16_t measInterval = 2;  // "2-1800 seconds"
        SCD30 sparkfun_scd30;
    };
#endif

#ifdef SCK_WITH_SCD4X
#define SCK_SCD4X_MAX_RETRIES 3
#define SCK_SCD4X_INTERVAL_MS 100
#define SCK_SCD4X_NO_ERROR 0
class Sck_SCD4X
    {
    public:
        const byte deviceAddress = 0x62;
        bool start(SensorType whichSensor);
        bool stop(SensorType whichSensor);
        bool getReading();
        bool autoSelfCal(int8_t value=-1);
        int16_t forcedRecalFactor(uint16_t newFactor=0);
        float tempOffset(float userTemp, bool off);
        bool factoryReset();

        enum SCD4XState { SCD4X_OFF, SCD4X_IDLE, SCD4X_MEASUREMENT };
        SCD4XState state = SCD4X_OFF;
        SCD4xSensorVariant sensorVariant{};

        uint16_t co2 = 0;
        float temperature = 0;
        float humidity = 0;
        uint16_t ascActive = 0;

    private:
        uint8_t enabled[3][2] = { {SENSOR_SCD4X_CO2, 0}, {SENSOR_SCD4X_TEMP, 0}, {SENSOR_SCD4X_HUM, 0} };
        bool _debug = false;
        bool started = false;
        uint32_t lastRead = 0;
        bool stopMeasurement();
        bool wakeUp();
        bool startMeasurement();
        SensirionI2cScd4x sensirion_scd4x;
    };
#endif

#ifdef  SCK_WITH_SFA30
class Sck_SFA30
    {
    public:
        const byte deviceAddress = 0x5d;
        bool start(SensorType whichSensor);
        bool stop(SensorType whichSensor);
        bool getReading(SensorType whichSensor);
        bool debug = false;

        float temperature = 0;
        float humidity = 0;
        float formaldehyde = 0;

    private:
        static const uint8_t totalMetrics = 3;
        uint8_t enabled[totalMetrics][2] = { {SENSOR_SFA30_TEMPERATURE, 0}, {SENSOR_SFA30_HUMIDITY, 0}, {SENSOR_SFA30_FORMALDEHYDE, 0} };
        bool started = false;
        bool isError(uint16_t response);

        SensirionI2CSfa3x sensirion_sfa30;
    };
#endif

#ifdef  SCK_WITH_AS7341
#define SCK_AS7341_ATIME 100
#define SCK_AS7341_ASTEP 999
#define SCK_AS7341_INTERVAL_MS 5000
#define SCK_AS7341_NUM_SAMPLES 128
#define SCK_AS7341_FD_TIME 700
#define SCK_AS7341_FD_GAIN AS7341_GAIN_32X
#define SCK_AS7341_MAX UINT16_MAX
#define SCK_AS7341_N_SPECTRAL_READINGS 12
#define SCK_AS7341_N_RETRIES 3
class Sck_AS7341
    {
    public:
        const byte deviceAddress = 0x39;
        bool start(SensorType whichSensor);
        bool stop(SensorType whichSensor);
        bool getSpectralReading();
        bool getFlickerReading();
        bool debug = false;
        static const uint16_t SAMPLE_NUM = SCK_AS7341_NUM_SAMPLES;
        static const uint16_t FFT_NUM = SCK_AS7341_NUM_SAMPLES / 2;

        float channel_f1 = 0;
        float channel_f2 = 0;
        float channel_f3 = 0;
        float channel_f4 = 0;
        float channel_f5 = 0;
        float channel_f6 = 0;
        float channel_f7 = 0;
        float channel_f8 = 0;
        float channel_clear = 0;
        float channel_nir = 0;
        float flickerPeakFreq = 0;
        float flickerPeakToPeak = 0;
        // TODO make flicker sampling configurable in gain or dynamic?

    private:
        static const uint8_t totalMetrics = 12;
        uint8_t enabled[totalMetrics][2] = {
            {SENSOR_AS7341_415NM_F1, 0},
            {SENSOR_AS7341_445NM_F2, 0},
            {SENSOR_AS7341_480NM_F3, 0},
            {SENSOR_AS7341_515NM_F4, 0},
            {SENSOR_AS7341_555NM_F5, 0},
            {SENSOR_AS7341_590NM_F6, 0},
            {SENSOR_AS7341_630NM_F7, 0},
            {SENSOR_AS7341_680NM_F8, 0},
            {SENSOR_AS7341_CLEAR, 0},
            {SENSOR_AS7341_NIR, 0},
            {SENSOR_AS7341_FLICKER_FREQ, 0},
            {SENSOR_AS7341_FLICKER_P2P, 0}
        };

        int nextLowerGain(as7341_gain_t currentGain);
        bool getReadingAtGain(as7341_gain_t gain);

        bool started = false;
        bool getReadingOK = false;
        uint32_t lastReadSpectrum = 0;
        uint32_t lastReadFlicker = 0;
        Adafruit_AS7341 adafruit_as7341;

        uint16_t spectralReadings[SCK_AS7341_N_SPECTRAL_READINGS]{};
        uint16_t fifoSamples[SAMPLE_NUM]{};

        Sck_FFT<SAMPLE_NUM> sckFFT;
        int32_t flickerSource[SAMPLE_NUM]{};
        int32_t flickerSpectrum[FFT_NUM]{};

        // Day light scale correction factor (as seen in Spectral sensor calibration methods)
        // Scaled by 100
        const uint16_t dayLightScaleFactor[8] = {
            320, 300, 207, 130, 107, 93, 78, 71
        };
    };
#endif

void writeI2C(byte deviceAddress, byte instruction, byte data);
byte readI2C(byte deviceAddress, byte instruction);
