fablabbcn/smartcitizen-kit-2x/sam/src/SckBase.h

#pragma once

#include <Arduino.h>
#include <RTCZero.h>
#include <time.h>
#include <SPI.h>
#include "SAMD_pinmux_report.h"
#include "wiring_private.h"
#include <FlashStorage.h>
#include <ArduinoJson.h>
#include <LinkedList.h>

#include "SdFat.h"
#define DISABLE_CHIP_SELECT pinCS_FLASH

#include "Pins.h"
#include "SckLed.h"
#include "SckBatt.h"
#include "Config.h"
#include "Commands.h"
#include "Sensors.h"
#include "SckUrban.h"
#include "SckAux.h"
#include "SckList.h"
#include "SckSerial.h"
#include "SckWatchdog.h"

#include "version.h"

#define IM_SAM

#define SCK_BOOT_REPORT_TIMEOUT 30000  // ms, max time spent reporting reset cause on boot

class Status
    {

    private:
        uint32_t _lastTryMillis = 0; // ms
        uint32_t _timeout;  // ms

    public:
        bool ok = false;
        bool error = false;
        uint8_t retrys = 0;
        uint8_t _maxRetrys;

        bool retry();
        void setOk();
        void reset();

        Status(uint8_t maxRetrys=5, uint32_t timeout=1000)
        {
            _maxRetrys = maxRetrys;
            _timeout = timeout;
        }
    };

struct SckState
{
    bool onShell = false;
    bool onSetup = false;
    bool espON = false;
    bool espBooting = false;
    bool wifiSet = false;
    bool tokenSet = false;
    bool tokenError = false;
    bool helloPending = false;
    SCKmodes mode = MODE_NET;
    bool cardPresent = false;
    bool cardPresentErrorPrinted = false;
    bool sleeping = false;
    bool publishPending = false;
    bool dynamic = false;
    Status wifiStat = Status(1, 60000);
    Status timeStat = Status(2, 3000);
    Status helloStat = Status(3, 5000);
    Status infoStat = Status(3, 5000);
    Status publishStat = Status(3, 5000);
    errorType error = ERROR_NONE;
    uint32_t lastWiFiError = 0;
    uint16_t wifiErrorCounter = 0;

    inline bool operator==(SckState a) {
        if (    a.onSetup == onSetup
            && a.espON == espON
            && a.wifiSet == wifiSet
            && a.tokenSet == tokenSet
            && a.helloPending == helloPending
            && a.mode == mode
            && a.cardPresent == cardPresent
            && a.sleeping == sleeping
        ) return true;
        else return false;
    }
};

class SckBase
{
	private:
		// Input/Output
		String serialBuff;
		String previousCommand;
		uint8_t outRepetitions = 0;

		// **** ESP control
		uint32_t espStarted;

		// **** Time
		const uint8_t TIME_TIMEOUT = 20;		// seconds

		// **** Mode Control
		void reviewState();
		uint32_t reviewStateMillis = 0;
		void enterSetup();

		// ESP communication
		void ESPbusUpdate();
		void ESPmaintenance();
		void bootReport();
		bool sendConfig();
		uint32_t sendConfigTimer = 0;
		uint8_t sendConfigCounter = 0;
		uint32_t generalUpdateTimer = 0;

		// Button
		const uint16_t buttonLong = 5000;
		const uint16_t buttonVeryLong = 15000;
		bool butOldState = true;
		bool wakingUp = false;
		void buttonEvent();
		void buttonStillDown();

		// Configuration
		void loadConfig();
        bool createInfo(char* buffer, bool pretty=false);
		bool publishInfo();
		bool espInfoUpdated = false;
		bool infoPublished = false;
		bool wifiJustReconnected = false;

		// Sd card
		volatile bool sdInitPending = false;
		bool sdInit();
		bool saveInfo();
		bool infoSaved = false;

		// Power
		uint8_t wakeUP_H = 3;
		uint8_t wakeUP_M = 0;
		void updatePower();
		uint32_t updatePowerMillis = 0;
		void configGCLK6(); 			// Taken from https://github.com/arduino-libraries/ArduinoLowPower
		void sleepLoop();

		// **** Sensors
		uint32_t lastPublishTime = 0; 			// seconds
		uint32_t lastSensorUpdate = 0;
		bool timeToPublish = false;
		void urbanStart();
		void updateSensors();
        uint32_t lastRSSIUpdate = 0;
        bool getRSSI(OneSensor* wichSensor);
		bool netPublish();
		bool sdPublish(); 				//  Publishes the provided group of readings to sdcard (if available)
		LinkedList<SensorType> pendingSensorsLinkedList;

		SckList::GroupIndex whichGroupPublishing; 	// Index of the group beeing published (already sent to ESP and waiting for OK/ERROR response), -1 if there is none.
		uint32_t dynamicLast = 0; 			// Last time that we detected enough speed to trigger dynamic interval
		uint8_t dynamicCounter = 0;
		const uint8_t DYNAMIC_COUNTER_THRESHOLD = 3; 	// Number of high speed repetitions that triggers dynamic interval
		uint32_t lastSpeedMonitoring = 0; 		// Last time we check the speed to trigger dynamic interval
		const uint8_t DYNAMIC_TIMEOUT = 60; 		// When low speed is detected let this time (seconds) pass before changing dynamic interval off. (This helps with noise in speed data).
		const uint16_t DYNAMIC_HDOP_THRESHOLD = 350; 	// If HDOP is grater than this we ignore the reported speed (this help cleaning false high speed dynamic trigger's)
		const float SPEED_ALPHA = 2; 			// 0-10 - small values -> more smooth, big values -> closer to original data.
		void updateDynamic(uint32_t now);

	public:
#if defined(SCK21_AIR)
		const String hardwareVer = "2.1";
#elif defined(SCK22_AIR)
		const String hardwareVer = "2.2";
#elif defined(SCK23_AIR)
		const String hardwareVer = "2.3";
#else
		// TODO At some point this will need to change.
		const String hardwareVer = "2.1";
#endif
		const String SAMversion	= SAMverNum + "-" + String(__GIT_HASH__) + "-" + String(__GIT_BRANCH__) + "-" + String(__PIO_ENV__); 		   // mayor.minor.build-gitcommit-branch-platformioenv
		const String SAMbuildDate = String(__ISO_DATE__);
		String ESPversion = "not synced";
		String ESPbuildDate = "not synced";
		// If mayor or minor version of ESP is different than SAM's we need to call a ESP update
		bool ESPupdateNeeded = false;

		void setup();
		void update();

		// **** Mode Control
		SckState st;

		// **** Time
		RTCZero rtc;
		bool timeSyncAfterBoot = false;
		uint32_t lastTimeSync = 0;
		char ISOtimeBuff[20];
		bool setTime(String epoch);
		bool ISOtime();
		void epoch2iso(uint32_t toConvert, char* isoTime);

		// Peripherals
		SckLed led;
		friend class SckButton;

		// **** Sensors
		AllSensors sensors;
		bool getReading(OneSensor *wichSensor);
		void controlSensor(SensorType wichSensorType, String wwhichommand);
		bool enableSensor(SensorType wichSensor);
		bool disableSensor(SensorType wichSensor);
		bool writeHeader = false;

		// Urban board
		bool urbanPresent = false;
		friend class urban;
		SckUrban urban = SckUrban(&rtc);

		// Flash readings store
		friend class SckList;
		SckList readingsList = SckList(this);

		// Configuration
		Configuration config;
		Configuration getConfig();
		void saveConfig(bool defaults=false);

		// Input/Output
		void inputUpdate();

		// ESP control
		enum ESPcontrols { ESP_OFF, ESP_FLASH, ESP_ON, ESP_REBOOT, ESP_SLEEP, ESP_WAKEUP };
		void ESPcontrol(ESPcontrols myESPControl);
		uint32_t espFlashSpeed = 115200;

		// ESP communication
		bool ESPsend(SCKMessage whichMessage);
		bool ESPsend(SCKMessage whichMessage, const char *content);
		bool pendingSyncConfig = false;
		String ipAddress;
		char hostname[17];
		void mqttCustom(const char *topic, const char *payload);
		char* serESPBuffPtr;

		// Output
		const char *outLevelTitles[OUT_COUNT] PROGMEM = { "Silent", "Normal", "Verbose"	};
		char outBuff[NETBUFF_SIZE];
		void sckOut(const char *strOut, PrioLevels priority=PRIO_MED, bool newLine=true);	// Accepts constant string
		void sckOut(PrioLevels priority=PRIO_MED, bool newLine=true);
		void prompt();
#ifdef SCK_WITH_SENSOR_GROVE_OLED
		void plot(String value, const char *title=NULL, const char *unit=NULL);
#endif

		// Button
		volatile bool butState = true;
		volatile uint32_t lastUserEvent = 0;
		void butFeedback();

		// Commands
		AllCommands commands;

		// Sd card Storage
        FsFile sckFile;   // FAT16/FAT32 and exFAT support. For only FAT16/32 use "File32 sckFile;" (saves some flash). Also remember to change SdFs
        #define SD_CONFIG_NAME  "CONFIG.TXT"
        #define SD_DEBUG_NAME   "DEBUG.TXT"
        #define SD_SPEED_NAME   "SPEED.TXT"
        #define SD_INFO_NAME    "INFO.TXT"
        #define SD_ERROR_NAME   "ERROR.TXT"
        #define SD_MONITOR_NAME "MONITOR.TXT"
        SdFs sd;            // FAT16/FAT32 and exFAT support. For only FAT16/32 use "SdFat32 sd;" (saves some flash)
		bool sdDetect();
        enum fileCom { FILECOM_LS, FILECOM_RM, FILECOM_LESS, FILECOM_ALLCSV };
        void fileManager(fileCom command, const char* name);
        uint16_t headerChkSum(char* fileName);
        uint16_t headerChkSum(FsFile* thisFile);
        uint16_t RAMheaderChkSum();
        void saveHeader(FsFile* thisFile);



		// Power
		void sck_reset();
		void printLastHang();
		void goToSleep(uint32_t sleepPeriod=3000); 	// sleepPeriod in ms
		SckBatt battery;
		SckCharger charger;
		bool sckOFF = false;

		// Misc
		void getUniqueID();
		uint32_t uniqueID[4];
		char uniqueID_str[33];

		const char *modeTitles[MODE_COUNT] PROGMEM = {
			"not configured",		// modeTitles[MODE_NOT_CONFIGURED]
			"network",				// modeTitles[MODE_NET]
			"sdcard",				// modeTitles[MODE_SD]
			"sleep"					// modeTitles[MODE_SLEEP]
		};

#ifdef SC_TESTING
        const bool inTest = true;
        friend class SckTest;
#else
        const bool inTest = false;
#endif
    };

bool I2Cdetect(TwoWire *_Wire, byte address);
void ISR_button();
void ISR_sdDetect();
void ext_reset();
