fablabbcn/smartcitizen-kit-2x/sam/src/Commands.cpp

#include "Commands.h"
#include "SckBase.h"

extern SckSerial serESP;

void AllCommands::in(SckBase* base, String strIn)
{

    if (strIn.length() <= 0) return;
    if (strIn.startsWith("zz")) {
        strIn.replace("zz", "");
        strIn.trim();
        wildCard(base, strIn);
        return;
    }

    CommandType reqComm = COM_COUNT;

    // Search in the command list
    for (uint8_t i=0; i < COM_COUNT; ++i) {

        CommandType thisType = static_cast<CommandType>(i);

        OneCom *thisCommand = &com_list[thisType];

        if (strIn.startsWith(thisCommand->title)) {
            reqComm = thisType;
            strIn.replace(thisCommand->title, "");
            strIn.trim();
            break;
        }
    }

    if (reqComm < COM_COUNT) com_list[reqComm].function(base, strIn);
    else base->sckOut("Unrecognized command!!");
}
void AllCommands::wildCard(SckBase* base, String strIn)
{

    shell_com(base, "-on");
    base->ESPcontrol(base->ESP_OFF);
}

void reset_com(SckBase* base, String parameters)
{

    base->sck_reset();
}
void getVersion_com(SckBase* base, String parameters)
{
    base->getUniqueID();
    sprintf(base->outBuff, "Hardware Version: %s\r\nSAM Hardware ID: %s\r\nSAM version: %s\r\nSAM build date: %s", base->hardwareVer.c_str(), base->uniqueID_str, base->SAMversion.c_str(), base->SAMbuildDate.c_str());
    base->sckOut();
    sprintf(base->outBuff, "ESP version: %s\r\nESP build date: %s", base->ESPversion.c_str(), base->ESPbuildDate.c_str());
    base->sckOut();
}
void resetCause_com(SckBase* base, String parameters)
{

    uint8_t resetCause = PM->RCAUSE.reg;

    switch(resetCause){
        case 1:
            base->sckOut("POR: Power On Reset");
            break;
        case 2:
            base->sckOut("BOD12: Brown Out 12 Detector Reset");
            break;
        case 4:
            base->sckOut("BOD33: Brown Out 33 Detector Reset");
            break;
        case 16:
            base->sckOut("EXT: External Reset");
            break;
        case 32:
            base->sckOut("WDT: Watchdog Reset");
            break;
        case 64:
            base->sckOut("SYST: System Reset Request");
            break;
    }
}
void outlevel_com(SckBase* base, String parameters)
{

    // get
    if (parameters.length() <= 0) {

        sprintf(base->outBuff, "Current output level: %s", base->outLevelTitles[base->config.outLevel]);
        base->sckOut();

        // set
    } else {

        uint8_t newLevel = parameters.toInt();

        // Parameter sanity check
        if (newLevel >= 0 && newLevel < OUT_COUNT) {
            OutLevels thisLevel = static_cast<OutLevels>(newLevel);
            base->config.outLevel = thisLevel;
            sprintf(base->outBuff, "New output level: %s", base->outLevelTitles[newLevel]);
            base->sckOut();
            base->saveConfig();
        } else {
            base->sckOut("unrecognized output level!!");
            return;
        }
    }
}
void help_com(SckBase* base, String parameters)
{

    // TODO manage multiline help. Maybe a simple general help and a per command help: "help config"
    base->sckOut();
    for (uint8_t i=0; i < COM_COUNT; ++i) {

        CommandType thisType = static_cast<CommandType>(i);
        OneCom *thisCommand = &base->commands[thisType];

        String sep = "            ";
        sep.remove(sep.length() -String(thisCommand->title).length());

        sprintf(base->outBuff, "%s:%s%s", thisCommand->title, sep.c_str(), thisCommand->help);
        base->sckOut();
    }
}
void pinmux_com(SckBase* base, String parameters)
{

    for (uint8_t pin=0; pin<PINS_COUNT; pin++) {  // For all defined pins
        pinmux_report(pin, base->outBuff, 0);
        base->sckOut();
    }
}
void sensorConfig_com(SckBase* base, String parameters)
{
    // Get
    if (parameters.length() <= 0) {

        SensorType thisType = SENSOR_COUNT;

        sprintf(base->outBuff, "\r\nDisabled\r\n----------");
        base->sckOut();
        for (uint16_t i=0; i<SENSOR_COUNT; i++) {

            thisType = base->sensors.sensorsPriorized(i);

            if (!base->sensors[thisType].enabled) base->sckOut(base->sensors[thisType].title);
        }

        sprintf(base->outBuff, "\r\nEnabled\r\n----------");
        base->sckOut();
        // Get sensor type
        for (uint16_t i=0; i<SENSOR_COUNT; i++) {

            thisType = base->sensors.sensorsPriorized(i);
            if (base->sensors[thisType].enabled) {

                snprintf(base->outBuff, sizeof(base->outBuff), "%s -> every %i int (%lu sec)", base->sensors[thisType].title, base->sensors[thisType].everyNint, (base->sensors[thisType].everyNint * base->config.readInterval));
                base->sckOut(PRIO_MED, false);

#ifdef SCK_WITH_SENSOR_GROVE_OLED
                if (base->sensors[SENSOR_GROVE_OLED].enabled && base->config.sensors[thisType].oled_display)  base->sckOut(" - oled");
                else base->sckOut(" ");
#else
                base->sckOut(" ");
#endif
            }
        }

    } else {

        int16_t sensorEndIndex = parameters.indexOf("-") - 1;
        SensorType sensorToChange = base->sensors.getTypeFromText(parameters.substring(0, sensorEndIndex).c_str());
        bool saveNeeded = false;

#ifdef SCK_WITH_URBAN
#ifdef SCK_WITH_PMS
        // PM and PN sensors are grouped to make changes to the full group
        SensorType urban_pm[] = { SENSOR_PMS_PM_1, SENSOR_PMS_PM_25, SENSOR_PMS_PM_10 };
        SensorType urban_pn[] = { SENSOR_PMS_PN_03, SENSOR_PMS_PN_05, SENSOR_PMS_PN_1, SENSOR_PMS_PN_25, SENSOR_PMS_PN_5, SENSOR_PMS_PN_10 };
        SensorType ext_pm[] = { SENSOR_EXT_A_PM_1, SENSOR_EXT_A_PM_25, SENSOR_EXT_A_PM_10, SENSOR_EXT_B_PM_1, SENSOR_EXT_B_PM_25, SENSOR_EXT_B_PM_10 };
        SensorType ext_pn[] = { SENSOR_EXT_A_PN_03, SENSOR_EXT_A_PN_05, SENSOR_EXT_A_PN_1, SENSOR_EXT_A_PN_25, SENSOR_EXT_A_PN_5, SENSOR_EXT_A_PN_10, SENSOR_EXT_B_PN_03, SENSOR_EXT_B_PN_05, SENSOR_EXT_B_PN_1, SENSOR_EXT_B_PN_25, SENSOR_EXT_B_PN_5, SENSOR_EXT_B_PN_10 };
        SensorType *pm_sensors[] = { urban_pm, urban_pn, ext_pm, ext_pn };
        uint8_t group_size[] = { 3, 6, 6, 12 };

        // Find out if sensor belongs to a PM group
        SensorType *groupToChange = NULL;
        uint8_t groupToChange_size = 0;
        for (uint8_t i=0; i<4; i++) {
            for(uint8_t ii=0; ii<group_size[i]; ii++) {
                if(pm_sensors[i][ii] == sensorToChange) {
                    groupToChange = pm_sensors[i];
                    groupToChange_size = group_size[i];
                }
            }
        }
#endif
#ifdef SCK_WITH_SEN5X
        // SEN5X sensors are grouped in sen5x_pm, sen5x_pn, sen5x_th, sen5x_voc and sen5x_nox
        SensorType sen5x_pm[] = { SENSOR_SEN5X_PM_1, SENSOR_SEN5X_PM_25, SENSOR_SEN5X_PM_4, SENSOR_SEN5X_PM_10};
        SensorType sen5x_pn[] = { SENSOR_SEN5X_PN_05, SENSOR_SEN5X_PN_1, SENSOR_SEN5X_PN_25, SENSOR_SEN5X_PN_4, SENSOR_SEN5X_PN_10, SENSOR_SEN5X_TPSIZE };
        SensorType sen5x_th[] = { SENSOR_SEN5X_TEMPERATURE, SENSOR_SEN5X_HUMIDITY, SENSOR_SEN5X_TEMPERATURE_RAW, SENSOR_SEN5X_HUMIDITY_RAW };
        SensorType sen5x_voc[] = { SENSOR_SEN5X_VOCS_IDX, SENSOR_SEN5X_VOCS_RAW };
        SensorType sen5x_nox[] = { SENSOR_SEN5X_NOX_IDX, SENSOR_SEN5X_NOX_RAW };
        SensorType *sen5x_sensors[] = { sen5x_pm, sen5x_pn, sen5x_th, sen5x_voc, sen5x_nox };
        uint8_t senGroup_size[] = { 4, 6, 4, 2, 2 };

        // Find out if sensor belongs to a SEN5X group
        SensorType *senGroupToChange = NULL;
        uint8_t senGroupToChange_size = 0;
        for (uint8_t i=0; i<5; i++) {
            for(uint8_t ii=0; ii<senGroup_size[i]; ii++) {
                if(sen5x_sensors[i][ii] == sensorToChange) {
                    senGroupToChange = sen5x_sensors[i];
                    senGroupToChange_size = senGroup_size[i];
                }
            }
        }
#endif
#endif

        if (sensorToChange == SENSOR_COUNT) {
            base->sckOut("ERROR sensor not found");
            return;
        }

        if (parameters.indexOf("-enable") >=0) {

            if (base->enableSensor(sensorToChange)) {

                // Enable sensor also in config to make changes persistent
                base->config.sensors[sensorToChange].enabled = true;

#ifdef SCK_WITH_URBAN
#ifdef SCK_WITH_PMS
                // Just for PM/PN enable the rest of sensors in the same group
                for (uint8_t i=0; i<groupToChange_size; i++) {

                    // Avoid enabling same sensor twice
                    if (sensorToChange == groupToChange[i]) continue;

                    // Enable them in runtime
                    base->sensors[groupToChange[i]].enabled = true;

                    // Enable them also in config to make changes persistent
                    base->config.sensors[groupToChange[i]].enabled = true;

                    sprintf(base->outBuff, "Enabling %s", base->sensors[groupToChange[i]].title);
                    base->sckOut();
                }
#endif
#ifdef SCK_WITH_SEN5X
                // SEN5X enable the rest of sensors in corresponding group
                for (uint8_t i=0; i<senGroupToChange_size; i++) {

                    // Avoid enabling same sensor twice
                    if (sensorToChange == senGroupToChange[i]) continue;

                    // Enable them in runtime
                    base->sensors[senGroupToChange[i]].enabled = true;

                    // Enable them also in config to make changes persistent
                    base->config.sensors[senGroupToChange[i]].enabled = true;

                    sprintf(base->outBuff, "Enabling %s", base->sensors[senGroupToChange[i]].title);
                    base->sckOut();
                }
#endif
#endif
                saveNeeded = true;
            } else {
                sprintf(base->outBuff, "Failed enabling %s", base->sensors[sensorToChange].title);
#ifdef SCK_WITH_URBAN
#ifdef SCK_WITH_PMS
#ifdef SCK_WITH_SEN5X
                if (groupToChange > 0 || senGroupToChange > 0) sprintf(base->outBuff, "%s and its sensor group", base->outBuff);
#endif
#endif
#endif
                base->sckOut();
            }

        } else if (parameters.indexOf("-disable") >=0) {

            base->disableSensor(sensorToChange);

            // Disable sensor also in config to make changes persistent
            base->config.sensors[sensorToChange].enabled = false;

#ifdef SCK_WITH_URBAN
#ifdef SCK_WITH_PMS
            // Just for PM/PN disable the rest of sensors in the same group
            for (uint8_t i=1; i<groupToChange_size; i++) {

                // Avoid enabling same sensor twice
                if (sensorToChange == groupToChange[i]) continue;

                // Disable them in runtime
                base->sensors[groupToChange[i]].enabled = false;

                // Disable them also in config to make changes persistent
                base->config.sensors[groupToChange[i]].enabled = false;

                sprintf(base->outBuff, "Disabling %s", base->sensors[groupToChange[i]].title);
                base->sckOut();
            }
#endif
#ifdef SCK_WITH_SEN5X
            // SEN5X enable the rest of sensors in corresponding group
            for (uint8_t i=1; i<senGroupToChange_size; i++) {

                // Avoid enabling same sensor twice
                if (sensorToChange == senGroupToChange[i]) continue;

                // Enable them in runtime
                base->sensors[senGroupToChange[i]].enabled = false;

                // Enable them also in config to make changes persistent
                base->config.sensors[senGroupToChange[i]].enabled = false;

                sprintf(base->outBuff, "Disabling %s", base->sensors[senGroupToChange[i]].title);
                base->sckOut();
            }
#endif
#endif
            saveNeeded = true;
        }

#ifdef SCK_WITH_SENSOR_GROVE_OLED
        if (parameters.indexOf("-oled") >=0) {

            base->config.sensors[sensorToChange].oled_display = !base->config.sensors[sensorToChange].oled_display;
            base->sensors[sensorToChange].oled_display = base->config.sensors[sensorToChange].oled_display;

            snprintf(base->outBuff, sizeof(base->outBuff), "%s will %s on oled display", base->sensors[sensorToChange].title, base->config.sensors[sensorToChange].oled_display ? "be displayed" : "not show");
            base->sckOut();

            saveNeeded = true;

        }
#endif
        if (parameters.indexOf("-interval") >=0) {

            // Get the number of seconds user asked for as new interval
            int16_t intervalIndex = parameters.indexOf("-interval") + 10;
            String strInterval = parameters.substring(intervalIndex);
            uint32_t intervalInt = strInterval.toInt();

            // Calculate how many general intervals between sensor readings
            uint8_t newEveryNint = intervalInt / base->config.readInterval;
            if (newEveryNint < 1) newEveryNint = 1;

            snprintf(base->outBuff, sizeof(base->outBuff), "The sensor read interval is calculated as a multiple of general read interval (%u)", base->config.readInterval);
            base->sckOut();
            if (newEveryNint < 255) {

                bool alreadyPrinted = false;
#ifdef SCK_WITH_URBAN
#ifdef SCK_WITH_PMS
                if (groupToChange_size > 0) {
                    // Just for PM/PN change all the sensors in the same group
                    for (uint8_t i=0; i<groupToChange_size; i++) {
                        base->sensors[groupToChange[i]].everyNint = newEveryNint;
                        base->config.sensors[groupToChange[i]].everyNint = newEveryNint;
                        sprintf(base->outBuff, "Changing interval of %s to %lu", base->sensors[groupToChange[i]].title, base->sensors[groupToChange[i]].everyNint * base->config.readInterval);
                        base->sckOut();
                    }
                    alreadyPrinted = true;
                }
#endif
#ifdef SCK_WITH_SEN5X // In the future this (and enable/disable groups) should be managed inside the sensor object
                if (senGroupToChange_size > 0 && !alreadyPrinted) {
                    // Just for SEN5X change all the sensors in the same group
                    for (uint8_t i=0; i<senGroupToChange_size; i++) {
                        base->sensors[senGroupToChange[i]].everyNint = newEveryNint;
                        base->config.sensors[senGroupToChange[i]].everyNint = newEveryNint;
                        sprintf(base->outBuff, "Changing interval of %s to %lu", base->sensors[senGroupToChange[i]].title, base->sensors[senGroupToChange[i]].everyNint * base->config.readInterval);
                        base->sckOut();
                    }
                    alreadyPrinted = true;
                }

                // If smallest interval is less than warmUp period we will force continous mode on SEN5X
                // Still one Issue exists: if the general readInterval is changed (via the config command) and the new calculatedInterval results small, we don't notice it because this code is not executed. For now the workaround is to change first the general readInt and then the individual sensor interval. Makes more sense to do it this way.
                int totalWarmUpPeriod = base->urban.sck_sen5x.warmUpPeriod[0] + base->urban.sck_sen5x.warmUpPeriod[1];
                bool smallIntervalExists = false;

                // Check all the sensors for a small interval
                for (uint8_t i=0; i<5; i++) {
                    for(uint8_t ii=0; ii<senGroup_size[i]; ii++) {
                        int calculatedInterval = base->sensors[sen5x_sensors[i][ii]].everyNint * base->config.readInterval;
                        if (calculatedInterval < totalWarmUpPeriod) smallIntervalExists = base->urban.sck_sen5x.forcedContinousMode = true;
                    }
                }
                if (!smallIntervalExists) base->urban.sck_sen5x.forcedContinousMode = false;


#endif
#endif
                if (!alreadyPrinted) {
                    base->sensors[sensorToChange].everyNint = newEveryNint;
                    base->config.sensors[sensorToChange].everyNint = newEveryNint;
                    sprintf(base->outBuff, "Changing interval of %s to %lu", base->sensors[sensorToChange].title, base->sensors[sensorToChange].everyNint * base->config.readInterval);
                    base->sckOut();
                }

                saveNeeded = true;
            } else {
                base->sckOut("Wrong new interval!!!");
            }
        }
        if (saveNeeded) base->saveConfig();
    }
}
void readSensor_com(SckBase* base, String parameters)
{
    SensorType whichType = base->sensors.getTypeFromText(parameters.c_str());
    OneSensor sensorToRead = base->sensors[whichType];

    if (!sensorToRead.enabled) {
        sprintf(base->outBuff, "%s sensor is disabled!!!", sensorToRead.title);
        base->sckOut();
        return;
    } else base->getReading(&sensorToRead);

    if (sensorToRead.state == 0) sprintf(base->outBuff, "%s: %s %s", sensorToRead.title, sensorToRead.reading.c_str(), sensorToRead.unit);
    else if (sensorToRead.state == -1) sprintf(base->outBuff, "ERROR reading %s sensor!!!", sensorToRead.title);
    else sprintf(base->outBuff, "Your reading will be ready in %i seconds try again!!", sensorToRead.state);
    base->sckOut();
}
void controlSensor_com(SckBase* base, String parameters)
{
    SensorType wichSensor = base->sensors.getTypeFromText(parameters.c_str());

    if (parameters.length() < 1) {
        base->sckOut("ERROR No command received!! please try again...");
        return;
    } else if (wichSensor == SENSOR_COUNT) {
        base->sckOut("ERROR Sensor not found!!!");
        return;
    } else {
        uint8_t paramIndexStart = base->sensors.sensorNameEndsIn(parameters.c_str());
        base->controlSensor(wichSensor, parameters.substring(paramIndexStart));
    }
}
void monitorSensor_com(SckBase* base, String parameters)
{
    SensorType sensorsToMonitor[SENSOR_COUNT];
    uint8_t index = 0;
    bool sdSave = false;
    bool printTime = true;
    bool printMs = true;
    bool oled = false;

    if (parameters.indexOf("-sd") >=0) {
        sdSave = true;
        parameters.replace("-sd", "");
        parameters.trim();
        if (!base->st.cardPresent) {
            base->sckOut("ERROR No sd card found!!!");
            return;
        }
        base->sckFile.open(SD_MONITOR_NAME, FILE_WRITE);
    }
    if (parameters.indexOf("-notime") >=0) {
        printTime = false;
        parameters.replace("-notime", "");
        parameters.trim();
    }
    if (parameters.indexOf("-noms") >=0) {
        printMs = false;
        parameters.replace("-noms", "");
        parameters.trim();
    }
    if (parameters.indexOf("-oled") >=0) {
        oled = true;
        parameters.replace("-oled", "");
        parameters.trim();
    }
    if (parameters.length() > 0) {
        while (parameters.length() > 0) {

            int16_t sep = parameters.indexOf(",");
            String thisSensor;

            if (sep <= 0) {
                thisSensor = parameters;
                parameters.remove(0, parameters.length());
            } else {
                thisSensor = parameters.substring(0, sep);
                parameters.remove(0, sep+1);
                parameters.trim();
            }

            SensorType thisSensorType = base->sensors.getTypeFromText(thisSensor.c_str());

            if (base->sensors[thisSensorType].enabled) {
                sensorsToMonitor[index] = thisSensorType;
                index ++;
            } else {
                sprintf(base->outBuff, "%s is disabled, enable it first!!!", base->sensors[thisSensorType].title);
                base->sckOut();
                return;
            }
        }
    } else {
        for (uint16_t i=0; i<SENSOR_COUNT; i++) {
            if (base->sensors[static_cast<SensorType>(i)].enabled) {
                sensorsToMonitor[index] = static_cast<SensorType>(i);
                index++;
            }
        }

    }

    // Titles
    strncpy(base->outBuff, "", 240);
    if (printTime) sprintf(base->outBuff, "%s\t", "Time");
    if (printMs) snprintf(base->outBuff, sizeof(base->outBuff) - strlen(base->outBuff), "%s%s\t", base->outBuff, "Miliseconds");
    for (uint8_t i=0; i<index; i++) {
        sprintf(base->outBuff, "%s%s", base->outBuff, base->sensors[sensorsToMonitor[i]].title);
        if (i < index - 1) snprintf(base->outBuff, sizeof(base->outBuff) - strlen(base->outBuff), "%s\t", base->outBuff);
#ifdef SCK_WITH_SENSOR_GROVE_OLED
        if (oled && i==0) base->plot(base->sensors[sensorsToMonitor[i]].reading, base->sensors[sensorsToMonitor[i]].title, base->sensors[sensorsToMonitor[i]].unit);
#endif
    }
    if (sdSave) base->sckFile.println(base->outBuff);
    base->sckOut();

    // Readings
    uint32_t lastMillis = millis();
    while (!SerialUSB.available()) {

        uint32_t provLastMillis = millis();
        bool PMreadingReady = false;
        uint8_t printit = 0;

        sprintf(base->outBuff, "%s", "");

        if (printTime) {
            base->ISOtime();
            snprintf(base->outBuff, sizeof(base->outBuff) - strlen(base->outBuff), "%s%s\t", base->outBuff, base->ISOtimeBuff);
        }

        if (printMs) {
            snprintf(base->outBuff, sizeof(base->outBuff) - strlen(base->outBuff), "%s%lu\t", base->outBuff, millis() - lastMillis);
            lastMillis = millis();
        }

        bool theFirst = true;

        for (uint8_t i=0; i<index; i++) {

            OneSensor wichSensor = base->sensors[sensorsToMonitor[i]];

#ifdef SCK_WITH_URBAN
#ifdef SCK_WITH_PMS
            // PM sensor needs to be notified that we are in monitor mode
            if (wichSensor.type == SENSOR_PMS_PM_1 || wichSensor.type == SENSOR_PMS_PM_10 || wichSensor.type == SENSOR_PMS_PM_25) base->urban.sck_pms.monitor = true;
#endif
#ifdef SCK_WITH_SEN5X
            // SEN sensor needs to be notified that we are in monitor mode
            if (wichSensor.type == SENSOR_SEN5X_PM_1            ||
                wichSensor.type == SENSOR_SEN5X_PM_25           ||
                wichSensor.type == SENSOR_SEN5X_PM_4            ||
                wichSensor.type == SENSOR_SEN5X_PM_10           ||
                wichSensor.type == SENSOR_SEN5X_PN_05           ||
                wichSensor.type == SENSOR_SEN5X_PN_1            ||
                wichSensor.type == SENSOR_SEN5X_PN_25           ||
                wichSensor.type == SENSOR_SEN5X_PN_4            ||
                wichSensor.type == SENSOR_SEN5X_PN_10           ||
                wichSensor.type == SENSOR_SEN5X_TPSIZE          ||
                wichSensor.type == SENSOR_SEN5X_HUMIDITY        ||
                wichSensor.type == SENSOR_SEN5X_TEMPERATURE     ||
                wichSensor.type == SENSOR_SEN5X_VOCS_IDX        ||
                wichSensor.type == SENSOR_SEN5X_NOX_IDX         ||
                wichSensor.type == SENSOR_SEN5X_HUMIDITY_RAW    ||
                wichSensor.type == SENSOR_SEN5X_TEMPERATURE_RAW ||
                wichSensor.type == SENSOR_SEN5X_VOCS_RAW        ||
                wichSensor.type == SENSOR_SEN5X_NOX_RAW)  {
                base->urban.sck_sen5x.monitor = true;
            }
#endif
#ifdef SCK_WITH_SPS30
            if (wichSensor.type == SENSOR_SPS30_PM_1  ||
                wichSensor.type == SENSOR_SPS30_PM_25 ||
                wichSensor.type == SENSOR_SPS30_PM_4  ||
                wichSensor.type == SENSOR_SPS30_PM_10 ||
                wichSensor.type == SENSOR_SPS30_PN_05 ||
                wichSensor.type == SENSOR_SPS30_PN_1  ||
                wichSensor.type == SENSOR_SPS30_PN_25 ||
                wichSensor.type == SENSOR_SPS30_PN_4  ||
                wichSensor.type == SENSOR_SPS30_PN_10 ||
                wichSensor.type == SENSOR_SPS30_TPSIZE) base->urban.sck_sps30.monitor = true;
#endif
#endif

            base->getReading(&wichSensor);

            if (wichSensor.state == 0) {
                snprintf(base->outBuff, sizeof(base->outBuff) - strlen(base->outBuff), "%s\t%s", base->outBuff, wichSensor.reading.c_str());

#ifdef SCK_WITH_SENSOR_GROVE_OLED
                if (theFirst && oled) {
                    base->plot(wichSensor.reading);
                    theFirst = false;
                }
#endif
                printit++;

            } else snprintf(base->outBuff, sizeof(base->outBuff) - strlen(base->outBuff), "%s%s", base->outBuff, "none");
        }

        // If we are missing sensors we don't print the output
        if (printit == index) {
            lastMillis = provLastMillis;
            if (sdSave) base->sckFile.println(base->outBuff);
            base->sckOut();
        }
    }

    // post monitor tasks
    for (uint8_t i=0; i<index; i++) {

        OneSensor wichSensor = base->sensors[sensorsToMonitor[i]];

#ifdef SCK_WITH_URBAN
#ifdef SCK_WITH_PMS
        // PM sensor needs to be notified that we are not in monitor mode anymore
        if (wichSensor.type == SENSOR_PMS_PM_1 || wichSensor.type == SENSOR_PMS_PM_10 || wichSensor.type == SENSOR_PMS_PM_25) base->urban.sck_pms.monitor = false;
#endif
#ifdef SCK_WITH_SEN5X
            // SEN sensor needs to be notified that we are in monitor mode
            if (wichSensor.type == SENSOR_SEN5X_PM_1            ||
                wichSensor.type == SENSOR_SEN5X_PM_25           ||
                wichSensor.type == SENSOR_SEN5X_PM_4            ||
                wichSensor.type == SENSOR_SEN5X_PM_10           ||
                wichSensor.type == SENSOR_SEN5X_PN_05           ||
                wichSensor.type == SENSOR_SEN5X_PN_1            ||
                wichSensor.type == SENSOR_SEN5X_PN_25           ||
                wichSensor.type == SENSOR_SEN5X_PN_4            ||
                wichSensor.type == SENSOR_SEN5X_PN_10           ||
                wichSensor.type == SENSOR_SEN5X_TPSIZE          ||
                wichSensor.type == SENSOR_SEN5X_HUMIDITY        ||
                wichSensor.type == SENSOR_SEN5X_TEMPERATURE     ||
                wichSensor.type == SENSOR_SEN5X_VOCS_IDX        ||
                wichSensor.type == SENSOR_SEN5X_NOX_IDX         ||
                wichSensor.type == SENSOR_SEN5X_HUMIDITY_RAW    ||
                wichSensor.type == SENSOR_SEN5X_TEMPERATURE_RAW ||
                wichSensor.type == SENSOR_SEN5X_VOCS_RAW        ||
                wichSensor.type == SENSOR_SEN5X_NOX_RAW) base->urban.sck_sen5x.monitor = false;
#endif
#ifdef SCK_WITH_SPS30
        if (wichSensor.type == SENSOR_SPS30_PM_1  ||
            wichSensor.type == SENSOR_SPS30_PM_25 ||
            wichSensor.type == SENSOR_SPS30_PM_4  ||
            wichSensor.type == SENSOR_SPS30_PM_10 ||
            wichSensor.type == SENSOR_SPS30_PN_05 ||
            wichSensor.type == SENSOR_SPS30_PN_1  ||
            wichSensor.type == SENSOR_SPS30_PN_25 ||
            wichSensor.type == SENSOR_SPS30_PN_4  ||
            wichSensor.type == SENSOR_SPS30_PN_10 ||
            wichSensor.type == SENSOR_SPS30_TPSIZE) base->urban.sck_sps30.sleep();
#endif
#endif
    }

    if (sdSave) base->sckFile.close();
}
void flash_com(SckBase* base, String parameters)
{
    if (parameters.length() <= 0) {

        base->sckOut("Scanning Flash memory (it can take a while!)");
        SckList::FlashInfo info;
        base->readingsList.flashInfo(&info);
        sprintf(base->outBuff, "\r\n%u sectors in total, %u used and %u free.", SCKLIST_SECTOR_NUM, info.sectUsed, info.sectFree);
        base->sckOut();
        sprintf(base->outBuff, "%lu groups in total.\r\nNetwork: %lu pending to publish.\r\nSd-card: %lu pending to publish.", info.grpTotal, info.grpUnPubNet, info.grpUnPubSd);
        base->sckOut();
        sprintf(base->outBuff, "Using sector number: %u\r\n", info.currSector);
        base->sckOut();

    } else {
        // Format: flash -format
        if (parameters.indexOf("-format") >=0) {

            base->readingsList.flashFormat();
            return;
        }

        // Recover readings: flash -recover sector-num/all sd/net
        // 'all' will do sector by sector until the endo of the memory
        // sd/net save the recovered readings to sd or publish them to the network
        int16_t recoI = parameters.indexOf("-recover");
        if (recoI >= 0) {


            // Enter shell mode to avoid interferences
            bool alreadyOnShell = base->st.onShell;
            if (!alreadyOnShell) {
                base->st.onShell = true;
                base->st.onSetup = false;
                base->led.update(base->led.YELLOW, base->led.PULSE_STATIC);
            }

            String sectC = parameters.substring(recoI+9);

            // Get sector number or all
            uint16_t sectV;
            bool all = false;
            if (sectC.startsWith("all")) all = true;
            else {
                sectV = sectC.toInt();
                if (sectV < 0 || sectV > SCKLIST_SECTOR_NUM) {
                    base->sckOut("Wrong sector number (0-2048)");
                    return;
                }
            }

            // Get flag
            uint8_t spaceI = sectC.indexOf(" ");
            String flagC = sectC.substring(spaceI+1);
            SckList::PubFlags thisFlag = SckList::PUB_SD;
            if (flagC.startsWith("net")) thisFlag = SckList::PUB_NET;

            // Save or publish groups
            uint32_t totalRecovered = 0;
            if (all) {
                for (uint16_t i=0; i<SCKLIST_SECTOR_NUM; i++)  {
                    totalRecovered += base->readingsList.recover(i, thisFlag);
                }
            } else totalRecovered = base->readingsList.recover(sectV, thisFlag);
            sprintf(base->outBuff, "Recovered %lu groups.", totalRecovered);
            base->sckOut();

            // Exit shell mode
            if (!alreadyOnShell) base->st.onShell = false;
            base->sckOut("Please reset your SCK to return to normal behaviour");
        }

        // Sector dump: flash -dump sector-num
        int16_t dumpI = parameters.indexOf("-dump");
        if (dumpI >= 0) {
            String dumpC = parameters.substring(dumpI+6);
            uint16_t dumpV = dumpC.toInt();
            if (dumpV < 0 || dumpV > SCKLIST_SECTOR_NUM) {
                base->sckOut("Wrong sector number (0-2048)");
                return;
            }
            base->readingsList.dumpSector(dumpV);
        }

        // Sector info: flash -sector sector-num/all
        int16_t sectI = parameters.indexOf("-sector");
        if (sectI >= 0) {
            String sectC = parameters.substring(sectI+8);

            // Info for one specified sector
            uint16_t sectV = sectC.toInt();
            if (sectV < 0 || sectV >= SCKLIST_SECTOR_NUM) {
                sprintf(base->outBuff, "Wrong sector number (0-%u)", SCKLIST_SECTOR_NUM);
                base->sckOut();
                return;
            }
            SckList::SectorInfo info = base->readingsList.sectorInfo(sectV);
            sprintf(base->outBuff, "\r\nSector %u in address %lu is: %s", sectV, info.addr, info.used ? "Used" : (info.current ? "In use" : "Free"));
            base->sckOut();
            sprintf(base->outBuff, "Sector %u fully published to network: %s", sectV, info.pubNet ? "true" : "false" );
            base->sckOut();
            sprintf(base->outBuff, "Sector %u fully published to sd-card: %s", sectV, info.pubSd ? "true" : "false" );
            base->sckOut();
            sprintf(base->outBuff, "Net published groups: %u", info.grpPubNet);
            base->sckOut();
            sprintf(base->outBuff, "Net un-published groups: %u", info.grpUnPubNet);
            base->sckOut();
            sprintf(base->outBuff, "Sd saved groups: %u", info.grpPubSd);
            base->sckOut();
            sprintf(base->outBuff, "Sd not saved groups: %u", info.grpUnPubSd);
            base->sckOut();
            sprintf(base->outBuff, "Total groups: %u", info.grpTotal);
            base->sckOut();
            sprintf(base->outBuff, "Freespace: %u bytes", info.freeSpace);
            base->sckOut();
            base->epoch2iso(info.firstTime, base->ISOtimeBuff);
            sprintf(base->outBuff, "First group: %s", base->ISOtimeBuff);
            base->sckOut();
            base->epoch2iso(info.lastTime, base->ISOtimeBuff);
            sprintf(base->outBuff, "Last group:  %s\r\n", base->ISOtimeBuff);
            base->sckOut();
        }
    }
}
extern "C" char *sbrk(int i);
void freeRAM_com(SckBase* base, String parameters)
{

    char stack_dummy = 0;
    uint32_t free = &stack_dummy - sbrk(0);
    sprintf(base->outBuff, "Free RAM: %lu bytes", free);
    base->sckOut();
}
void i2cDetect_com(SckBase* base, String parameters)
{

    for (uint8_t whichWire=0; whichWire<2; whichWire++) {

        if (whichWire == 0) base->sckOut("Searching for devices on internal I2C bus...");
        else base->sckOut("\r\nSearching for devices on auxiliary I2C bus...");

        uint8_t nDevices = 0;
        for(uint8_t address = 1; address < 127; address++ ) {

            uint8_t error;
            if (whichWire == 0) {
                Wire.beginTransmission(address);
                error = Wire.endTransmission();
            } else {
                auxWire.beginTransmission(address);
                error = auxWire.endTransmission();
            }

            if (error == 0) {
                sprintf(base->outBuff, "I2C device found at address 0x%02x!!", address);
                base->sckOut();
                nDevices++;
            } else if (error==4) {
                sprintf(base->outBuff, "Unknow error at address 0x%02x!!", address);
                base->sckOut();
            }
        }
        sprintf(base->outBuff, "Found %u devices", nDevices);
        base->sckOut();
    }
}
void power_com(SckBase* base, String parameters)
{
    // Get

    int16_t extraI = parameters.indexOf("-info");
    if (parameters.length() <= 0 || extraI >= 0) {

        if (base->config.sleepTimer == 0) sprintf (base->outBuff, "Sleep disabled");
        else sprintf(base->outBuff, "Sleep after: %u min", base->config.sleepTimer);
        base->sckOut();

        if (base->battery.present) {
            sprintf(base->outBuff, "Battery: %u%% (%lumAh) - %0.2fv (%s)", base->battery.percent(&base->charger), base->config.battConf.battCapacity, base->battery.voltage(), base->charger.chargeStatusTitles[base->charger.getChargeStatus()]);
        } else {
            sprintf(base->outBuff, "Battery: NOT present");
        }
        base->sckOut();

        sprintf(base->outBuff, "USB: %s", base->charger.VBUSStatusTitles[base->charger.getVBUSstatus()]);
        base->sckOut();

        if (extraI >= 0) {

            sprintf(base->outBuff, "OTG: %s", base->charger.enTitles[base->charger.OTG()]);
            base->sckOut();

            sprintf(base->outBuff, "Charge: %s", base->charger.enTitles[base->charger.chargeState()]);
            base->sckOut();

            sprintf(base->outBuff, "Batfet: %s", base->charger.enTitles[base->charger.batfetState()]);
            base->sckOut();

            sprintf(base->outBuff, "Charger current limit: %u mA", base->charger.chargerCurrentLimit());
            base->sckOut();

            sprintf(base->outBuff, "Input current limit: %u mA", base->charger.inputCurrentLimit());
            base->sckOut();

            sprintf(base->outBuff, "I2c watchdog timer: %u sec (0: disabled)", base->charger.I2Cwatchdog());
            base->sckOut();

            sprintf(base->outBuff, "Charging safety timer: %u hours (0: disabled)", base->charger.chargeTimer());
            base->sckOut();

            sprintf(base->outBuff, "Min system voltage: %0.2f volts", base->charger.sysMinVolt());
            base->sckOut();

            sprintf(base->outBuff, "Battery lower than %0.2f: %s", base->charger.sysMinVolt(), base->charger.getBatLowerSysMin() ? "true" : "false");
            base->sckOut();

        }

        // Set
    } else {

        int16_t chargeI = parameters.indexOf("-charge");
        if (chargeI >=0) {
            String chargeC = parameters.substring(chargeI+8);
            if (chargeC.startsWith("on")) base->charger.chargeState(1);
            if (chargeC.startsWith("off")) base->charger.chargeState(0);
        }

        int16_t otgI = parameters.indexOf("-otg");
        if (otgI >=0) {
            String otgC = parameters.substring(otgI+5);
            if (otgC.startsWith("on")) base->charger.OTG(1);
            if (otgC.startsWith("off")) base->charger.OTG(0);
        }

        int16_t batcapI = parameters.indexOf("-batcap");
        if ( batcapI>=0) {
            String batcapC = parameters.substring(batcapI+8);
            batcapC.trim();
            int32_t batcapInt = batcapC.toInt();
            if (batcapInt > 200 && batcapInt < 20000) {
                base->config.battConf.battCapacity = batcapInt;
                base->saveConfig();
                sprintf(base->outBuff, "New battery capacity: %lu\r\nWe need to reset for changes to take effect\r\nClick any key.", base->config.battConf.battCapacity);
                base->sckOut();
                while (!SerialUSB.available())
                    ;
                base->sck_reset();
            } else {
                sprintf(base->outBuff, "Wrong battery capacity");
            }
            base->sckOut();
        }

        int16_t sleepI = parameters.indexOf("-sleep");
        if (sleepI>=0) {
            String sleepC = parameters.substring(sleepI+7);
            sleepC.trim();
            int32_t sleepInt = sleepC.toInt();
            if (sleepInt >= 0 && sleepInt < 480) {  // Max 8 hours
                base->config.sleepTimer = sleepInt;
                base->saveConfig();
                base->lastUserEvent = millis();
                sprintf(base->outBuff, "New sleep timer period: %u.", base->config.sleepTimer);
            } else {
                sprintf(base->outBuff, "Wrong sleep timer period (0-480)");
            }
            base->sckOut();
        }

    }
}
void config_com(SckBase* base, String parameters)
{
    bool resetMsg = false;

    // Set
    if (parameters.length() > 0) {

        if (parameters.indexOf("-defaults") >= 0) {
            base->saveConfig(true);
            resetMsg = true;
        } else {
            // Shows or sets configuration [-defaults -mode sdcard/network -pubint publish-interval -wifi \"ssid/null\" [\"pass\"] -token token/null]
            int16_t modeI = parameters.indexOf("-mode");
            if (modeI >= 0) {
                String modeC = parameters.substring(modeI+6);
                modeC.toLowerCase();
                if (modeC.startsWith("sd")) base->config.mode = MODE_SD;
                else if (modeC.startsWith("net")) base->config.mode = MODE_NET;
            }
            int16_t pubIntI = parameters.indexOf("-pubint");
            if (pubIntI >= 0) {
                String pubIntC = parameters.substring(pubIntI+8);
                uint32_t pubIntV = pubIntC.toInt();
                if (pubIntV >= SC_MIN_PUB_INTERVAL && pubIntV <= SC_MAX_PUB_INTERVAL) base->config.publishInterval = pubIntV;
            }
            int16_t readIntI = parameters.indexOf("-readint");
            if (readIntI >= 0) {
                String readIntC = parameters.substring(readIntI+9);
                uint32_t readIntV = readIntC.toInt();
                if (readIntV >= SC_MIN_READING_INTERVAL && readIntV <= base->config.publishInterval) base->config.readInterval = readIntV;
            }
            int16_t credI = parameters.indexOf("-wifi");
            if (credI >= 0) {
                int16_t first = parameters.indexOf("\"", credI+6);
                int16_t second = parameters.indexOf("\"", first + 1);
                int16_t third = parameters.indexOf("\"", second + 1);
                int16_t fourth = parameters.indexOf("\"", third + 1);
                if (parameters.substring(first + 1, second).length() > 0) {
                    parameters.substring(first + 1, second).toCharArray(base->config.credentials.ssid, 64);
                    base->config.credentials.set = true;
                }
                if (parameters.substring(third + 1, fourth).length() > 0) {
                    parameters.substring(third + 1, fourth).toCharArray(base->config.credentials.pass, 64);
                } else {
                    strncpy(base->config.credentials.pass, "", 64);
                }
            }
            int16_t tokenI = parameters.indexOf("-token");
            if (tokenI >= 0) {
                String tokenC = parameters.substring(tokenI+7);
                if (tokenC.length() >= 6) {
                    tokenC.toCharArray(base->config.token.token, 7);
                    base->config.token.set = true;
                }
            }
            int16_t sanityI = parameters.indexOf("-sanity");
            if (sanityI >= 0) {
                String sanityC = parameters.substring(sanityI+8);
                if (sanityC.startsWith("off")) base->config.sanityResetFlag = false;
                else if (sanityC.startsWith("on")) base->config.sanityResetFlag = true;
                else base->sckOut("Error reading sanity reset option!");
            }
            base->saveConfig();
        }
        sprintf(base->outBuff, "-- New config --\r\n");
        base->sckOut();

        // Get
    } else base->outBuff[0] = 0;

    Configuration currentConfig = base->getConfig();

    sprintf(base->outBuff, "Mode: %s\r\nPublish interval (s): %lu", base->modeTitles[currentConfig.mode], currentConfig.publishInterval);
    base->sckOut();

    sprintf(base->outBuff, "Reading interval (s): %lu", currentConfig.readInterval);
    base->sckOut();

    if (currentConfig.credentials.set) sprintf(base->outBuff, "Wifi credentials: %s - %s", currentConfig.credentials.ssid, currentConfig.credentials.pass);
    else sprintf(base->outBuff, "Wifi credentials: not configured");
    base->sckOut();

    if (currentConfig.token.set) sprintf(base->outBuff, "Token: %s", currentConfig.token.token);
    else sprintf(base->outBuff, "Token: not configured");
    base->sckOut();

    // sprintf(base->outBuff, "Mac address:  %s", base->config.mac.address);
    // base->sckOut();

    sprintf(base->outBuff, "Sanity reset (every 24 hours) is: %s", base->config.sanityResetFlag ? "on" : "off");
    base->sckOut();

    if (resetMsg) base->sckOut("\r\n** Please reset your kit **");
}
void esp_com(SckBase* base, String parameters)
{

    if (parameters.equals("-on")) base->ESPcontrol(base->ESP_ON);
    else if (parameters.equals("-off")) base->ESPcontrol(base->ESP_OFF);
    else if (parameters.equals("-reboot")) base->ESPcontrol(base->ESP_REBOOT);
    else if (parameters.startsWith("-flash")) {
        parameters.replace("-flash ", "");
        uint32_t speed = parameters.toInt();
        if (speed >= 115200 && speed <= 921600) base->espFlashSpeed = speed;
        base->ESPcontrol(base->ESP_FLASH);
    } else if (parameters.equals("-sleep")) base->ESPcontrol(base->ESP_SLEEP);
    else if (parameters.equals("-wake")) base->ESPcontrol(base->ESP_WAKEUP);
    else base->sckOut("Unrecognized command , try help!!");
}
void netInfo_com(SckBase* base, String parameters)
{

	base->ESPsend(ESPMES_GET_NETINFO, "");
}
void time_com(SckBase* base, String parameters)
{
	base->epoch2iso(base->rtc.getEpoch(), base->ISOtimeBuff);
	base->sckOut();

	if (parameters.length() <= 0) {

		if (base->ISOtime()) {
			sprintf(base->outBuff, "Time: %s", base->ISOtimeBuff);
			base->sckOut();
		} else {
			base->sckOut("Time is not synced, trying to sync...");
			base->ESPsend(ESPMES_GET_TIME, "");
		}
	}

	// Force sync
	if (parameters.equals("-sync")) {
		if (!base->st.espON) {
			base->ESPcontrol(base->ESP_ON);
			delay(200);
		}
		if (base->ESPsend(ESPMES_GET_TIME, "")) base->sckOut("Asking time to ESP...");
	}

	// Receive Epoch time and sync
	if (parameters.toInt() > 0) base->setTime(parameters);
}
void hello_com(SckBase* base, String parameters)
{
	if (base->ESPsend(ESPMES_MQTT_HELLO, "")) base->sckOut("Hello sent!");
	base->sckOut("Waiting for MQTT hello response...");
}
void debug_com(SckBase* base, String parameters)
{
	// Set
	bool saveNeeded = false;
	if (parameters.length() > 0) {
		if (parameters.indexOf("-sdcard") >= 0) {
			base->config.debug.sdcard = !base->config.debug.sdcard;
			sprintf(base->outBuff, "SD card debug: %s", base->config.debug.sdcard ? "true" : "false");
			base->sckOut();
			saveNeeded = true;
		}
#ifdef SCK_WITH_SENSOR_GROVE_OLED
		if (parameters.indexOf("-oled") >= 0) {
			base->config.debug.oled = !base->config.debug.oled;
			sprintf(base->outBuff, "Oled display debug: %s", base->config.debug.oled ? "true" : "false");
			base->sckOut();
			saveNeeded = true;
		}
#endif
		if (parameters.indexOf("-flash") >= 0) {
			base->readingsList.debug = !base->readingsList.debug;
			base->config.debug.flash = !base->config.debug.flash;
			sprintf(base->outBuff, "Flash memory debug: %s", base->config.debug.flash ? "true" : "false");
			base->sckOut();
			saveNeeded = true;
		}
		if (parameters.indexOf("-speed") >= 0) {
			base->config.debug.speed = !base->config.debug.speed;
			sprintf(base->outBuff, "Speed debug: %s", base->config.debug.speed ? "true" : "false");
			base->sckOut();
			saveNeeded = true;
		}
		if (parameters.indexOf("-serial") >= 0) {
			base->config.debug.serial = !base->config.debug.serial;
			serESP.debug = base->config.debug.serial;
			sprintf(base->outBuff, "Serial debug: %s", base->config.debug.serial ? "true" : "false");
			base->sckOut();
			saveNeeded = true;
			base->pendingSyncConfig = true; // Make sur the config is sent to ESP
		}
	// Get
	} else {
		sprintf(base->outBuff, "SD card debug: %s", base->config.debug.sdcard ? "true" : "false");
		base->sckOut();

#ifdef SCK_WITH_SENSOR_GROVE_OLED
		sprintf(base->outBuff, "Oled display debug: %s", base->config.debug.oled ? "true" : "false");
		base->sckOut();
#endif
		sprintf(base->outBuff, "Flash memory debug: %s", base->config.debug.flash ? "true" : "false");
		base->sckOut();

		sprintf(base->outBuff, "Speed debug: %s", base->config.debug.speed ? "true" : "false");
		base->sckOut();

		sprintf(base->outBuff, "Serial debug: %s", base->config.debug.serial ? "true" : "false");
		base->sckOut();
	}
	if (saveNeeded) base->saveConfig();
}
void shell_com(SckBase* base, String parameters)
{
    if (parameters.length() > 0) {
        if (parameters.equals("-on")) {
            base->st.onShell = true;
            base->st.onSetup = false;
            base->led.update(base->led.YELLOW, base->led.PULSE_STATIC);
            base->sckOut("You entered shell mode, please reset the SCK to get out");
        } else if (parameters.equals("-off")) {
            base->sckOut("Reseting the SCK...");
            base->sck_reset();
        }
    }
    sprintf(base->outBuff, "Shell mode: %s", base->st.onShell ? "on" : "off");
    base->sckOut();
}
void custom_mqtt_com(SckBase* base, String parameters)
{
    int16_t mfirst = parameters.indexOf("\"", 0);
    int16_t msecond = parameters.indexOf("\"", mfirst + 1);
    int16_t mthird = parameters.indexOf("\"", msecond + 1);
    int16_t mfourth = parameters.indexOf("\"", mthird + 1);
    base->mqttCustom(parameters.substring(mfirst + 1, msecond).c_str(), parameters.substring(mthird + 1, mfourth).c_str());
}
void offline_com(SckBase* base, String parameters)
{
    bool saveNeeded = false;

    if (parameters.length() > 0) {

        int16_t retryIntI = parameters.indexOf("-retryint");
        if (retryIntI >= 0) {
            String retryIntC = parameters.substring(retryIntI+10);
            uint32_t retryIntV = retryIntC.toInt();
            if (retryIntV >= SC_MIN_PUB_INTERVAL && retryIntV <= SC_MAX_PUB_INTERVAL) {
                base->config.offline.retry = retryIntV;
                saveNeeded = true;
            } else base->sckOut("Wrong retry interval!!!");
        }

        int16_t startIntI = parameters.indexOf("-period");
        if (startIntI >= 0) {

            int8_t start = -1;
            String startIntC = parameters.substring(startIntI+8);
            start = startIntC.toInt();

            int8_t end = -1;
            int16_t endIntI = parameters.indexOf(" ", startIntI+8);
            if (endIntI >= 0) {
                String endIntC = parameters.substring(endIntI+1);
                end = endIntC.toInt();
            }

            // Parameter sanity check
            if (start >= 0 && start <= 23 && end >= 0 && end <= 23 && start != end) {
                base->config.offline.start = start;
                base->config.offline.end = end;
                saveNeeded = true;
            } else base->sckOut("Wrong start or end offline times!!");
        }
    }

    // Print parameters
    sprintf(base->outBuff, "WiFi retry period (s): %lu", base->config.offline.retry);
    base->sckOut();

    if (base->config.offline.start < 0 || base->config.offline.end < 0) sprintf(base->outBuff, "No offline period configured");
    else sprintf(base->outBuff, "Offline period: %u - %u (UTC)", base->config.offline.start, base->config.offline.end);
    base->sckOut();

    if (saveNeeded) base->saveConfig();
}
void mqttConfig_com(SckBase* base, String parameters)
{
	// Set
	if (parameters.length() > 0) {

		int16_t serverI = parameters.indexOf("-host");
		if (serverI >= 0) {
			String serverC = parameters.substring(serverI+6, parameters.indexOf(" ", serverI+6));
			if (serverC.length() < 64) {
				serverC.toCharArray(base->config.mqtt.server, 64);
			} else {
				sprintf(base->outBuff, "Mqtt host name should be less than 64 chars");
				base->sckOut();
			}
		}

		int16_t portI = parameters.indexOf("-port");
		if (portI >= 0) {
			String portC = parameters.substring(portI+6, parameters.indexOf(" ", portI+6));
			uint16_t portV = portC.toInt();
			if (portV > 0) base->config.mqtt.port = portV;
			else {
				sprintf(base->outBuff, "Error setting Mqtt server port");
				base->sckOut();
			}
		}
		base->pendingSyncConfig = true;
		base->saveConfig();
	}

	// Get
	Configuration currentConfig = base->getConfig();

	sprintf(base->outBuff, "Mqtt Host: %s", currentConfig.mqtt.server);
	base->sckOut();
	sprintf(base->outBuff, "Mqtt Port: %u", currentConfig.mqtt.port);
	base->sckOut();

}
void ntpConfig_com(SckBase* base, String parameters)
{
	// Set
	if (parameters.length() > 0) {

		int16_t serverI = parameters.indexOf("-host");
		if (serverI >= 0) {
			String serverC = parameters.substring(serverI+6, parameters.indexOf(" ", serverI+6));
			if (serverC.length() < 64) {
				serverC.toCharArray(base->config.ntp.server, 64);
			} else {
				sprintf(base->outBuff, "NTP host name should be less than 64 chars");
				base->sckOut();
			}
		}

		int16_t portI = parameters.indexOf("-port");
		if (portI >= 0) {
			String portC = parameters.substring(portI+6, parameters.indexOf(" ", portI+6));
			uint16_t portV = portC.toInt();
			if (portV > 0) base->config.ntp.port = portV;
			else {
				sprintf(base->outBuff, "Error setting NTP server port");
				base->sckOut();
			}
		}
		base->pendingSyncConfig = true;
		base->saveConfig();
	}

	// Get
	Configuration currentConfig = base->getConfig();

	sprintf(base->outBuff, "NTP Host: %s", currentConfig.ntp.server);
	base->sckOut();
	sprintf(base->outBuff, "NTP Port: %u", currentConfig.ntp.port);
	base->sckOut();
}
void sleep_com(SckBase* base, String parameters)
{
    base->sckOFF = true;
    base->goToSleep();
}
void led_com(SckBase* base, String parameters)
{
	// Set
	if (parameters.length() > 0) {
        parameters.replace("led", "");
        parameters.trim();
        uint8_t newBrightness = parameters.toInt();
        base->led.brightness = newBrightness;
        base->config.ledBrightness = newBrightness;
        base->saveConfig();
    }

	sprintf(base->outBuff, "led brightness: %u", base->led.brightness);
	base->sckOut();
}
void file_com(SckBase* base, String parameters)
{
	if (parameters.length() > 0) {

		int16_t start = parameters.indexOf("-ls");
        if (start >= 0) {
            base->fileManager(base->FILECOM_LS, "");
            return;
        }

		start = parameters.indexOf("-rm");
		if (start>= 0) {
			String name = parameters.substring(start+4);
            name.trim();
            base->fileManager(base->FILECOM_RM, name.c_str());
            return;
		}

		start = parameters.indexOf("-less");
		if (start>= 0) {
			String name = parameters.substring(start+6);
            name.trim();
            base->fileManager(base->FILECOM_LESS, name.c_str());
            return;
		}

		start = parameters.indexOf("-allcsv");
        if (start >= 0) {
            base->fileManager(base->FILECOM_ALLCSV, "");
            return;
        }
    }
}
