fablabbcn/smartcitizen-kit-2x/sam/src/Commands.h

#pragma once

#include <Arduino.h>
#include <Wire.h>

extern TwoWire auxWire;

class SckBase;

// Define command type
enum CommandType {

    COM_RESET,
    COM_GET_VERSION,
    COM_RESET_CAUSE,
    COM_OUTLEVEL,
    COM_HELP,
    COM_PINMUX,
    COM_LIST_SENSOR,
    COM_READ_SENSOR,
    COM_CONTROL_SENSOR,
    COM_MONITOR_SENSOR,
    COM_FLASH,
    COM_GET_FREERAM,
    COM_I2C_DETECT,
    COM_CHARGER,
    COM_CONFIG,
    COM_ESP_CONTROL,
    COM_NETINFO,
    COM_TIME,
    COM_HELLO,
    COM_DEBUG,
    COM_SHELL,
    COM_CUSTOM_MQTT,
    COM_OFFLINE,
    COM_MQTT_CONFIG,
    COM_NTP_CONFIG,
    COM_SLEEP,
    COM_LED,
    COM_FILE,
    COM_WDT,

    COM_COUNT
};

// Declare command function
void reset_com(SckBase* base, String parameters);
void getVersion_com(SckBase* base, String parameters);
void resetCause_com(SckBase* base, String parameters);
void outlevel_com(SckBase* base, String parameters);
void help_com(SckBase* base, String parameters);
void pinmux_com(SckBase* base, String parameters);
void sensorConfig_com(SckBase* base, String parameters);
void readSensor_com(SckBase* base, String parameters);
void controlSensor_com(SckBase* base, String parameters);
void monitorSensor_com(SckBase* base, String parameters);
void flash_com(SckBase* base, String parameters);
void freeRAM_com(SckBase* base, String parameters);
void i2cDetect_com(SckBase* base, String parameters);
void power_com(SckBase* base, String parameters);
void config_com(SckBase* base, String parameters);
void esp_com(SckBase* base, String parameters);
void netInfo_com(SckBase* base, String parameters);
void time_com(SckBase* base, String parameters);
void hello_com(SckBase* base, String parameters);
void debug_com(SckBase* base, String parameters);
void shell_com(SckBase* base, String parameters);
void custom_mqtt_com(SckBase* base, String parameters);
void offline_com(SckBase* base, String parameters);
void mqttConfig_com(SckBase* base, String parameters);
void ntpConfig_com(SckBase* base, String parameters);
void sleep_com(SckBase* base, String parameters);
void led_com(SckBase* base, String parameters);
void file_com(SckBase* base, String parameters);
void wdt_com(SckBase* base, String parameters);

typedef void (*com_function)(SckBase* , String);

class OneCom {
public:
    uint16_t place;
    CommandType type;
    const char *title;
    const char *help;
    com_function function;

    OneCom(uint16_t nplace, CommandType ntype, const char *nTitle, const char *nhelp, com_function nfunction) {
        place = nplace;
        type = ntype;
        title = nTitle;
        help = nhelp;
        function = nfunction;
    }
};

class AllCommands {
public:

    OneCom com_list[COM_COUNT] {
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
