fablabbcn/smartcitizen-kit-2x/(commit log)

2016-11-20 Integrated new Sound Driver version
2016-11-20 SDcard support (disabled because SPI inestability to be solved)
    [SmartCitizenKit.ino]
2016-11-21 Initial battery level support
2016-11-21 Improved led feedback on starting process
2016-11-21 fix error that prevents light calibration
2016-11-21 Initial button and sleep support
2016-11-22 Fix for noise hardware no behaving properly
    [SmartCitizenKit.ino]
2016-11-27 Fix wrong pin number
2016-11-27 Persistent on/off setting (after power interruption)
2016-11-28 Refresh period is now part of led object
2016-11-29 Simpler and faster led control
2016-11-30 Battery values are published in mV (RAW)
2016-11-30 Button behaviour touches
2017-01-20 working on mode management and button mode change
2017-04-03 -Simple change between modes -New function to clear all timers at once -First part of SDcard calls reorganization
2017-04-03 - Fixed USB serial connection issues when not starting ESP - Fixed problems when no SDcard was inserted - Close opened files on mode change to avoid hangs SD-ESP - Clear ESPbooting flag on ESP_OFF (f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
2017-04-03 - Translated ESP apMode configuration page to Catalan - Temporary removed "Set Interval configuration option" - Some little changes in ESP apMode configuration page - Temporal change of Webserver ans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
2017-04-03 Dim led after some time (still needs some love)
2017-04-04 Fix for readlight without serial cable connected
2017-04-06 Fix for battery readings showing 0% on fully charged battery
2017-04-09 * Improved SDcard management in general * Avoid hangs on sdcard corruption * Fix behaviour on MQTT errors * Improved relation between ESP and sdcard on SPI bus. * If button is pressed don't fade led.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
    [SmartCitizenKit.ino]
2017-04-11 - Added support for Seed Studio Groove I2C ADC
2017-04-11 Add support for Adafruit INA219 Current sensor
2017-04-12 Added support for Groove I2C Oled Display 96x96
2017-04-12 - Fix problems with ESP on and off operations. - Try to support USB connection detection with more devices
    [SmartCitizenKit.ino]
2017-05-16 Improved and simpler sensor name console matching
2017-05-16 Added control interface for sensors
2017-05-16 New MICS driver
2017-06-07 Big commit - Implemented external command to reset to factory defaults: "set config factory" - Implemented new configuration system - Reading interval per sensor - Global publish interval - Simplifie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
    [SmartCitizenKit.ino]
2017-06-19 -- Added function disableSensor -- Turn off MICS heater on disable sensor.
2017-07-21 - Updated build script for uploadings ESP file system - Fix for wrong serial port selected by some systems - Added automatic reset after ESP firmware/flash upload
    [uploadESP.py]
2017-07-25 Fix firmware upload when no SD card present
    [uploadESP.py]
2017-08-01 Added auxiliary sensors auto-detection and auto-enable
2017-08-01 Added support for DS18B20 waterproof temp sensor through DS2482 I2C-1Wire bridge
2017-08-03 Support for Atlas Scientific Dissolved Oxigen EZO probe Support for Atlas Scientific Conductivity EZO probe Support for Atlas Scientific pH probe
2017-08-03 BIG COMMIT - New status reporting system - ESP webserver now works form plain files from flash - Platform MQTT posting is working again! - Simpler and more robust wifi credentials system - Support fo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
    [esp.ino]
2017-08-03 Improved groove OLED sensors display support
2017-08-04 - Changed some sensor defaults - Fixed a bug when no config.txt is found - More robust config mode management
2017-08-04 - Fixed bug that prevents ESP flashing - Assigned platform ID to Atlas sensors
2017-09-18 Simplify button CSS. Add mock-api + readme
2017-09-18 Add device time
2017-09-19 Top navbar is fixed, add button colors
2017-10-04 WIP: Rework flow (#4)
    * Reworking ui flow
    * Add publish interval
    * Add phantomjs dependency
    * Kit info moved under a toggle button
    * Add Exit Advanced button
    * Travis remove unused var, was triggering extra build
    * Mock api supports GET on /set = connect
    * Add sensor checkboxes
2017-10-09 Few touches: - Slow down ESP firmware upload speed to minimize errors. - Default sensor reading 30 sec. - Few typo fixes - Code cleanUp
    [SmartCitizenKit.ino]
2017-10-09 - Low power sleep mode improved (around 5 mA) - Around a month with one charge (without MICS) - Several bugs fixed - Implemented "sleep" external command - When battery is less than 3% sleep to save 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
2017-10-16 Integrated Adafruit HTU21DF library for Temperature and Humidity readings
2017-10-16 AlphaDelta driver remake, now as a separate library Moved Aux sensor drivers to sensor lib folder
2017-10-18 Use checkboxes instead of buttons
2017-10-27 Add base pages for 4 page 'next' flow
2017-11-14 WIP: Apply guillems design (#5)
    * Apply guillems design
    * Cleanup. Shorten delay times.
    * Add nvm version
    * Add experimental + debug switch
    * Update tests
    * Add back button
    * SCK logo now a svg
    * Show /status info in table. Add API error warning
    * Readme Link to the new repo
    * Apply guillems design
    * Cleanup. Shorten delay times.
    * Add nvm version
    * Add experimental + debug switch
    * Update tests
    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
2017-11-27 Led code is now in its own file
2017-11-27 Added interrupt for button alarm
2017-11-27 Separated file for button code
2017-12-12 Starting refurbish, already working: * Led * Button * Console output/input * Command interface
2017-12-12 Implemented reset, version, outlevel and help commands.
    [Commands.cpp, Commands.h, SckBase.cpp, SckBase.h]
2018-01-15 Started Urban Board refurbish
2018-01-31 Moved pin definitions to his own file
2018-01-31 Setup I2C auxiliary bus
2018-03-26 Some work on i2C detection
2018-04-04 Hardware files added
    [SCK_DATA_BOARD_2.0_REV_03.sch, SCK_URBAN_SENSOR_BOARD_2.0_REV_01.sch]
2018-04-16 Fix on multiple SDcard interrupts
    [SckBase.cpp, SckBase.h]
2018-04-16 Auxiliary I2C bus touches
2018-04-16 Fix: UpArrow not detected on slow serial terminal software
    [SckBase.cpp]
2018-04-23 charger lib update
2018-04-23 Charger info command
2018-04-23 New timers based on interrupts
2018-04-23 missing interrupt handler on last commit
    [SmartCitizenKit.ino]
2018-05-06 SAM: reset config after flashing
    [uploadSAM.py]
2018-05-06 Implemented button user interaction
2018-05-06 Workaround on battery detection problems
    [SckBase.cpp]
2018-05-16 Added Noise library for reporting dBA, dBC and dBZ
    [SckUrban.cpp, SckUrban.h]
2018-05-16 Added support for Plantower PM sensors via PMboard
2018-05-16 Fixed led behavior on some cases
    [SckLed.cpp]
2018-05-17 Back button CSS nudge
2018-05-19 PM sensor now reads average if two devices are detected
2018-05-19 Button rework
2018-05-19 Missing parts on previous commit
    [SckBase.cpp, SckButton.cpp, SmartCitizenKit.ino]
2018-05-19 Led color touches
2018-05-19 Improved button feedback on wakeup Reset on I2S hang as temporal workaround Minimize Console output on Auxiliary sensor detection More work on state management Fix on reset default config on flashing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
    [SckBase.cpp, SckBase.h, SckButton.cpp, uploadSAM.py]
2018-05-19 Disable Noise sensor for now (too much flash)
    [SckUrban.cpp, SckUrban.h]
2018-05-21 Implemented sensor enable/disable and reading interval runtime configuration
2018-05-21 Implemented provisional support for Alphasense calibrated ppm readings
2018-05-22 Fix on last commit false SHT31 detection
    [SckAux.cpp]
2018-05-22 Improved wrong light readings
    [SckUrban.cpp]
2018-05-23 Temporal hardcoded calibration data Alphasense
2018-05-23 Lower Wifi led brightness
2018-05-23 Led management improvements
2018-05-23 Fix error on last led commit
    [SckLed.cpp]
2018-05-28 Added sck2 board definition
2018-05-28 Added custom variant sck2
    [arduino_zero.cfg]
2018-05-31 Fix error on some bad wifi situations
    [SckESP.cpp]
2018-06-04 Added support for AlphaDelta tester board
2018-06-08 Integrated control sensor interface
2018-06-11 Integrated AlphaDelta (GasPro) board tester support
2018-06-14 Adds schematics in PDF and updates README
2018-06-15 Removed sensor dependency from ESP
2018-06-18 Only Noise disabled for now (flash size limitation)
    [Commands.h, SckAux.cpp, SckAux.h, SckUrban.cpp, SckUrban.h]
2018-06-18 Missed this to disable sound
    [SckUrban.cpp]
2018-06-18 Update on Alphasense driver
2018-06-18 Update on sensor control interface
2018-06-18 Update on Light sensor
2018-06-18 Travis: use stages
2018-06-18 Travis stage typeo
2018-06-18 Travis call script relative to current folder
2018-06-19 Starting MICS calibration data implementation
2018-06-19 Fix on SHT31 library not using the right I2C bus
    [SckAux.cpp, SckUrban.cpp]
2018-06-19 Fix on enable/disable sensor not working until reset
    [Commands.cpp, SckBase.cpp, SckBase.h]
2018-06-19 Fix SHT31 error on to fast request
    [SckUrban.cpp, SckUrban.h]
2018-06-19 Fixed monitor command and added new features: * Timestamp * Milliseconds between readings * Sd card logging
    [Commands.cpp, Commands.h, SckBase.h]
2018-06-20 Removed unused Timer library
2018-06-20 Removed remaining Sensor dependency on ESP
2018-06-20 Fixed typo on NO2 sensor reading
    [SckUrban.cpp]
2018-06-22 * I2C detect function now accepts different wire instance * Fix some compiler warnings
    [AlphaDelta.cpp, Commands.cpp, SckAux.cpp, SckBase.cpp, SckBase.h]
2018-06-22 MICS automatic heater control on enable/disable MICS heater timer Fix NO2 formula error
    [SckBase.cpp, SckBase.h, SckUrban.cpp, SckUrban.h]
2018-06-26 Fixed problem with first (after boot) ESP->SAM message
    [SckBase.cpp, SckESP.cpp]
2018-06-27 Sensor name reorganization
2018-06-28 SD card mode support Some fixes in state management
    [SckBase.cpp, SckBase.h, SckESP.cpp]
2018-06-28 State management work and fixes
    [SckBase.cpp, SckESP.cpp]
2018-07-05 Added lookup table for Gases Pro Tester board_0
2018-07-05 Gases Pro Tester board lookup tables update
2018-07-05 Now using ESP deep sleep instead of power cut in most cases
2018-07-05 Fixed some compiler warnings
    [Commands.cpp, SckAux.cpp, SckBase.cpp, SckBase.h, SckUrban.cpp]
2018-07-05 ESP led totally of on deep sleep
2018-07-05 Fix communication errors SAM<->ESP with commands > 10
    [SckBase.cpp, SckESP.cpp]
2018-07-06 Fix sd card insert/remove hang
    [SckBase.cpp, SckBase.h]
2018-07-06 Avoid repeated meesage output to console
    [SckBase.cpp, SckBase.h]
2018-07-06 Updating sensor readings independently of publishing
2018-07-06 FIX esp not entering APmode after Factory reset config if it was connected
    [SckESP.cpp]
2018-07-06 Fix wrong time to next publish on startUP Fix console prompt not showing
    [SckBase.cpp]
2018-07-06 Fix on ESP on/off loop when pending send config
    [SckBase.cpp]
2018-07-10 Changed reset function name
    [Commands.cpp, SckBase.cpp, SckBase.h, SckButton.cpp]
2018-07-10 Updated VID/PID codes on SCK2.0 variant
2018-07-10 Temp regression on VID/PID changes
2018-07-19 Fix battery pin naming
    [SckBase.cpp]
2018-07-20 Wip on new (2.0.1) power management
2018-07-20 SmartCitizenKit Gases Pro board as separate library
2018-07-20 Change to custom-Wire ADC library
2018-07-23 Support for Smartcitizen Gases Pro board external library
2018-07-24 More work on power system
2018-07-25 Fix time on sdcard publish
    [SckBase.cpp]
2018-07-25 Fix Time on SD card publish
    [SckBase.cpp]
2018-07-25 Fix some problems on sd card mode
    [SckBase.cpp]
2018-07-27 Improved start/stop of sensors
2018-07-28 Test plan Battery, Charger and Dust sensor integration
2018-07-28 Integrated Urban Board PM sensors
2018-07-28 Removed debug print
2018-07-29 Test plan: added PM sensor test
2018-07-30 Battery WIP
2018-07-30 Implemented PM sensor control interface
2018-08-11 Fix MICS reading returning inf
    [SckUrban.cpp]
2018-08-11 Fix MICS NO2 returning inf
    [SckUrban.cpp]
2018-08-14 Fix on led not fully off
    [SckLed.cpp]
2018-08-14 Fix on net publish hang
    [SckBase.cpp]
2018-08-21 Fix on sdcard mode problems getting time after power cut and no battery
    [SckBase.cpp]
2018-08-22 Test Plan: Fix on wifi failing.
    [SckTest.cpp]
2018-08-22 Added periodic (once a day) sanity reset
    [SckBase.cpp]
2018-08-23 Updated hardware files
    [SCK_DATA_BOARD_2.0_REV_03.sch, SCK_DATA_BOARD_2.1_REV_03.sch, SCK_URBAN_SENSOR_BOARD_2.0_REV_01.sch, SCK_URBAN_SHIELD_2.1_REV_04.sch]
2018-08-23 Added support to oneWire DS18B20 temperature sensor through PM board
2018-08-23 Changed PM sensors enum name
2018-08-23 Separate enum for internal/external PM sensors
2018-08-23 Some PM sensors name change missing
    [SckAux.h]
2018-08-24 Gas sensor cleanUP
2018-08-27 Fix on duplicate battery publish
    [SckBase.cpp]
2018-08-30 First noise WIP commit
    [SckAux.cpp, SckSoundTables.h, SckUrban.cpp, SckUrban.h]
2018-08-30 Fix to ESP debug library version change
    [SckESP.cpp]
2018-08-31 Reorganize power management code
2018-09-03 Added external PM sensor detection
2018-09-04 Battery update still a lot to go
2018-09-04 Added sd card debug log capacity
2018-09-04 Disable Urban Board sensors when the board isn't detected
2018-09-12 MICS work: New sensor heat voltage, some cleaning and fix small bugs
    [Pins.h, SckUrban.cpp, SckUrban.h]
2018-09-12 Fix control sensor command error on passing parameters
    [Commands.cpp]
2018-09-13 Improved Sensor enabling/disabling
2018-09-13 Implemented Urban board automatic PM sensor detection
2018-09-14 Implemented MICS Heater resistor calculation and voltage adjustment
2018-09-14 Fix bug on monitor command -notime parameter
    [Commands.cpp]
2018-09-17 Reset on USB connection
    [SckBase.cpp]
2018-09-19 Testing sample adquisition
2018-09-25 Add tool for microphone A or C Weighting and csv
    [aweightingtableNORM.csv, cweightingtableNORM.csv]
2018-09-25 Optimized and updated noise tables
    [SckSoundTables.h]
2018-09-25 Added console interface to enable/disable noise debug
    [Commands.cpp, Commands.h, SckUrban.cpp]
2018-09-25 Noise Sensor enabled by default
2018-09-27 Updated to more precise Noise Equalization tables
    [SckSoundTables.h]
2018-09-27 Fixed Noise not working without starting PWM timer
    [SckUrban.cpp]
2018-10-01 New battery gauge implementation
2018-10-01 New sensor battery power
2018-10-02 Update on charger/battery implementation
2018-10-04 Removed voltin sensor (not available on charger)
2018-10-04 Charger and gauge implementation update (Almost finished)
2018-10-04 Main loop power management
2018-10-04 Updated enable/disable sensors related to battery
2018-10-04 Updated Charger and battery console commands
2018-10-05 Charger timer is now recalculated based on battery capacity and charge current limit
2018-10-05 Changed charge current limit default from 768 to 1024
2018-10-05 Battery capacity setting is persistent and saved in eeprom as part of the config structure
2018-10-05 USB detection polling instead of charger interrupt
2018-10-05 Fix I2S hang in arduino samd core
2018-10-08 Fix on SDcard failure hang
    [SckBase.cpp]
2018-10-08 Added new sensor _SDcard present_
2018-10-08 Revert "USB detection polling instead of charger interrupt"
    This reverts commit 8a04b21d0f129e44be90529b37bd0d227512026d.
    [SckBase.cpp, SckBase.h, SckBatt.cpp, SckBatt.h, SmartCitizenKit.ino]
2018-10-08 Update power only runs every 1000 ms
2018-10-08 Fixed USB connection not detected
    [SckBase.cpp, SckBatt.cpp]
2018-10-08 Led low battery notification
2018-10-08 Fix problems on battery removal detection after batteryWIP merge
    [SckBase.cpp]
2018-10-08 More battery led feedback touches
2018-10-09 More robust battery management
2018-10-09 Fix battery and USB detection problems with PM sensor enabled
    [SckBase.cpp, SckUrban.h]
2018-10-09 Boot led color is now white
2018-10-09 Charge current limit back down to 768
2018-10-09 Deep sleep on manual button off (5 seg)
2018-10-09 Improved battery detection and charge feedback
2018-10-09 Added sensor ID to internal PM
2018-10-11 Avoid sensor update when not needed
    [SckBase.cpp]
2018-10-15 Fix on Battery not recharging after being drained by PM sensor
    [SckBase.cpp, SckBatt.h]
2018-10-15 Fix building fast-Bridge on raspberry
2018-10-16 New default battery recharge threshold set to 98%
2018-10-16 Fix on ESP status json bad format
    [SckESP.cpp]
2018-10-17 Avoid trying to charge if there is no battery
    [SckBase.cpp]
2018-10-17 Create new POSTFILE if number/type of sensors has changed or kit reflashed
2018-10-22 Removed unnecessary battery percent calculation
2018-10-22 Avoid compiler warning of truncated value
    [SckSoundTables.h]
2018-10-23 Fix on publishing twice the same readings
    [SckBase.cpp]
2018-10-23 Avoid spurious battery detection
    [SckBase.cpp]
2018-10-23 Fix on wifi turning off before is needed (introduced in 968685a)
    [SckBase.cpp]
2018-10-23 Fix on ESP led not blinking fast on button induced APmode
    [SckESP.cpp]
2018-10-24 AP: 'next' button does not jump
    It used to jump up 20px after the 6 figure token had been input
2018-10-26 Support for Atlas Scientific Temperature probe
2018-10-26 Fix Atlas Scientific readings on SCK 2.0
    [SckAux.cpp]
2018-10-26 Support Atlas Scientific Temp probe for compensation on other sensors
2018-10-26 Added support for Chirp Moisture sensor
2018-10-26 Updated Atlas Scientific sensors code
2018-10-26 Update on Chirp Soil Moisture sensor code
2018-10-26 Fix on Atlas Sensor hanging
    [SckAux.cpp, SckAux.h]
2018-10-26 Removed chirp light sensor
2018-10-26 Added sensor ID to Groove ADC
2018-10-31 Support for OneWire Dallas Temperature via Auxiliary connector
2018-11-02 Fix on ESP version not updating
    [Commands.cpp, SckBase.cpp, SckBase.h, SckESP.cpp, SckESP.h]
2018-11-02 Fix build date format
    [SckBase.h, SckESP.h]
2018-11-02 Implemented MQTT info publish on every boot to device/sck/token/info
2018-11-09 Fix on empty mac address on some situations
    [SckBase.cpp]
2018-11-19 Added support for VL6180X time of flight distance/light sensor
2018-11-19 Fastest led response to config changes
2018-11-20 Fix wrong MQTT port
    [SckESP.cpp]
2018-11-20 Organized and renamed ESP webserver files. Avoid copying unnecessary files to flash. Changed index.gz to index.html.gz
    [SckESP.cpp]
2018-11-20 Fix on waking up from OFF state
    [SckBase.cpp, SckBase.h, SckButton.cpp]
2018-11-22 Fix on ESP filesystem upload error
    [SckBase.cpp]
2018-11-27 Implemented CCS811 Gas sensor (VOCs and eCO2)
2018-12-10 Correct css class name
    [index.html.gz.h]
2018-12-11 Firmware update: Style upload file button
2018-12-13 Firmware: button disabled if no file present
2018-12-13 Allow Force Update button added in info
2018-12-13 Firmware: show both error and response
    [index.html.gz.h]
2018-12-17 App: correct error color text
    [index.html.gz.h]
2018-12-18 Updates hardware design files to latests version
    [SCK_DATA_BOARD_2.1_REV_03.sch, SCK_DATA_BOARD_2.1_REV_05.sch]
2019-01-03 Fix on timers running multiple times
    [SckBase.cpp, SckBase.h]
2019-01-04 Fix on ESP not receiving config
    [SckBase.cpp]
2019-01-04 Avoid repeated messages on sdcard or config errors
    [SckBase.cpp, SckBase.h]
2019-01-04 Removed ESP reboot in case of communication errors
    [SckBase.cpp]
2019-01-04 Pop up error mesg in case of ESP communication failure
    [SckBase.cpp]
2019-01-04 Fix on MQTT hello console command
    [Commands.cpp]
2019-01-07 Fix on wrong ESP on time after RTC update
    [SckBase.cpp]
2019-01-08 Fix urban board not enabling sensors after reconnection
    [SckBase.cpp, SckUrban.cpp, SckUrban.h]
2019-01-08 Added support for PM board separated PM_A and PM_B
2019-01-14 Fix on spurious battery detection under certain conditions
    [SckBatt.cpp]
2019-01-15 Fix type on json for ESP action
    [SckESP.cpp]
2019-01-15 Sensor interval is configured with N * reading interval
2019-01-22 Implemented PM sensor extra metrics
2019-01-22 Now sensors have a priority property that defines the reading order
2019-01-22 Fix bug of extra comma after last reading on sd card logging
    [SckBase.cpp]
2019-01-25 Sensor names touches
2019-01-28 Removed repeated PM UAE sensors
2019-02-06 Add sensor list to README
2019-02-28 SAM->ESP publish is a lot smaller allowing more sensors to be published
2019-03-01 Report null value on sensor error, before -9999 was reported
    [SckBase.cpp]
2019-03-05 Fix on bad formated json
    [SckBase.cpp, SckUrban.h]
2019-03-05 ESP part on previous commit fix
    [SckESP.cpp]
2019-03-05 Fix on ArduinoJson version support
2019-03-05 Urban board PM sensor more robust and with checksum
2019-03-06 Fix bug that prevent correct output to console
    [Commands.cpp, SckBase.cpp]
2019-03-06 Avoid publishing null readings and save them as null on sdcard
    [SckBase.cpp]
2019-03-08 SCK 2.1 Hardware design files
    [SCK_DATA_BOARD_2.0_REV_05.sch, SCK_DATA_BOARD_2.1.sch, SCK_URBAN_SHIELD_2.1.sch, SCK_URBAN_SHIELD_2.1_REV_04.sch]
2019-03-15 Fix ArduinoJson version build error
2019-03-15 Removed MICS sensors
2019-03-15 Removed Max30105 sensor
2019-03-15 Removed MAX sensor from test
2019-03-15 Removed battery Gauge code
2019-03-15 Fix ArduinoJson ESP version build error
2019-03-15 Now PM sensor works independent of battery presence
2019-03-18 Integrated CCS811 VOC's sensor to urban board and removed from auxiliary
2019-03-18 Battery detection and charge management for 2.1 hardware
2019-03-18 Trying to fix I2S problems
    [variant.h]
2019-03-20 Now sensors are enabled when a urban is detected after being removed
2019-03-21 CCS sensor baseline saving and restoring on reboot event
    [SckBase.cpp, SckBase.h, SckUrban.cpp, SckUrban.h, SmartCitizenKit.ino]
2019-03-21 CCS sensor doesn't return readings during warm up period
    [SckUrban.cpp, SckUrban.h]
2019-03-21 Readings return "null" on error
    [Commands.cpp, SckBase.cpp]
2019-03-22 Simpler urban board detection
2019-03-22 Updated board testing firmware for version 2.1
2019-03-22 Only start Noise sensor once
    [SckUrban.cpp, SckUrban.h]
2019-03-25 Solve test wifi connection problems on some situations
    [SckTest.cpp]
2019-03-25 Implemented Battery percent
2019-03-28 Updated getReading functions to use sensor.state property
2019-03-28 Update Sensors allowing async responses
2019-03-28 Implemented Urban board PM sensor One shot mode
2019-03-28 Fix on ESP comm error on first boot after flashing
    [SckBase.cpp]
2019-03-29 Only publish sensors with ID
2019-03-29 Added platform ID to VOC's and ECO2 sensors
2019-04-01 Allow led forced update
2019-04-01 Integrated low power sleep mode on battery
2019-04-01 Emergency sleep on very low battery
2019-04-01 Small fix on sd card logging
    [SckBase.cpp]
2019-04-02 Fix on Setup mode not popping on IOS phones
    [SckESP.cpp]
2019-04-02 New battery percent calculation
2019-04-05 Some sleep power optimizations
2019-04-05 Fix missing console output on reading sensors
    [SckBase.cpp]
2019-04-08 Fix bug on RAM/Flash readings List that crashes the kit
    [SckBase.cpp, SckBase.h, SckList.cpp, SckList.h]
2019-04-08 Fix bug that prevents reading PM when updating RTC after sensor start
    [SckUrban.cpp]
2019-04-08 Improved low power sleep in sdcard mode
2019-04-09 Fix low power sleep and publish in network mode
    [SckBase.cpp]
2019-04-09 Avoid sleeping for a period after being configured via Setup mode
    [SckBase.cpp]
2019-04-09 Fixed problems managing readings list index
    [SckList.cpp]
2019-04-09 Error messages if ram is full
    [SckBase.cpp]
2019-04-09 Save INFO.TXT if it doesn't exist on sd card insertion
    [SckBase.cpp]
2019-04-09 Avoid fake wake Ups on sd card movements
    [SckBase.cpp]
2019-04-09 Fix CCS811 not changing mode and better power management
    [SckBase.cpp, SckUrban.cpp]
2019-04-11 Fix BUG that resets ESP continuously
    [SckBase.cpp]
2019-04-11 Make led blinks consistently during sleep mode
2019-04-11 Start led breathing from 0
2019-04-11 Fix on ESP continuous reboot
    [SckBase.cpp]
2019-04-11 Fix on Auxiliary bus not working after sleep
    [SckBase.cpp]
2019-04-17 Separated battery look up table for charging and discharging
2019-04-24 Add temperature and humidity temporary correction
    [SckBase.cpp]
2019-04-24 Fix on wrong batt percent when finished charging.
    [SckBatt.cpp]
2019-04-25 Adjust on temperature static correction
    [SckBase.cpp]
2019-04-25 On emergency low batt sleep the kit check every minute if power is back
2019-04-25 Missing details on last commit
    [SckBase.cpp, SckBase.h]
2019-04-27 Fix RTC calling external reset
    [SckUrban.cpp, SmartCitizenKit.ino]
2019-04-27 Other small rtc fix
    [SckUrban.cpp]
2019-04-29 Fix on wrong dependency versions
    [SckBase.cpp, SmartCitizenKit.ino]
2019-04-29 Sync time after every boot to minimize RTC problems
    [SckBase.cpp, SckBase.h]
2019-05-02 New battery look up table while charging
2019-05-02 Fix on wrong battery table name
    [SckBatt.cpp]
2019-05-02 Fix on Kit not waking up after library update
    [SckBase.cpp]
2019-05-02 Avoid reading sensors and force sync time on miss configured RTC
    [SckBase.cpp]
2019-05-04 Some small battery look up table changes
2019-05-04 Reset to a clean state if RAM is full after several errors
    [SckBase.cpp]
2019-05-05 Changed low battery and emergency sleep thresholds
2019-05-05 Fix on not waking up if sd card was removed during Off state
    [SckBase.cpp]
2019-05-06 Fix on sdcard interrupt avoiding proper boot
    [SckBase.cpp]
2019-05-06 Improvements on battery discharge curve
2019-05-06 Fix wrong output on debug command
    [Commands.cpp]
2019-05-06 Changed Low Batt and emergency thresholds to 20% and 10% Fixed problems with voltage variations produced by PM sensor
    [SckBase.cpp, SckBatt.cpp, SckBatt.h]
2019-05-06 Fix Sanity reset not triggering after entering sleep mode
    [SckBase.cpp]
2019-05-07 Workaround on RTC bug that triggers reset
    [SckBase.h, SmartCitizenKit.ino]
2019-05-31 Rewrite SD card header on enable/disable sensor
2019-05-31 Don't cut power to auxiliary sensors on sleep
2019-06-03 Lower battery recharge threshold to 4.1
2019-06-04 Added charger function to set Minimum System Voltage Limit and set it to 3.3v
2019-06-04 Test plan work: * Added retry for testing sensors * Simplified and reorganized code * Flash testing reimplemented
2019-06-11 Reboot ESP on entering network mode to start from fresh state
    [SckButton.cpp]
2019-06-11 On PM sensor error, returned reading is null instead of 0
    [SckUrban.cpp]
2019-06-13 Light sensor: correct name and datasheet
    [SckUrban.cpp, SckUrban.h]
2019-06-13 Fix on light sensor returning zero
    [SckUrban.cpp, SckUrban.h]
2019-06-13 Correct wrong type on previous light sensor commit
    [SckUrban.cpp]
2019-06-18 Removed sleep mode on flash (was causing problems)
    [SckList.cpp, SckList.h]
2019-06-18 SHT31 is now more tolerant to timing problems and retry in case of error
    [SckAux.cpp, SckUrban.cpp, SckUrban.h]
2019-06-20 Correct publish interval validation in console command
    [Commands.cpp]
2019-06-20 Workaround CCS811 not reporting at intervals smaller than 60 seconds
    [SckUrban.cpp]
2019-06-23 Light sensor variable Integration Time
2019-06-26 Fix CCS811 wait period between readings
    [SckUrban.cpp]
2019-06-26 Added debug prints to CCS811 driver
2019-06-26 For boards test set CCS811 drive mode to 1 second
2019-06-26 Fix kit not continue publishing after on some situations
    [SckBase.cpp]
2019-07-22 Fix Kit not waking up in some situations
    [SckBase.cpp]
2019-07-22 Cleaning hardware files
    [SCK_DATA_BOARD_2.0_REV_05.sch, SCK_DATA_BOARD_2.1.sch, SCK_URBAN_SHIELD_2.1.sch, SCK_URBAN_SHIELD_2.1_REV_04.sch]
2019-07-24 Missing changes on flash last commit
    [SckList.cpp]
2019-07-24 Usertoken: Perform check when button is pressed
    It was checking after every keyboard input. This stopped working in
    newer versions of Vue js. 2.5.13 Worked fine but 2.6 does not f.x.
    Related to Android virtual keyboard. Both Chrome and Firefox on Android
    stopped counting the charaters on every input.
2019-07-24 Usertoken: add error msg
    [index.html.gz.h]
2019-07-29 Fix bug that breaks some config commands
    [Commands.cpp]
2019-07-30 Fix kit not taking readings on wifi error
    [SckBase.cpp]
2019-07-30 Comment on TODO fix
    [SckBase.cpp]
2019-07-30 Fix error when changing from net to sd mode with readings on ram
    [SckBase.cpp]
2019-08-21 Added Chirp moisture sensor reset command to recover defualt I2C address
    [SckAux.cpp, SckAux.h]
2019-08-21 Fix chirp control command return String
    [SckAux.cpp]
2019-08-21 Fix kit not waking up on button click
    [SckBase.cpp]
2019-08-23 Chirp reset addres command is now automatic, you just need to do: control moisture reset
    [SckAux.cpp, SckAux.h]
2019-08-26 Stop urban board disabled sensors on boot. Important for PM
2019-08-27 Soil moisture sensor calibration interface. Calibration data is saved on SAM flash. After calibration normal Soil Moisture sensor returns percent. New Soil Moisture RAW sensor delivers capacitance. I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
2019-08-27 Fix monitor console command
    [Commands.cpp]
2019-08-28 Updated INA219 auxiliary sensor to use auxWire bus
2019-09-26 Register script again prints link of the created kit
2019-09-26 Adjusted INA219 settings so it allows more than 400 mAh range
2019-11-04 First release of battery calculator
2019-12-11 Fixed schematics PDFs misssing pages
2020-01-27 Removed tools directory to replace it with submodule
    [aweightingtableNORM.csv, cweightingtableNORM.csv]
2020-03-16 Battery capacity can be configured via shell
2020-03-16 Added unit to battery capacity report
2020-03-18 Fix bug that prevents per sensor intervals to work
    [SckBase.cpp]
2020-03-20 Power focused commit. * Kit now go to sleep with and without battery after sleep timer. (solar panel friendly) * Shell configurable sleep timer (30 min default). * Button or sd card events keep kit a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
2020-03-24 Sleep timer now works properly
2020-04-29 Fix bug: no sdcard saving if readings end exactly in last sector address
    [SckBase.cpp, SckList.cpp]
2020-04-29 Fix error on last commit
    [SckBase.cpp]
2020-04-29 Report current sector as "In use" on flash -sector shell command
2020-05-06 PM sensor monitor mode fix
    [Commands.cpp, SckBase.h, SckUrban.cpp, SckUrban.h]
2020-05-19 Fix several typos and minor bugs on flash code
    [SckBase.cpp, SckList.cpp]
2020-07-01 Avoid setting probe type for Electric Conductivity on sensor init
    [SckAux.cpp]
2020-07-01 Implemented Atlas Scientific Total Dissolved Solids sensor.
2020-07-01 Implemented Atlas Scientific Salinity sensor.
2020-07-01 Updated comment with calibration commands
2020-07-02 Fix SAM upload script typo
    [uploadSAM.py]
2020-07-02 Assigned Atlas TDS and Salinity sensors id
2020-07-09 Set sleep timer to 1 min for testing purposes
2020-07-09 Removed ArduinoLowPower library
2020-07-09 Missing line on last commit
    [SckBase.cpp]
2020-07-09 Simplified sanity reset code
    [SckBase.cpp, SckBase.h, SmartCitizenKit.ino]
2020-07-09 After sanity reset go to sleep without waiting for user timer.
    [SckBase.cpp, SckBase.h]
2020-07-09 Sleep timer 30 min as default
2020-07-10 Implemented Grove GPS latitude sensor
2020-07-13 Defined generic GPS sensors
2020-07-14 Store GPS source readings in a struct. Print error when still no GPS fix.
    [SckAux.cpp, SckAux.h, SckBase.cpp]
2020-07-20 Fix hang when no GPS is present
    [SckAux.cpp, SckBase.cpp]
2020-07-20 Implemented Sparkfun XA1110 I2C gps as GPS source
2020-07-20 Report reading error on Sparkfun XA1110 Gps invalid data
    [SckAux.cpp]
2020-07-20 Support GNGGA sentence for fix quality
    [SckAux.cpp]
2020-07-24 Changed shell "sensor" command syntax order. Support sensor names with spaces on shell "sensor" command. Improved shell help message
2020-07-27 Shell sensor command changes all PM by groups
2020-07-27 Keep PM sensor on if reading interval is too short
    [SckUrban.cpp, SckUrban.h]
2020-07-27 Fix WiFi scan not finding networks
    [SckESP.cpp, SckESP.h]
2020-07-29 Implemented ADS1x15 ADC as external sensor
2020-07-31 Fix error on satellite number report of XA111GPS implementation
    [SckAux.cpp]
2020-08-03 Correct Grove oled sensor name
    [SckAux.cpp, SckAux.h]
2020-08-05 Avoid showing Oled display on sdcard readings
    [Commands.h, SckBase.cpp]
2020-08-07 Implemented error state variable
    [SckBase.cpp, SckBase.h]
2020-08-07 Implemented Oled display error reporting
    [SckAux.cpp, SckAux.h]
2020-08-07 Added Oled display low battery error message
    [SckBase.cpp]
2020-08-10 Added config option to select wich sensors show on oled display
2020-08-11 Implemented oled display sensor readings loop
2020-08-11 Fix bug on sdcard mode that enters in ESP reset loop on some situations
    [SckBase.cpp]
2020-08-24 Fix oled debug screen
    [SckAux.cpp]
2020-08-28 Fixes on ESP buffer management
    [SckESP.cpp, SckESP.h]
2020-08-31 Fix debug settings not being saved
    [Commands.cpp]
2020-08-31 Save only readings that are new when sensors have different intervals
2020-08-31 Increase I2S initialisation time to avoid microphone ramp up period
    [SckUrban.cpp]
2020-08-31 Fix not retrying publish after MQTT error
    [SckBase.cpp]
2020-08-31 Fix diff when RTC update happens before saving readings
    [SckBase.cpp]
2020-09-01 Add test for ADS1X15 using gases board current tester and fix gain voltage ranges
    [SckAux.cpp, SckAux.h]
2020-09-01 Improved WiFi error management on long offline periods
    [SckBase.cpp, SckBase.h]
2020-09-03 Implemented persistent disabling of external sensors via console
2020-09-03 Fix sensor enable state not loaded (error on last commit)
    [SckBase.cpp]
2020-09-04 Fix wrong scratchpad array size on DS18B20 Temp sensor
    [SckAux.h]
2020-09-04 Fix compiler warnings and clean up
    [Commands.cpp, SckAux.cpp, SckBase.cpp, SckBase.h]
2020-09-04 Fixed more compiler warnings and typos.
    [SckBase.cpp, SckBase.h, SckUrban.cpp]
2020-09-04 Fix not detected external sensors showing on oled display
    [Commands.cpp, SckAux.cpp, SckBase.cpp]
2020-09-04 Update SAM core to 4.5.1
    [arduino_zero.cfg]
2020-09-04 Update SAM and ESP ArduinoJson Libs to 6.16.1
2020-09-15 Update Dallas Temperature libs
2020-09-15 Update Adafruit Unified Sensor libs
2020-09-15 Change error priority level
    [SckBase.cpp]
2020-09-17 Fix PM sensor failing to start
    [SckBase.cpp, SckUrban.cpp]
2020-09-18 Fix PM readings update and monitor mode.
    [Commands.cpp, SckUrban.cpp, SckUrban.h]
2020-09-22 Fix error on json buffer size that messes SAM<->ESP communication.
    [SckBase.cpp, SckESP.cpp]
2020-09-22 Fix telnet debug not being saved on ESP config file
    [SckESP.cpp]
2020-09-28 Allow reading sensors when no sd card present on sd mode (flash saving)
2020-09-28 Now NEOM8U gps returns NULL instead of zero when there is no fix.
    [SckAux.cpp]
2020-09-28 Fix sensor reading on dynamic interval
    [SckBase.cpp]
2020-09-28 Avoid turning PM off when dynamic interval is on
    [SckUrban.cpp]
2020-09-28 Missing correction on last commit
    [SckBase.cpp]
2020-09-28 Simplified sleep loop and avoid sleeping on dynamic interval
    [SckBase.cpp, SckBase.h]
2020-09-30 NEOM8UGPS now return readings when available even with fix=0
    [SckAux.cpp]
2020-10-02 Avoid wrong RTC sync from GPS
    [SckAux.cpp]
2020-10-02 Fix debug speed print
    [SckBase.cpp]
2020-11-19 Add GPS sensor ids
2020-11-30 Allow setting custom MQTT broker host address and port via console.
    [Commands.cpp, Commands.h, SckBase.cpp, SckESP.cpp, SckESP.h]
2020-12-02 Manage external PM-board PM's A/B as separate instances. Removed external PM-board PM's average sensor.
2020-12-11 Disable EXT_PN sensors by default
2020-12-14 Fix wrong date on flash sector info command
    [SckList.cpp]
2020-12-18 Detect if ADC is present before taking reading to avoid bypassing errors
    [SckAux.cpp]
2020-12-22 Add hardware prod files and silkscreen
2021-01-25 Improve sensor detection and enable state persistence.
2021-01-25 Fix time sync error not dissapearing after sync on sdcard mode
    [SckBase.cpp]
2021-01-25 Fix led not updating after exit shell mode via console
    [Commands.cpp]
2021-01-26 Fix bug that prevents sensor group to be published when sector has no free bytes left
    [SckList.cpp]
2021-01-26 Fix bug: Avoid re-publishing old readings when changing mode configuration.
    [SckBase.cpp, SckList.cpp, SckList.h]
2021-01-26 Revert "Fix bug: Avoid re-publishing old readings when changing mode configuration."
    This reverts commit 7ac6b171b33cd086798c6da20e6fa29f7098e803.
    [SckBase.cpp, SckList.cpp, SckList.h]
2021-01-26 Fix: Avoid re-publishing old readings when changing mode configuration.
    [SckBase.cpp, SckList.cpp, SckList.h]
2021-01-26 Keep saving readings on flash independently of errors
    [SckBase.cpp]
2021-01-26 Fix errors and improve flash state console report.
    [Commands.cpp, SckList.cpp, SckList.h]
2021-01-26 Travis: print Platformio version
2021-01-28 Fix bug that prevents saving to flash on full sector
    [SckList.cpp, SckList.h]
2021-02-05 Update ArduinoJson lib to 6.17.2
2021-02-05 Fix wrong path on I2S utility file
    [uploadSAM.py]
2021-02-08 Static Arduino Crore version fixed to 1.8.9 to avoid compilation errors
2021-04-14 Allow sharing I2C 0x61 address between Atlas DO and SCD30
2021-04-15 Added support for Sensirion SCD30 CO2 sensor
2021-04-19 SCD30: Added Forced calibration, Temperature offset, Pressure compensation
2021-05-07 Add sensor ids for temperature and humidity of SCD30
2021-05-13 Only sleep when timer has passed after dynamic interval.
2021-05-17 Fix led feedback on time sync error when WiFi fails
    [SckBase.cpp]
2021-05-18 Sensor command now prints number of intervals and seconds
2021-05-18 Fix speed monitoring disturbing normal speed readings
    [SckBase.cpp, SckBase.h]
2021-05-19 Fix kit not sleeping after WiFi error
    [SckBase.cpp]
2021-05-19 Use GPS fix and hdop to minimize fake speed readings triggering dynamic interval
    [SckBase.cpp, SckBase.h]
2021-05-20 Fix bug on flash when searching for unpublished groups
    [SckList.cpp]
2021-06-01 Fix problem on selecting new flash sector after memory is full
    [SckList.cpp]
2021-06-02 Avoid possible error on flash sector command
    [Commands.cpp]
2021-06-02 Fix buffer overflow on printing flash info
    [SckList.cpp]
2021-06-07 Fix bug on flash when only one byte was left on sector
    [SckList.cpp]
2021-06-11 Fix not publishing after sleep without GPS
    [SckBase.cpp]
2021-06-14 Fix bug that prevents finding next potencial group to be published
    [SckList.cpp]
2021-06-14 Fix old sectors being ignored
    [SckList.cpp, SckList.h]
2021-06-16 With a read interval < 30 sec PM sensor is always on
2021-06-16 Fix typo and remove double debug msg
    [SckESP.cpp]
2021-06-16 Publish/readings state organization to avoid hangs
    [SckBase.cpp]
2021-06-16 Block (with timeout) after sending readings to force serial updates as fast as possible and avoid communication errors
    [SckBase.cpp]
2021-06-16 Reset ESP after config to force reconnection
    [SckBase.cpp]
2021-06-16 Add missing correction on commit c6337a2
    [SckUrban.cpp]
2021-06-17 Fix kit not publishing on saving config without WiFi available
    [SckBase.cpp]
2021-06-20 Fix reporting wrong group index on flash saving
    [SckList.cpp]
2021-06-20 Revert to using PDOP (HDOP is very slow)
    [SckAux.cpp, SckBase.h]
2021-06-21 Fix warning feedback not showing after mode change
    [SckBase.cpp, SckButton.cpp]
2021-06-21 Avoid too much console output
    [SckBase.cpp]
2021-06-21 Fix batch publishing not reaching current sector on first try
    [SckList.cpp]
2021-06-21 Fix sanity reset on sleep state
    [SckBase.cpp]
2021-06-21 Fix reading interval taking more than configured
    [SckBase.cpp]
2021-07-19 Fix SCD30 Forced recalibration factor setting
    [SckAux.cpp, SckAux.h]
2021-09-20 Fix typo on new read interval evaluation
    [Commands.cpp]
2021-09-20 Fix disabling urban sensors persistence
    [SckBase.cpp]
2021-09-20 Fix error on enable/disable PM/PN sensor groups
    [Commands.cpp]
2021-11-23 Added Support for external SHT35 Temperature and Humidity sensor
2021-12-13 Added PM sensor debug messages
2021-12-13 Fix PM reporting zero on first two readings
    [SckUrban.cpp, SckUrban.h]
2021-12-15 Avoid turning off PM sensor on sleep when reading interval is too short
    [SckBase.cpp]
2021-12-21 Fix compiler warning and verifiy received value on SCD30 control interface
    [SckAux.cpp, SckAux.h]
2022-03-30 Fix Sanity reset not always triggering
    [SckBase.cpp, SckBase.h]
2022-04-01 Added PM debug prints
2022-04-01 PM last reading now uses rtc instead of millis and warmUp as trigger period
2022-04-01 Needed for old PM sensors: longer Serial timeout, more strict command verification, and clearing buffer
2022-04-01 PM old sensors set passive mode on each wakeUp and add small delay between commands
2022-07-19 Change boot order to prevent reset caused by high current draw
    [SckBase.cpp]
2022-09-08 Add ID for ORP sensor
2022-09-12 Fix sdcard not detected on boot
    [SckBase.cpp, SckBase.h]
2022-09-28 Don't apply temperature compensation to ORP sensor
2022-09-28 Added Atlas temperature to the control interface
2022-10-06 Fixed typo in Sensors.h affecting shell usage GPS (Traked->Tracked) Satellites
2022-11-10 Correct Grove ADC address (0x50)
    [SckAux.h]
2022-11-10 Fix Atlas EC hang on some situations
    [SckAux.cpp, SckAux.h]
2023-01-12 Added priority level for error msgs, and save them to sd log
    [SckBase.cpp, SckBase.h]
2023-03-23 Implemented config to disable sanity reset via shell
    [Commands.cpp, Commands.h, SckBase.cpp]
2023-04-18 Side by side buttons in esp setup
2023-05-11 Fix Atlas EC not receiving all data on very long readings
    [SckAux.cpp]
2023-05-11 Fix Atlas temperature compensation not using DS18B20 sensor
    [SckAux.cpp]
2023-05-18 Improved Urban board startup
2023-05-18 Fix startup hang on External SHT Temp/Hum sensor
    [SckUrban.cpp]
2023-05-23 SPS30 Fixes and improvements
    [Commands.cpp, SckUrban.cpp, SckUrban.h]
2023-05-23 SPS30 sleep function is n ow public (missing in last commit)
    [SckUrban.h]
2023-05-23 Don't print error message when urban board sensors are not detected
    [SckBase.cpp]
2023-05-23 Fix PM not sending proper sensor state after urgan getReading() refactor
    [SckUrban.cpp]
2023-05-23 Fix on Sensirion lib not detecting SAMD I2C size
    [SckUrban.cpp, variant.h]
2023-05-23 Fix detection for SEN5X models
    [SckUrban.cpp]
2023-05-30 Implemented auxiliary SFA30 Formaldehyde Sensor Module
2023-06-02 Added SFA30 platfor id's and fixed some start issues on the same sensor.
    [SckAux.cpp]
2023-06-12 Added defines to disable sensors on build to save RAM
2023-06-13 Avoid SEN5X to trigger cleaning after new firmware upload.
    [SckUrban.cpp]
2023-06-16 Hardware info now contains last reset cause
    [SckBase.cpp]
2023-06-22 Implemented RSSI WiFi signal as a sensor
2023-07-05 Updated arduino core
2023-07-06 Updated led code, brightness can be adjusted, breathing while booting to detect hangs
2023-07-06 Missing from led brightness commit
2023-07-10 Fix led not updating on STATIC mode
    [SckLed.cpp]
2023-07-11 Moved BME68X to Urban Board Sensors
2023-07-14 SEN5X sensor now saves VOCS state and restores it when needed
2023-07-17 Added platform ID to several sensors
2023-07-17 Removed sensor control property, wasn't used
2023-07-18 Removed Arduino String from sensor functions
2023-07-24 Add LPS33 Barometric pressure sensor
2023-10-19 ifdef disable CCS811 and comment on fix compiling
    [SckBase.cpp, SckUrban.cpp, SckUrban.h]
2023-10-23 Save and restore VOC state correctly
    [SckUrban.cpp, SckUrban.h]
2023-10-27 Fix missing ifdef for SEN5X init
    [SckBase.cpp]
2023-10-30 Rename Sck_PM to Sck_PMS to avoid confusion
    [Commands.cpp, SckAux.cpp, SckAux.h, SckBase.cpp, SckUrban.cpp, SckUrban.h]
2023-10-30 Add ifdefs for pressure sensors and rename MPL
2023-10-30 Urban Sensors 2.2 and datasheet fix for LPS33
    [SckUrban.h]
2023-11-14 Change LPS Sensor name for consistency
2023-11-27 Fix missing csv speed file update to new sckfile model
    [SckBase.cpp]
2023-12-20 Default activated sensors per env
2024-02-27 SEN5X: sensors are now automatically enabled/disabled and its interval changed in groups: PM, PN, TH, VOC and NOX
2024-02-29 Minor fix on aux wire test firmware output
    [SckTest.cpp]
2024-02-29 Add hardware for SCK2.2
    [01-SCK_DATA_BOARD_2.2_BOM.xlsx, 01-SCK_URBAN_BOARD_2.2_BOM.xlsx, 03-SCK_DATA_BOARD_2.2_PCB_specification.xlsx, 03-SCK_URBAN_BOARD_2.2_PCB_specification.xlsx, SCK_DATA_BOARD_2.1.sch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]
2024-03-05 Enforce reset after using shell mode to get a clean state
    [Commands.cpp, SckBase.cpp]
2024-03-05 Make ESP error visible to the user
    [SckBase.cpp]
2024-05-17 Only send compensation in atlas sensors when needed
2024-05-27 Add temperature and humidity corrections for all modes and depending on SCK21 or SCK22
    [SckBase.cpp]
2024-05-29 Improve corrections for temperature and relative humidity, also in sd card mode
    [SckBase.cpp]
2024-06-03 Improve T correction of 2.1
    [SckBase.cpp]
2024-06-06 Only send temperature command if temperature reading is valid
2024-07-24 Hardware files for SCK2.3 - WIP
    [01-SCK_DATA_BOARD_2.3_BOM.xlsx, 01-SCK_URBAN_BOARD_2.3_BOM.xlsx, 03-SCK_DATA_BOARD_2.3_PCB_specification.xlsx, 03-SCK_URBAN_BOARD_2.3_PCB_specification.xlsx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]
2024-09-10 Reorganize hardware files and fix readme
    [01-SCK_DATA_BOARD_2.3_BOM.xlsx, 01-SCK_URBAN_BOARD_2.3_BOM.xlsx, 03-SCK_DATA_BOARD_2.3_PCB_specification.xlsx, 03-SCK_URBAN_BOARD_2.3_PCB_specification.xlsx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]
2024-10-04 Atlas delay should be sufficient after transmission is ended to avoid non-ready data
    [SckAux.cpp]
2024-10-04 Add sleep wakeup to atlas drivers and avoid erroneous data on wake
    [SckAux.cpp, SckAux.h]
2024-10-28 Revert delay position. Increment to shortwait
    [SckAux.cpp]
2024-10-28 WIP tcomp command for atlas sensors
2024-10-28 Add commands to enable temperature compensation on atlas sensors
2024-11-20 Turn off all SEN5X metrics when button is down.
2024-11-21 Fix ifdefs for external temperature sensor
    [SckAux.cpp]
2024-11-25 Minor fix on output of atlas control sensor command
    [SckAux.cpp]
2025-03-25 Urban Board Silkscreen
2025-07-21 Remove ADS1X15 fork
    Remove the fork as adafruit has refurbished it and we do not need a fork for this anymore. They can now pass a Wire object to the begin.
2025-08-07 Fix VOCstate buffer size bug and add model checks
    * Fixes size for VOC state accounting for CRC
    * Adds checks for model version clash
    [SckBase.cpp, SckUrban.cpp, SckUrban.h]
2025-09-03 Fix continuous mode readings
    If continuous mode is activated most SEN5X readings went wrong because
    the already read values weren't returned but get_reading() returned an
    error state. By checking if update() failed because of no new values
    available in continuous mode (SEN54 and SEN55) we can return the stored
    values safely.
    [SckUrban.cpp]
2025-09-09 Test on SCK reboot for retrieving VOC state from sensor
    [SckBase.cpp, SckUrban.cpp, SckUrban.h]
2025-09-12 Fix returned buffer on VOCstate as it doesn't include CRC
    [SckUrban.cpp]
2025-09-18 Create interface for SHT31 custom calibration
2025-09-18 Adds rht calibration to external sensors
    * Minor fixes in WITH_RANGE define
    * Adds clear command to reset calibration to default
    [SckAux.cpp, SckAux.h, SckUrban.cpp, SckUrban.h]
2025-09-18 Fix humidity offset type
    [SckAux.cpp, SckUrban.cpp]
2025-09-18 Add SHT31 in external sensor name to allow parsing of commands
2025-09-18 Fix not taking oled defaults
    [SckBase.cpp]
2025-09-23 Change default sensor enables for SEN54 and SEN55
2025-09-25 Change default sensor enables for SEN54 and SEN55 Bump SAM version
2025-10-12 Fix upload script for newer Python version
    [uploadESP.py]
2025-10-12 Disable softAP during startup
    To avoid a default popup WiFi network during ESP startup we explicitly
    disable it as early as possible.
    [SckESP.cpp]
2025-10-14 Fix shell parameter parsing
    It doesn't make sense to parse more tokens if the current one fails.
    TODO: Word in input should match a complete word in title and not just a
    substring.
2025-11-27 Fix sensor name for AS7331 UVC in Sensors.h
2026-05-18 Add new case for password error on ESP
    [SckESP.cpp]
2026-05-18 Fix typo detected by pral2a/Claudio on other PR
    [SckESP.cpp]
2026-05-18 Replace "!!!" on error logs. Make error logs consistent
    [SckBase.cpp]
2026-05-18 Make switch-case statement consistent with brackets
2026-05-18 Fix error reported by Claudio and pral2a
    [SckTest.cpp]
2026-08-19 Search and replace for wich typo
    [Commands.cpp, SckAux.cpp, SckAux.h, SckBase.cpp, SckBase.h, SckBatt.cpp, SckBatt.h, SckLed.cpp]
2026-08-21 Abstract SckFFT into it's own template class
    * Make template class for reusable sample processing
    * Add 128 bitrev and twiddle tables
    * Add peak frequency detection to noise readings
    [SckFFT.cpp, SckFFT.h, SckTables.h, SckUrban.cpp, SckUrban.h]
2026-08-21 Small fixes on SFA30 class
    [SckAux.cpp, SckAux.h]
2026-08-21 Remove debug comments from noise
    [SckUrban.cpp]
2026-08-21 Do not enable if library doesn't start sensor
    [SckAux.cpp]
2026-08-21 Avoid processing if no successful reading achieved
    [SckAux.cpp]
2026-08-21 Increase sensor id - we passed uint8_t limit
2026-08-21 Fix build flow, avoid multiple commands
2026-08-24 Fix some coderabbit feedback
    [SckAux.cpp]
2026-08-24 Add factory reset command
    [SckAux.cpp, SckAux.h]
2026-08-24 Move lastRead after no error confirmed
    [SckAux.cpp]
2026-08-24 Return false if startMeasurement fails
    [SckAux.cpp]
2026-08-24 Various fixes in temperature offset calibration
    [SckAux.cpp, SckAux.h]
2026-09-04 Avoid LED sending error if WiFi is connected
    [SckBase.cpp, SckBase.h]
2026-09-04 Attempt to print data on screen even if there is WiFi failure, while showing a banner
    [SckAux.cpp, SckAux.h]
2026-09-10 Fix sensor stop metrics in AS7341
    [SckAux.cpp]
2026-09-10 Add reclock calls for aux wire and oled compatibility
2026-11-10 Add watchdog timer (WDT) to recover from SAM hangs
    The hardware WDT runs from its own clock generator (GCLK5 <- OSCULP32K/32,
    1024 Hz). The previous attempt (wdt branch) reconfigured GCLK2, which
    RTCZero uses to clock the RTC from the 32.768 kHz crystal, so the RTC ended
    up running from the inaccurate ULP oscillator and drifted.
    - Hardware period 16 s; Early Warning interrupt every 8 s re-arms it while
    the main loop keeps calling wdt.feed(), giving a ~60 s software timeout
    (SCK_WDT_TIMEOUT_S). If interrupts are blocked the hardware resets in 16 s.
    - feed() only clears a counter (no 5.8 ms register sync stall).
    - On the last Early Warning the interrupted PC/LR are saved in a .noinit
    RA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
2026-11-10 Reset and report the crash location on HardFault
    The Arduino default HardFault handler loops forever with the highest
    priority, so neither the WDT Early Warning nor anything else runs and the
    kit stays frozen until the hardware WDT fires (or forever without WDT).
    Save the faulting PC/LR in .noinit RAM and reset immediately. The info is
    reported like the WDT hang info (boot, rcause, MQTT info "fault").
    This catches a pre-existing crash (heap corruption, faults inside malloc)
    that happens on the first boot after flashing, when the config stored in
    flash is invalid and defaults are loaded. It also happens on master.
2026-11-10 Discard ESP serial messages bigger than the receive buffer
    SckSerial::receive() used the size field from the wire without checking
    it against NETBUFF_SIZE, so a corrupted header (ex. ESP boot noise) could
    overflow buff and the objects placed after it in RAM.
2026-11-10 Report reset cause to the platform on boot, before starting sensors
    In network mode, publish the kit info (which includes the reset cause and
    the WDT hang / HardFault location) right after loading the config, before
    the urban board and auxiliary sensors are powered. Resets that happen
    during sensor startup (ex. the USB-only reset loop of #98) are reported
    instead of being lost.
    - Runs only the network part of the state machine (no sensors, no shell),
    bounded by SCK_BOOT_REPORT_TIMEOUT (30 s). On failure the info is sent
    later by the normal flow, as before.
    - The ESP is turned off afterwards so sensor startup keeps the same power
    profile as before (the ESP is turned on again at the end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
