fablabbcn/smartcitizen-kit-2x/(notices)

Notices in the files:
parts and their libraries:
SparkFun-PowerSymbols: Licensing: Creative Commons ShareAlike 4.0 International - https://creativecommons.org/licenses/by-sa/4.0
Hangar3D: COPYRIGHT: Copyright (C) 2023 Ultra Librarian. All rights reserved.
